IvLabs/HuroCup/Scrum/Cyberphysical Architecture2.jpg

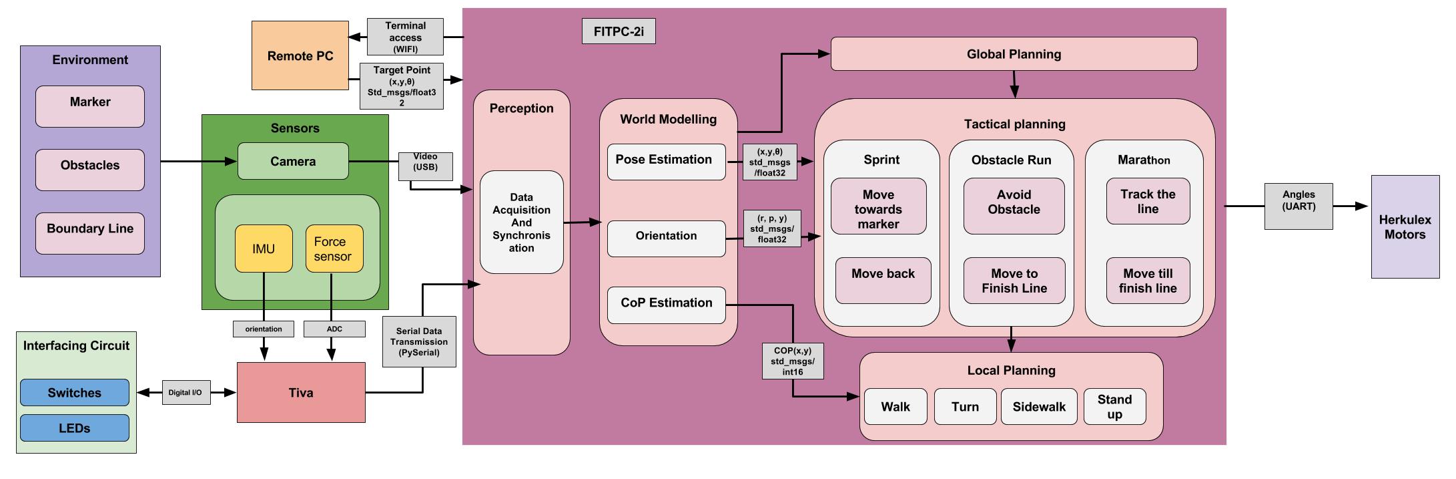
Scrum/Cyberphysical Architecture2.jpg
