IvLabs/HuroCup/Cad design/Simulated_Edit 2/tm4c.JPG

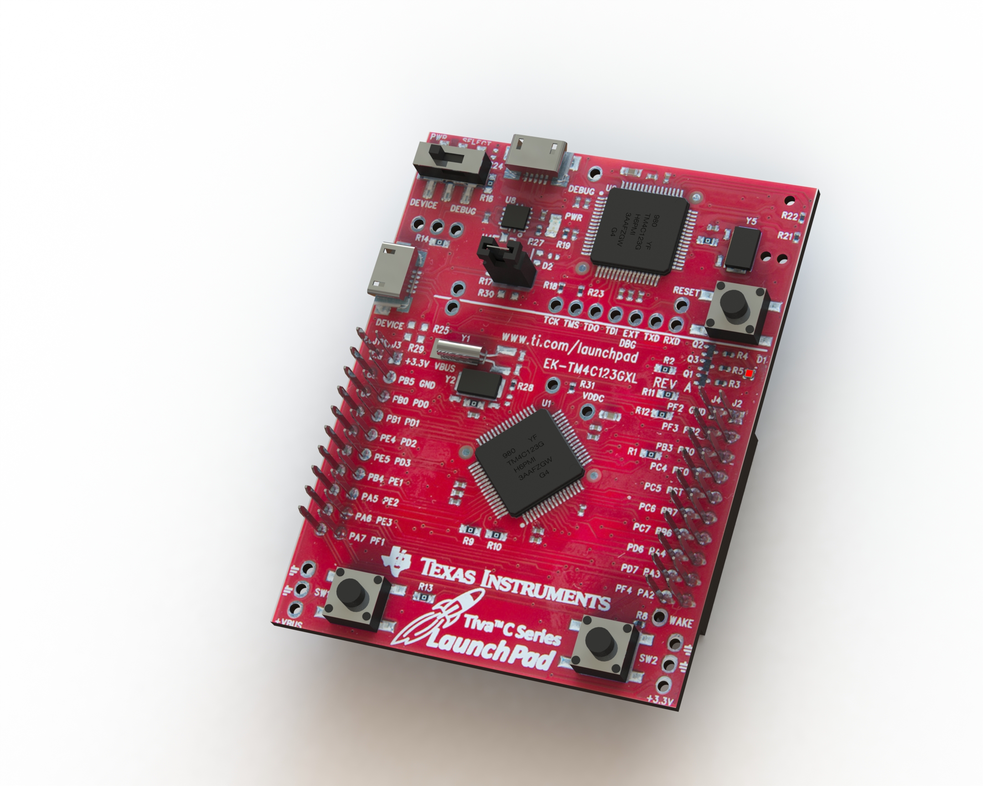
Cad design/Simulated_Edit 2/tm4c.JPG
