IvLabs/HuroCup/+Angles/swingfoot_traj.jpg

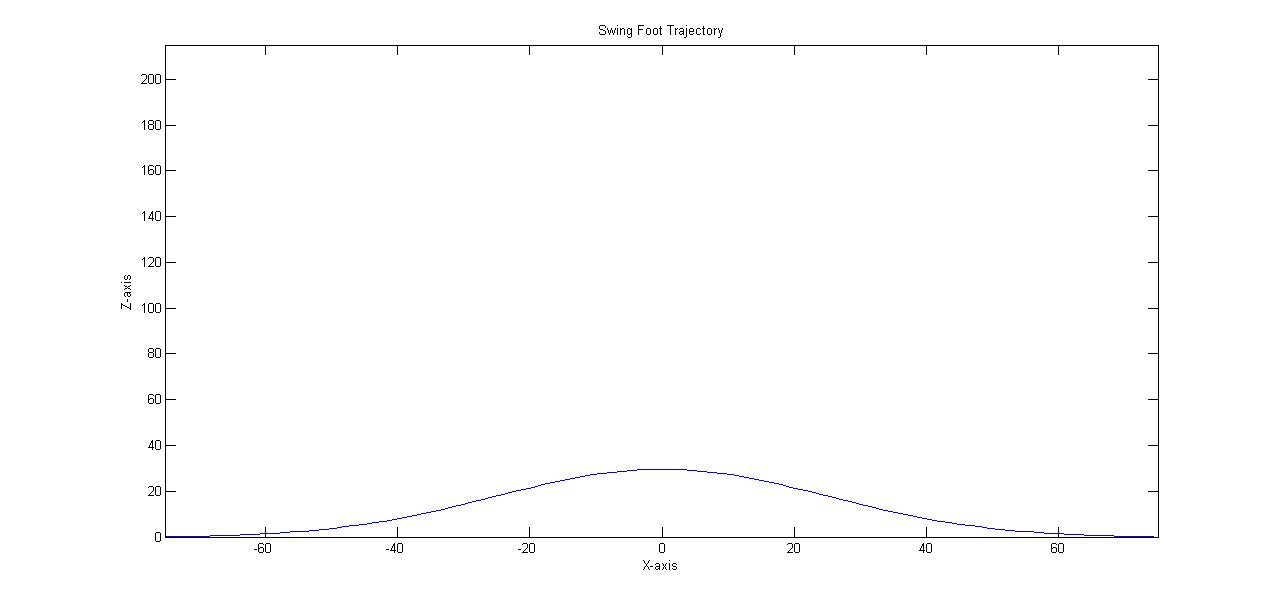
+Angles/swingfoot_traj.jpg
