IvLabs/HuroCup/+Angles/transformation_matrix.JPG

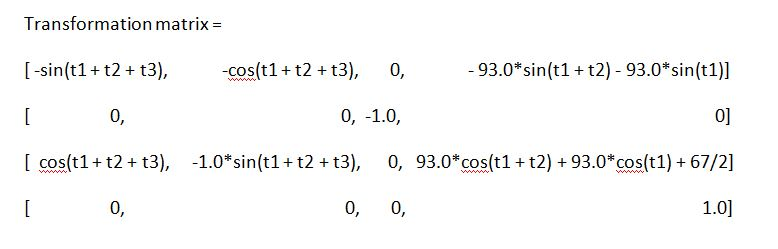
+Angles/transformation_matrix.JPG
