IvLabs/HuroCup/+Lipm/Getting ankle pitch using LIPM.jpg

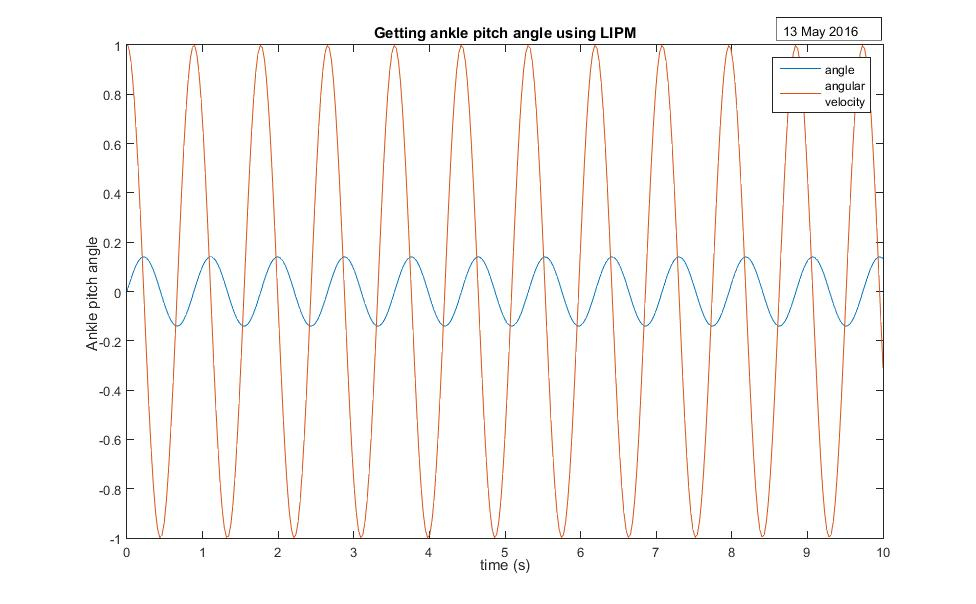
+Lipm/Getting ankle pitch using LIPM.jpg
