IvLabs/HuroCup/Circuit_Cad_Version-1.0/3.3Volts.JPG

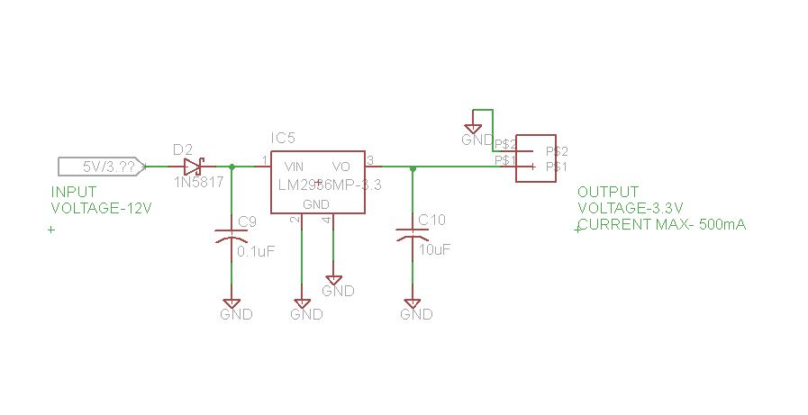
Circuit_Cad_Version-1.0/3.3Volts.JPG
