IvLabs/HuroCup/Circuit_Cad_Version-1.0/5Volts.JPG

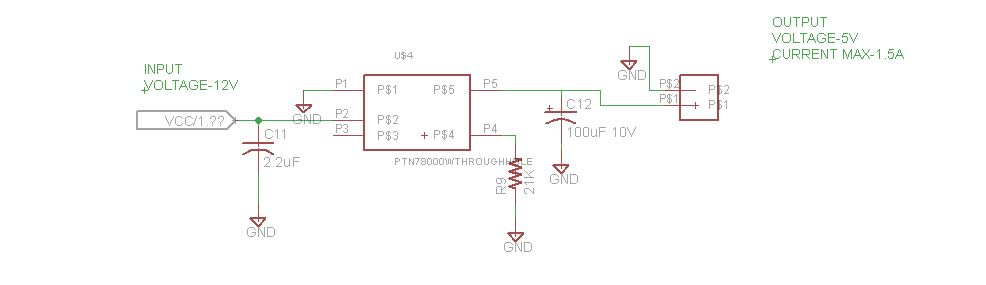
Circuit_Cad_Version-1.0/5Volts.JPG
