IvLabs/HuroCup/Circuit_Cad_Version-1.0/feedback_lipo.JPG

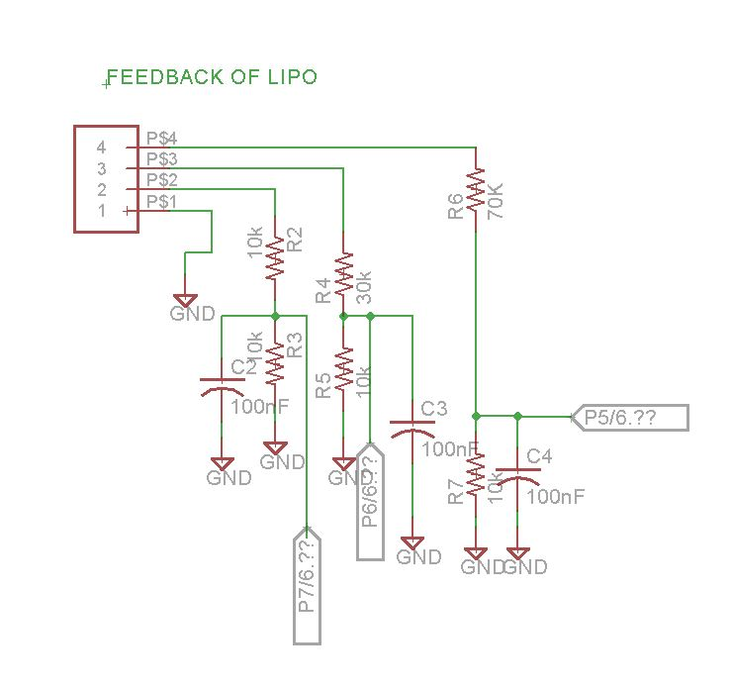
Circuit_Cad_Version-1.0/feedback_lipo.JPG
