IvLabs/HuroCup/Circuit_Cad_Version-1.0/Motors_Switching_Circuit.JPG

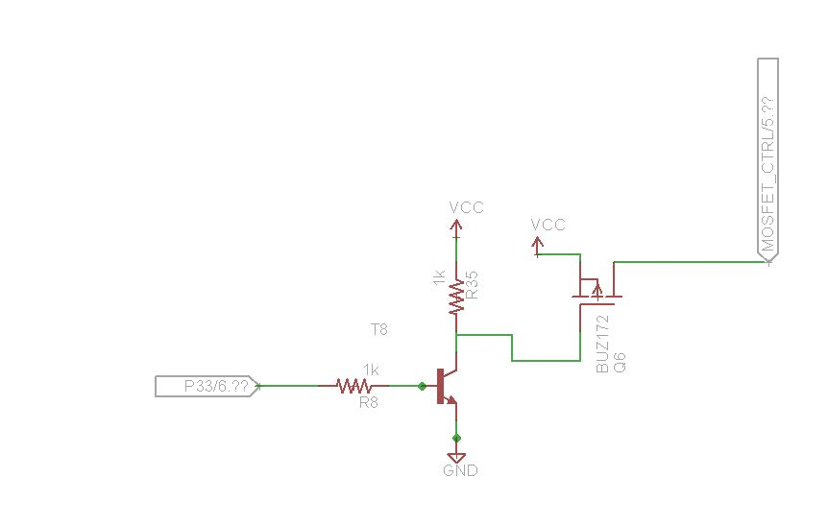
Circuit_Cad_Version-1.0/Motors_Switching_Circuit.JPG
