IvLabs/HuroCup/Circuit_Cad_Version-1.0/Pwr_INput.JPG

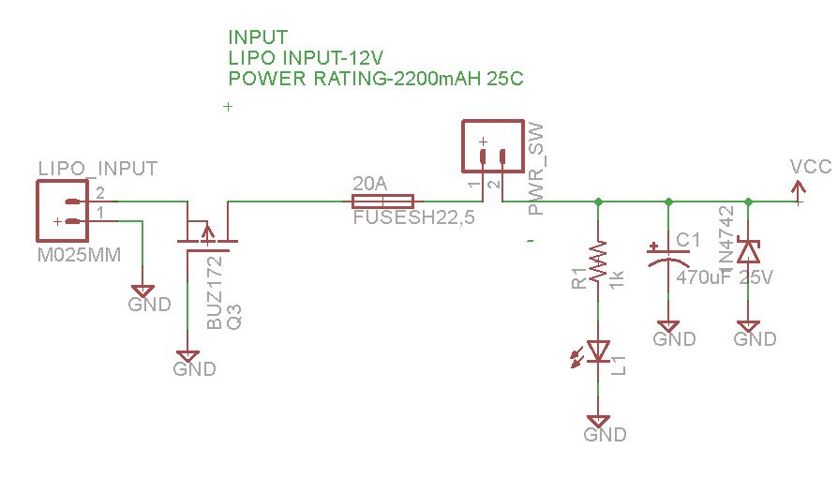
Circuit_Cad_Version-1.0/Pwr_INput.JPG
