IvLabs/HuroCup/Scrum/Functional Architecture2.jpg

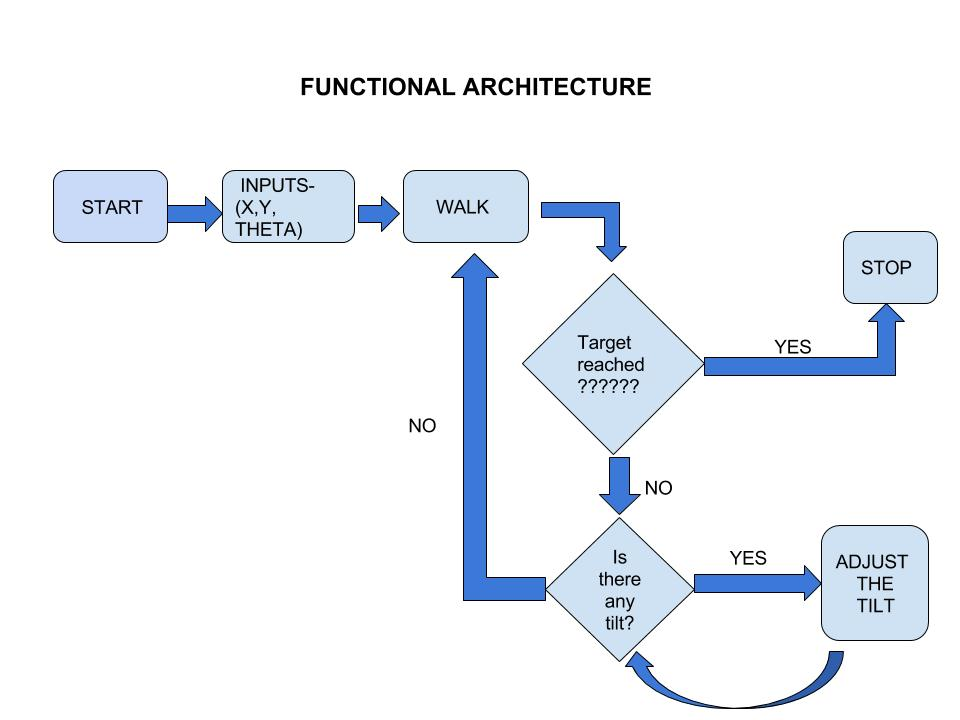
Scrum/Functional Architecture2.jpg
