IvLabs/HuroCup/Wiki/9110f1.gif

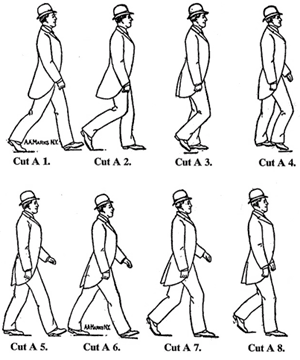
Wiki/9110f1.gif
