IvLabs/HuroCup/Wiki/9110f3.gif

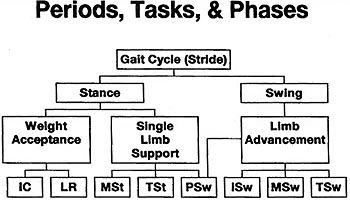
Wiki/9110f3.gif
