IvLabs/HuroCup/Wiki/9110f8.gif

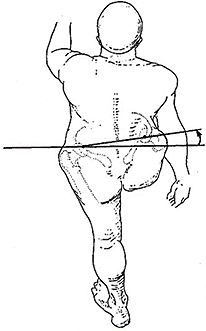
Wiki/9110f8.gif
