IvLabs/HuroCup/Wiki/9110f9.gif

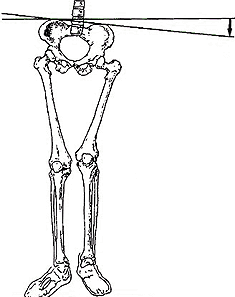
Wiki/9110f9.gif
