IvLabs/HuroCup/Wiki/9110f11.gif

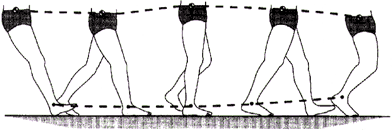
Wiki/9110f11.gif
