IvLabs/HuroCup/Wiki/Class Diagram.JPG

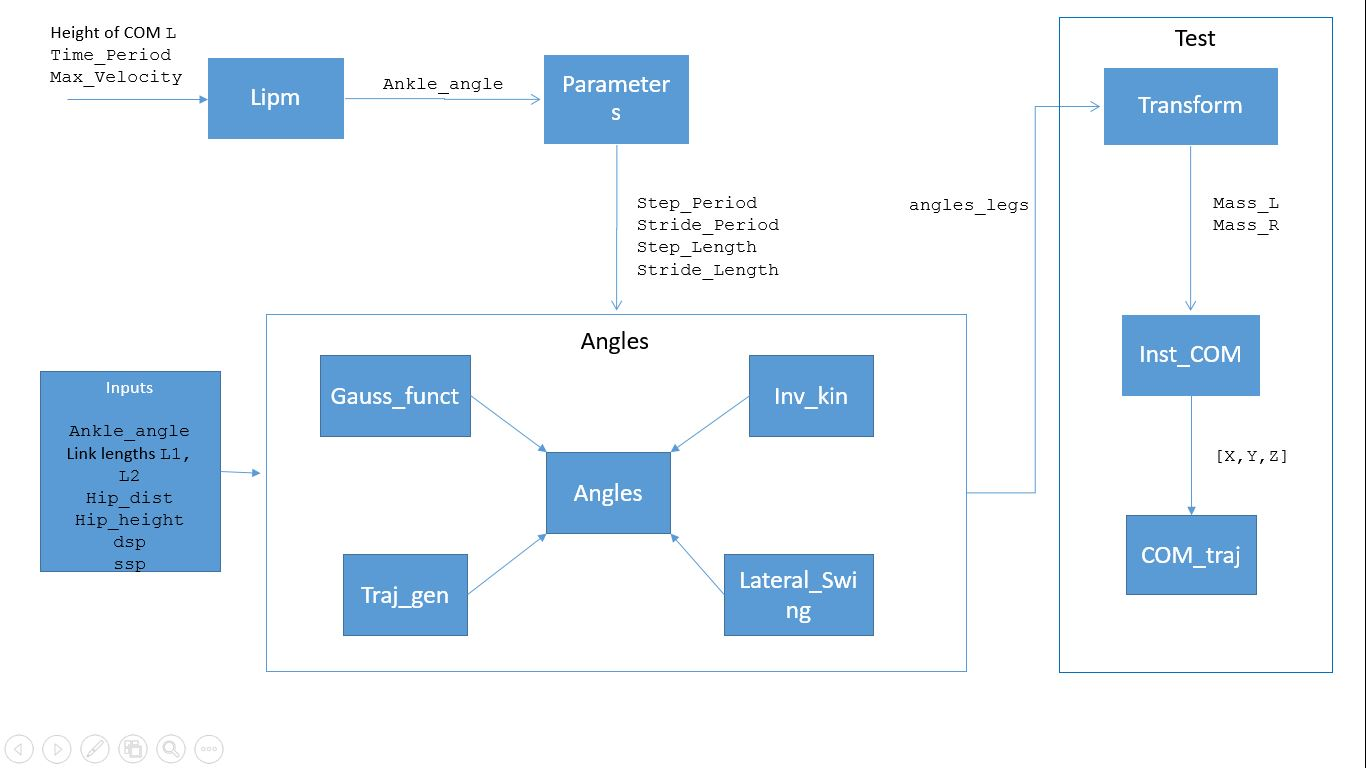
Wiki/Class Diagram.JPG
