IvLabs/HuroCup/Wiki/DH Parameters.JPG

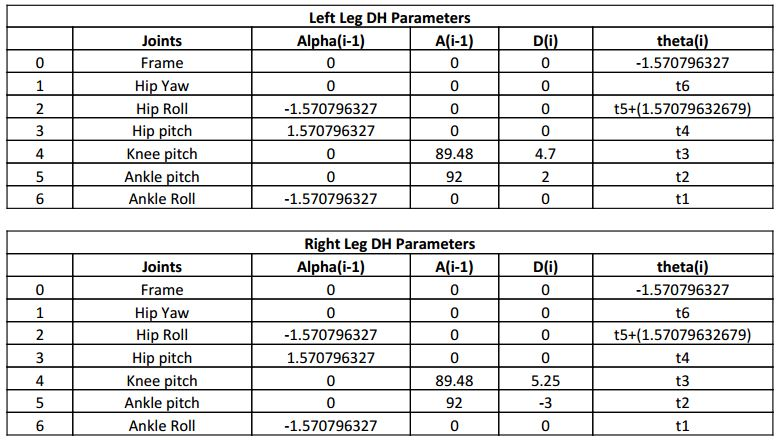
Wiki/DH Parameters.JPG
