IvLabs/HuroCup/Wiki/download.png

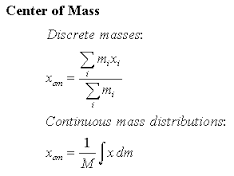
Wiki/download.png
