IvLabs/HuroCup/Wiki/Frames.png

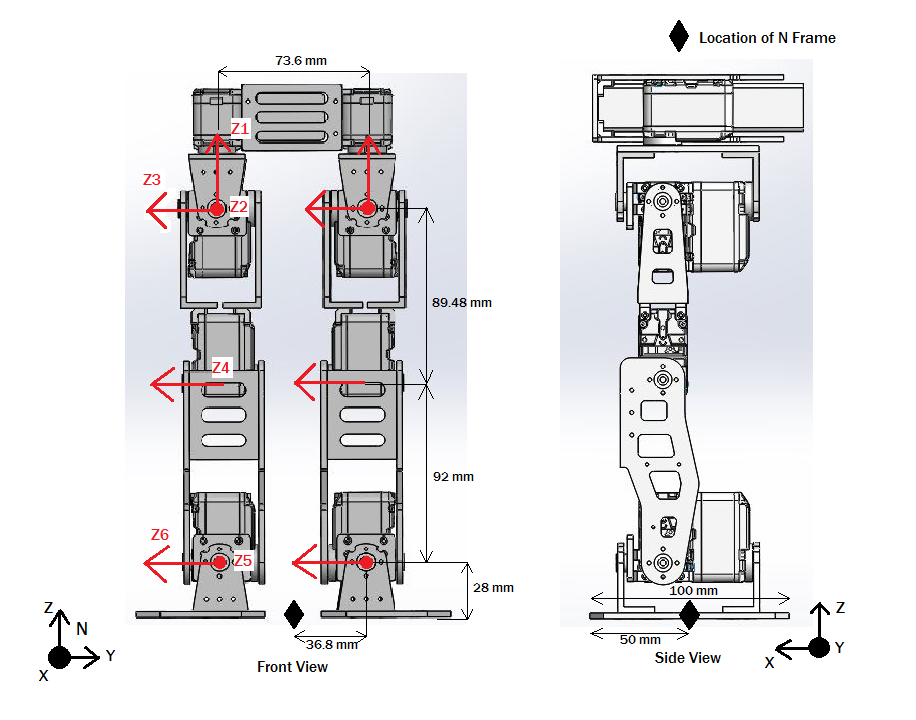
Wiki/Frames.png
