IvLabs/HuroCup/Wiki/Mass Matrix.JPG

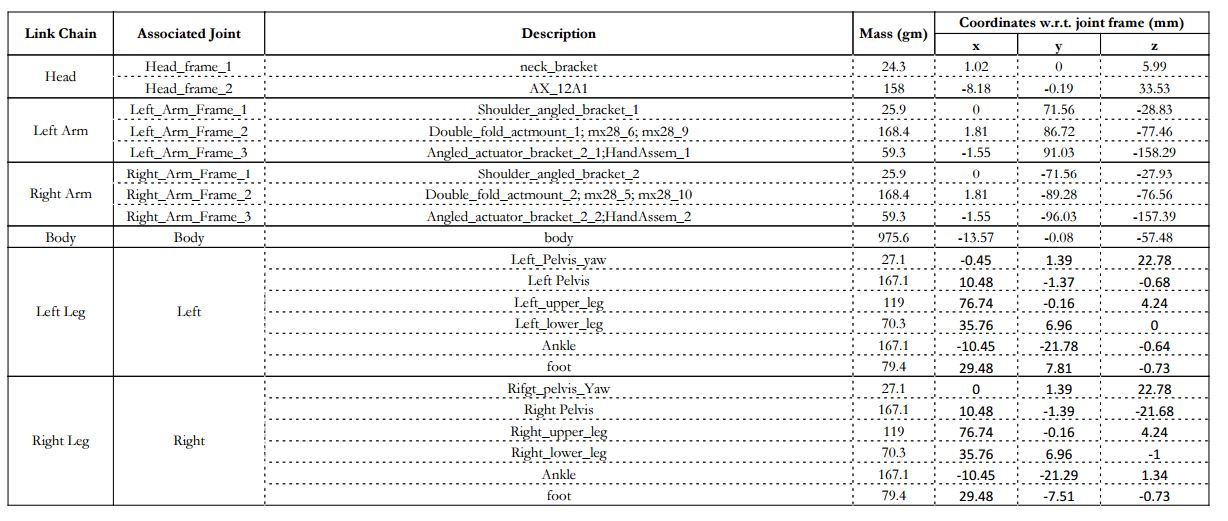
Wiki/Mass Matrix.JPG
