IvLabs/HuroCup/Wiki/Screenshot from 2016-06-23 09:11:17.png

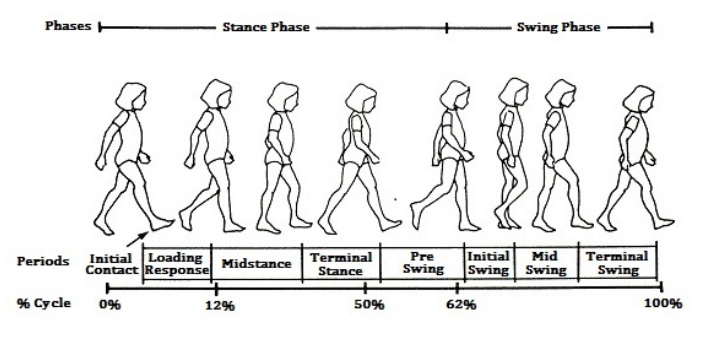
Wiki/Screenshot from 2016-06-23 09:11:17.png
