IvLabs/HuroCup/Wiki/transformation2.JPG

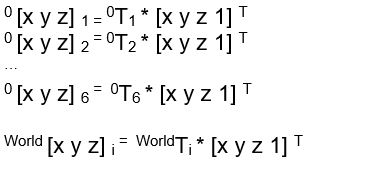
Wiki/transformation2.JPG
