IvLabs/HuroCup/Wiki/transformation.JPG

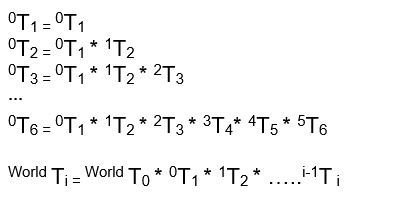
Wiki/transformation.JPG
