IvLabs/HuroCup/+Test/Mass_datasheet.xlsx

Link Chain | Associated Joint |  | Description | Mass (gm) | Coordinates w.r.t. joint frame (mm) |  |  | 72 | 60
 |  |  |  |  | x | y | z | 2.68 | 1.4
Head | Head_frame_1 | Head | neck_bracket | 24.3 | 1.02 | 0 | 5.99
 | Head_frame_2 |  | AX_12A1 | 158 | -8.18 | -0.19 | 33.53
Left Arm | Left_Arm_Frame_1 | Left | Shoulder_angled_bracket_1 | 25.9 | 0 | 71.56 | -28.83 | 1048.88 | Body
 | Left_Arm_Frame_2 |  | Double_fold_actmount_1; mx28_6; mx28_9 | 168.4 | 1.81 | 86.72 | -77.46 | 250 | Fitpc
 | Left_Arm_Frame_3 |  | Angled_actuator_bracket_2_1;HandAssem_1 | 59.3 | -1.55 | 91.03 | -158.29 | 150 | Battery
Right Arm | Right_Arm_Frame_1 | Right | Shoulder_angled_bracket_2 | 25.9 | 0 | -71.56 | -27.93
 | Right_Arm_Frame_2 |  | Double_fold_actmount_2; mx28_5; mx28_10 | 168.4 | 1.81 | -89.28 | -76.56
 | Right_Arm_Frame_3 |  | Angled_actuator_bracket_2_2;HandAssem_2 | 59.3 | -1.55 | -96.03 | -157.39
Body | Body | Body | body | 975.6 | -13.57 | -0.08 | -57.48
Left Leg | Left | Left | Left_Pelvis_yaw | 27.1 | -2.11 | 37 | -131.62 | 14.1567
 | Left |  | Left Pelvis | 167.1 | -25.18 | 35.63 | -164.88 | 132.014
Right Leg | Right |  | Left_upper_leg | 119 | -3.66 | 32.31 | -231.14 | 84.5522
 | Right |  | Left_lower_leg | 70.3 | 3.46 | 32.3 | -281.46 | 36.72
Left Leg | Left |  | Ankle | 167.1 | -25.28 | 30.94 | -328.25 | 132.014
 | Left |  | foot | 79.4 | -4.23 | 38.11 | -368.18 | 41.4776
 | Left | Right | Rifgt_pelvis_Yaw | 27.1 | -2.11 | -37 | -131.62
 | Left |  | Right Pelvis | 167.1 | -25.18 | -37.94 | -164.88
Right Leg | Right |  | Right_upper_leg | 119 | -3.66 | -40.79 | -231.14 | 1900 | Total
 | Right |  | Right_lower_leg | 70.3 | 3.46 | -40.8 | -281.46
 | Right |  | Ankle | 167.1 | -25.29 | -40.14 | -328.29
 | Right |  | foot | 79.4 | -4.23 | -46.31 | -368.18
