IvLabs/HuroCup/Cad design/Edition 0/Assem1.SLDASM

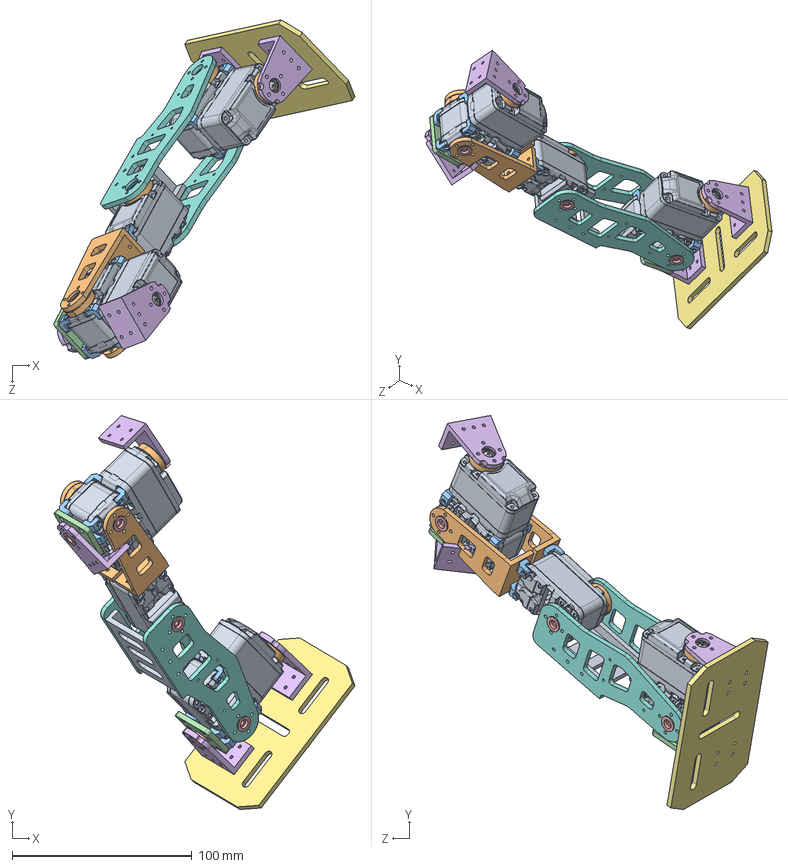
[picture p25: CAD file, 2016-07-12]
Cad design/Edition 0/Assem1.SLDASM
167.2 x 218.9 x 188.5 mm
Herkulex x 5
Herkulex horn x 5
L joint x 20
Bracket x 2
support x 5
3D ankle support flange x 4
foot
knee x 2
Knee bracket
upper leg x 2
