IvLabs/HuroCup/Cad design/Simulated_Edit 2/male headers/12x1_2,54mm_male_header/12x1_male_header_pin.SLDASM

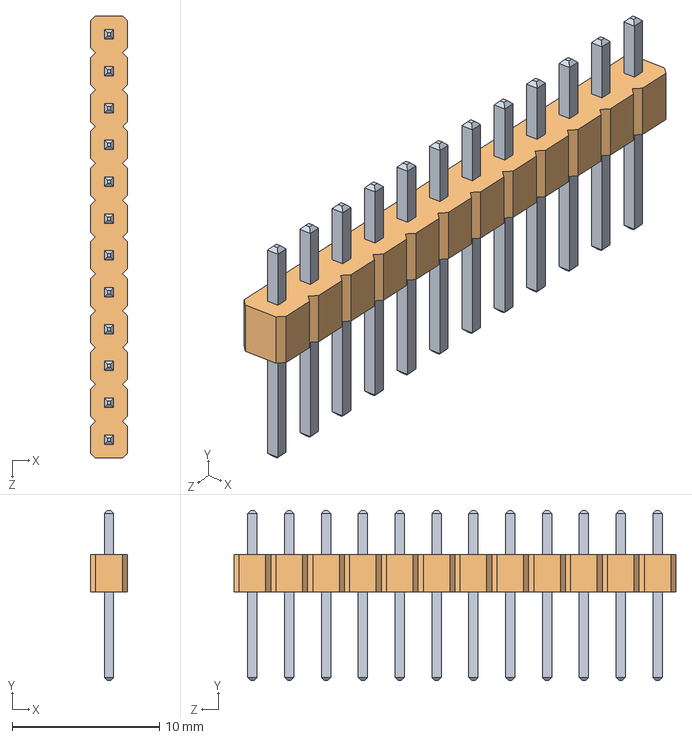
[picture p26: CAD file, 2016-07-12]
Cad design/Simulated_Edit 2/male headers/12x1_2,54mm_male_header/12x1_male_header_pin.SLDASM
2.54 x 11.5 x 30.0 mm
pin x 12
pin_body
