IvLabs/HuroCup/Cad design/Simulated_Edit 2/left foot.SLDASM

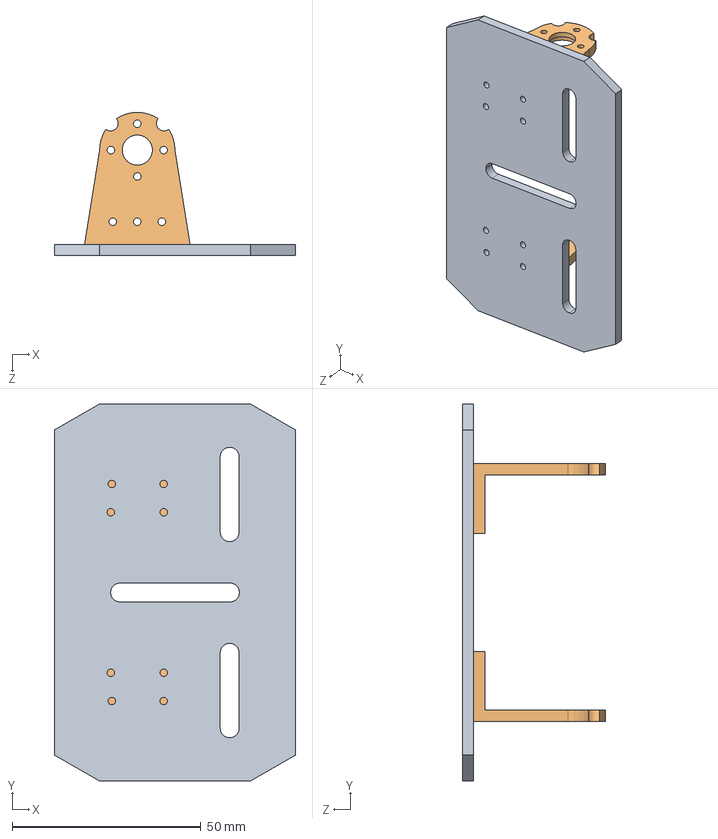
[picture p27: CAD file, 2016-07-30]
Cad design/Simulated_Edit 2/left foot.SLDASM
64.0 x 100.0 x 38.0 mm
foot
3D ankle support flange x 2
