IvLabs/HuroCup/Cad design/Simulated_Edition 3/gripper_assem.SLDASM

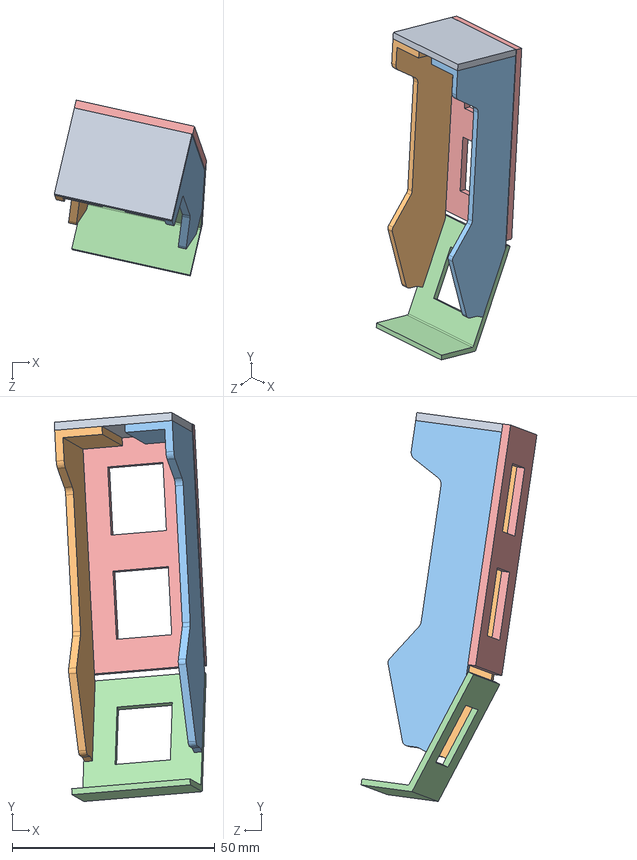
[picture p28: CAD file, 2016-07-30]
Cad design/Simulated_Edition 3/gripper_assem.SLDASM
37.6 x 95.9 x 43.4 mm
gripper base
gripper side
gripper side2
gripper_angled
gripper_mid
