IvLabs/HuroCup/Cad design/Simulated_Edit 2/motor1.SLDASM

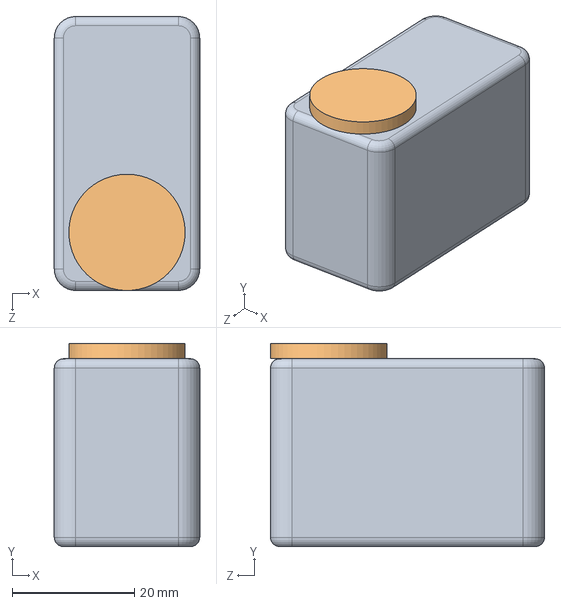
[picture p29: CAD file, 2016-07-30]
Cad design/Simulated_Edit 2/motor1.SLDASM
23.8 x 33.2 x 44.8 mm
horn1
