IvLabs/HuroCup/Cad design/Simulated_Edition 3/Herkulex Assem.SLDASM

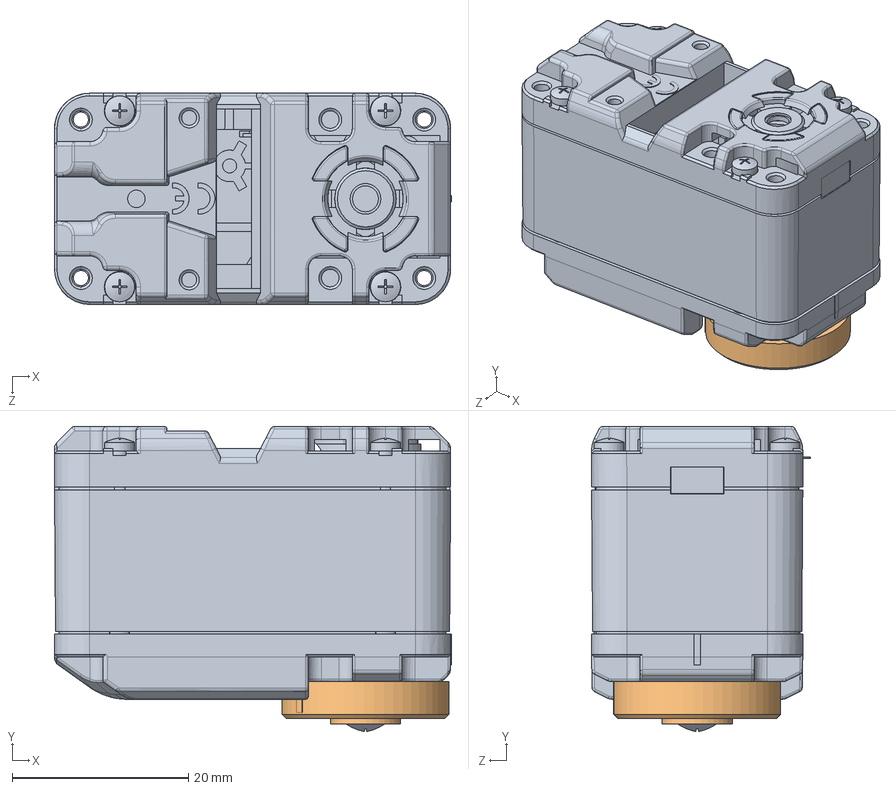
[picture p30: CAD file, 2016-07-14]
Cad design/Simulated_Edition 3/Herkulex Assem.SLDASM
45.1 x 34.7 x 24.9 mm
Herkulex
Herkulex horn
