IvLabs/HuroCup/Cad design/Simulated_Edit 2/gripper.SLDASM

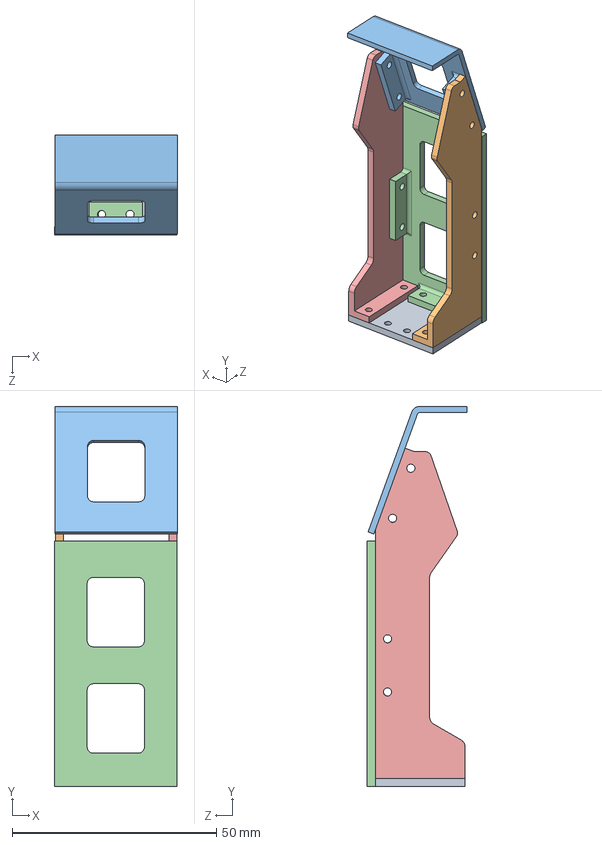
[picture p31: CAD file, 2016-07-18]
Cad design/Simulated_Edit 2/gripper.SLDASM
30.1 x 92.9 x 24.4 mm
gripper base
gripper side
gripper_angled
gripper_mid
gripper side2
