IvLabs/HuroCup/Cad design/Simulated_Edit 2/Left Leg.SLDASM

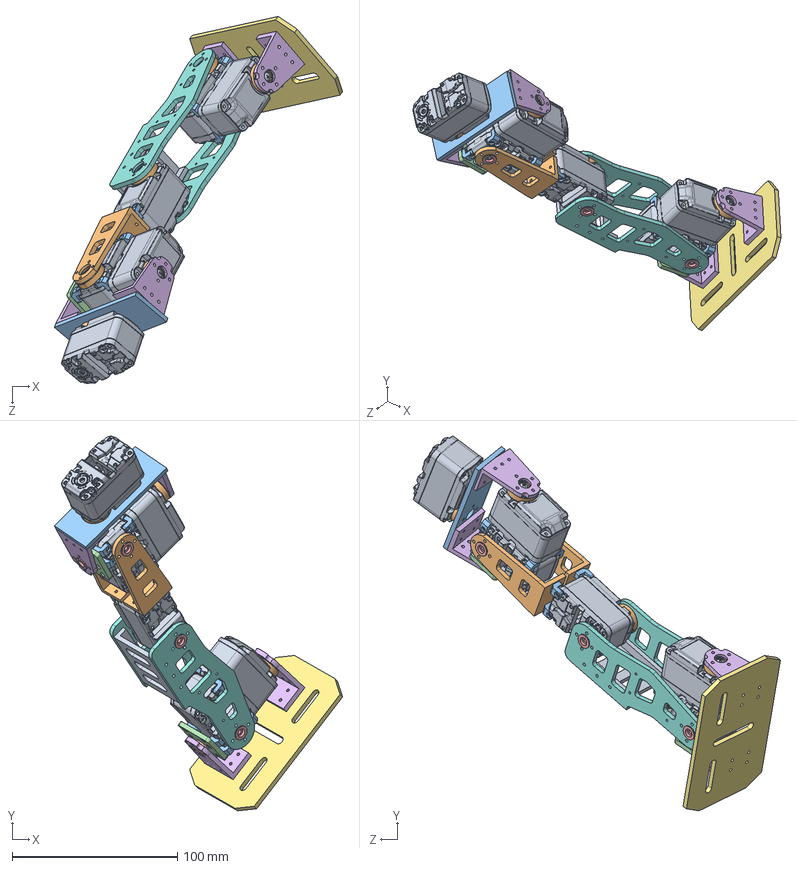
[picture p32: CAD file, 2016-07-03]
Cad design/Simulated_Edit 2/Left Leg.SLDASM
174.6 x 226.9 x 222.3 mm
Herkulex x 6
Herkulex horn x 6
L joint x 20
Bracket x 2
support x 5
3D ankle support flange x 4
foot
knee x 2
Knee bracket
upper leg x 2
hip plate
