IvLabs/HuroCup/Cad design/Simulated_Edit 2/male headers/12x1_2,54mm_male_header/pin_body.SLDPRT

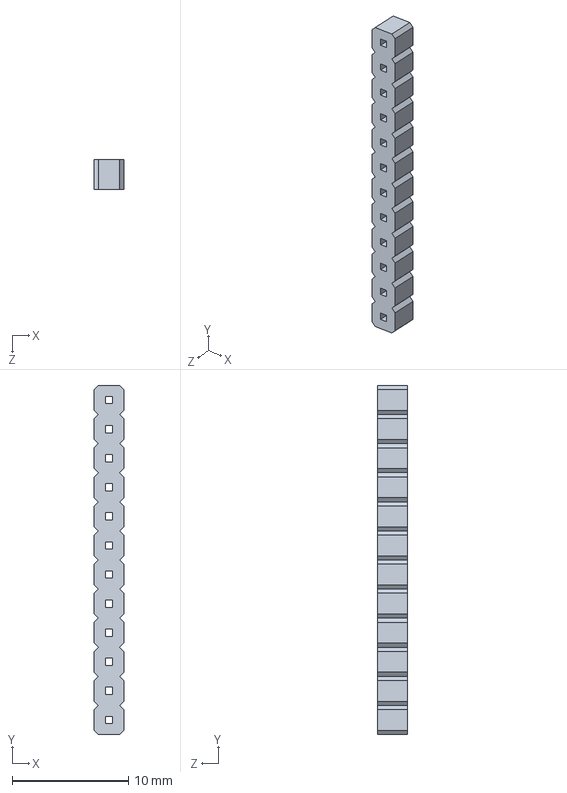
[picture p33: CAD file, 2016-07-12]
Cad design/Simulated_Edit 2/male headers/12x1_2,54mm_male_header/pin_body.SLDPRT
2.54 x 30.0 x 2.54 mm
