IvLabs/HuroCup/Cad design/Simulated_Edition 3/Fitpc.SLDPRT

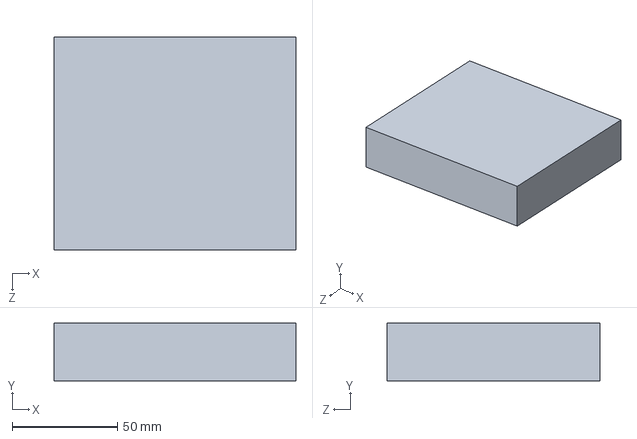
[picture p34: CAD file, 2016-07-30]
Cad design/Simulated_Edition 3/Fitpc.SLDPRT
115.0 x 27.5 x 101.0 mm
