IvLabs/HuroCup/Cad design/Simulated_Edition 3/foot.SLDPRT

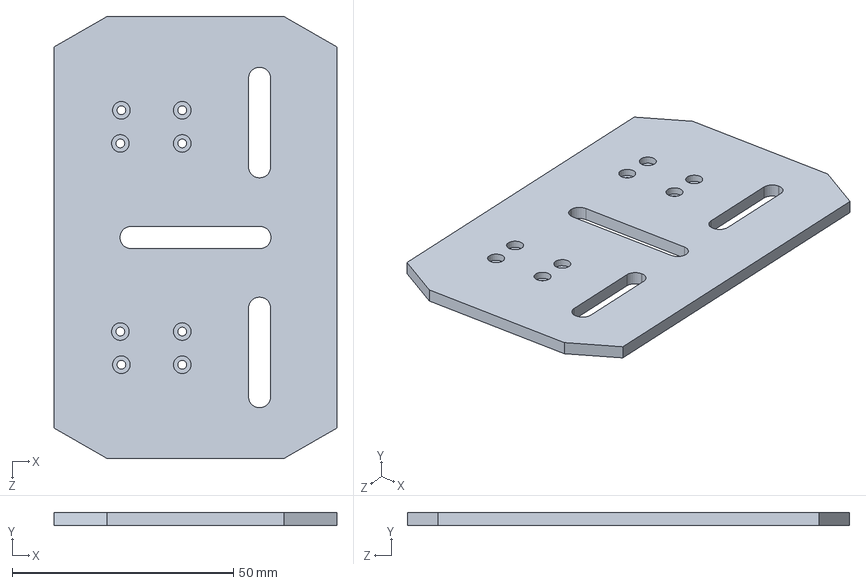
[picture p35: CAD file, 2016-07-30]
Cad design/Simulated_Edition 3/foot.SLDPRT
64.0 x 3.00 x 100.0 mm
