IvLabs/HuroCup/Cad design/Simulated_Edit 2/Knee bracket.SLDPRT

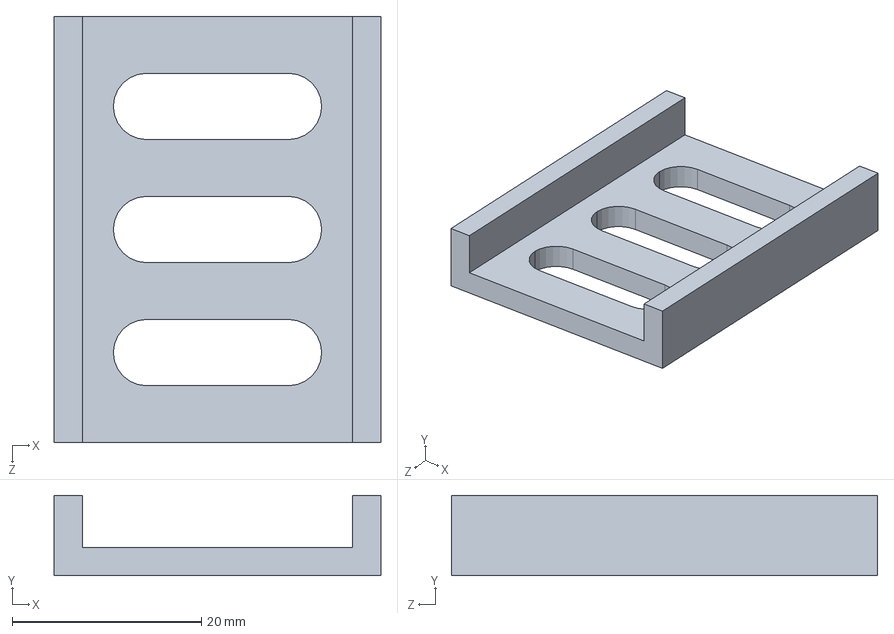
[picture p36: CAD file, 2016-07-30]
Cad design/Simulated_Edit 2/Knee bracket.SLDPRT
34.5 x 8.50 x 45.0 mm
