IvLabs/HuroCup/Cad design/Simulated_Edit 2/male headers/12x1_2,54mm_male_header/pin.SLDPRT

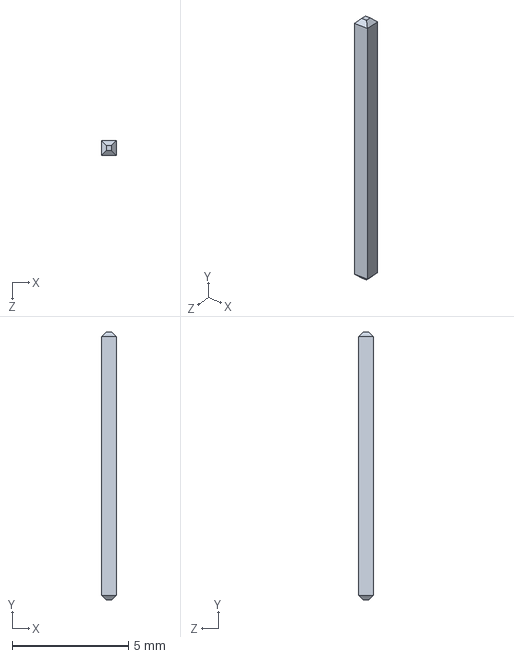
[picture p37: CAD file, 2016-07-12]
Cad design/Simulated_Edit 2/male headers/12x1_2,54mm_male_header/pin.SLDPRT
0.636 x 11.5 x 0.636 mm
