IvLabs/HuroCup/Cad design/Simulated_Edit 2/body1.SLDPRT

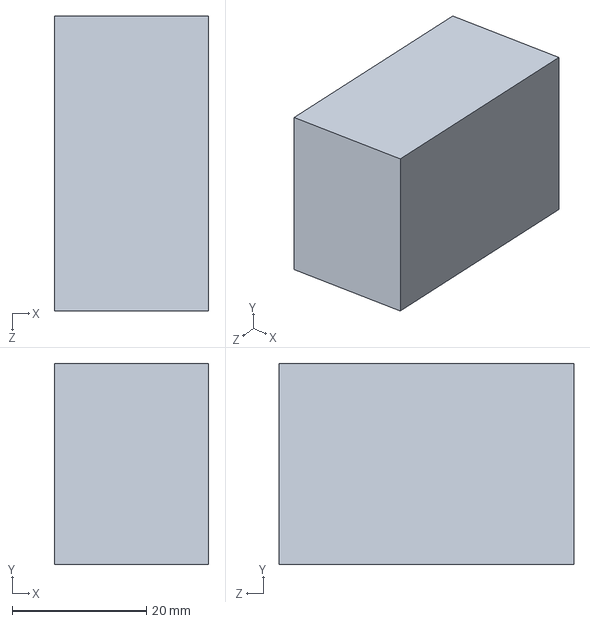
[picture p38: CAD file, 2016-07-30]
Cad design/Simulated_Edit 2/body1.SLDPRT
23.0 x 30.0 x 44.0 mm
