IvLabs/HuroCup/Cad design/Simulated_Edit 2/hip plate 2.SLDPRT

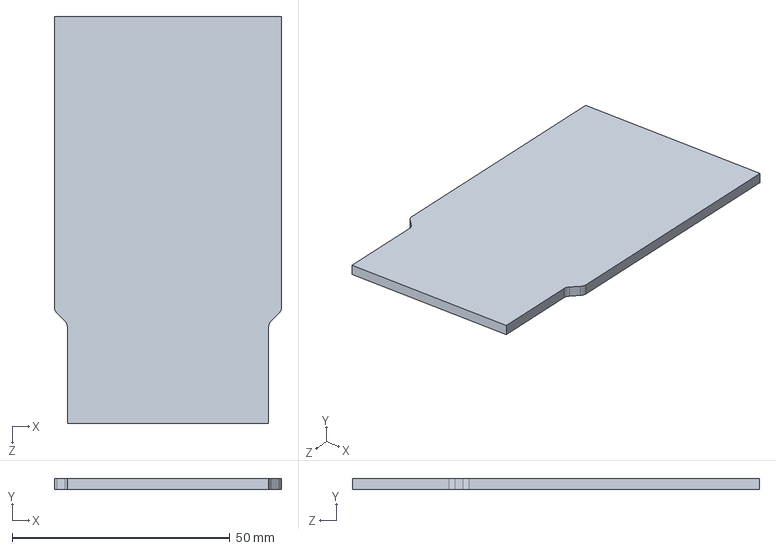
[picture p39: CAD file, 2016-07-30]
Cad design/Simulated_Edit 2/hip plate 2.SLDPRT
52.2 x 2.50 x 93.4 mm
