IvLabs/HuroCup/Cad design/Simulated_Edition 3/head side plate.SLDPRT

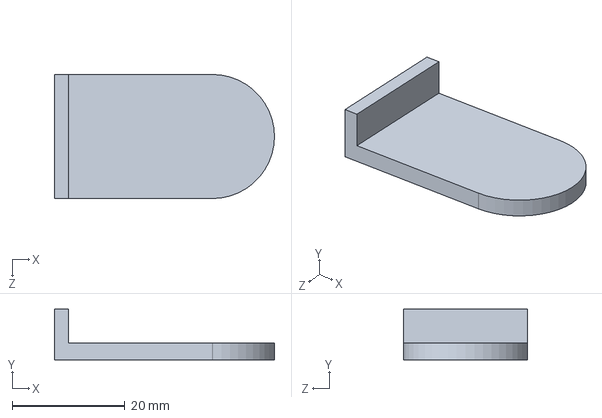
[picture p40: CAD file, 2016-07-30]
Cad design/Simulated_Edition 3/head side plate.SLDPRT
39.0 x 9.00 x 22.0 mm
