IvLabs/HuroCup/Cad design/Simulated_Edit 2/Fitpc front.SLDPRT

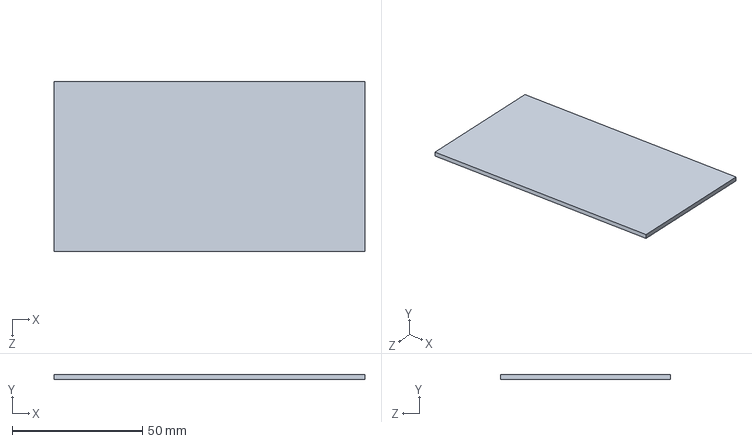
[picture p41: CAD file, 2016-07-30]
Cad design/Simulated_Edit 2/Fitpc front.SLDPRT
119.2 x 2.00 x 65.0 mm
