IvLabs/HuroCup/Cad design/Simulated_Edition 3/gripper_angled.SLDPRT

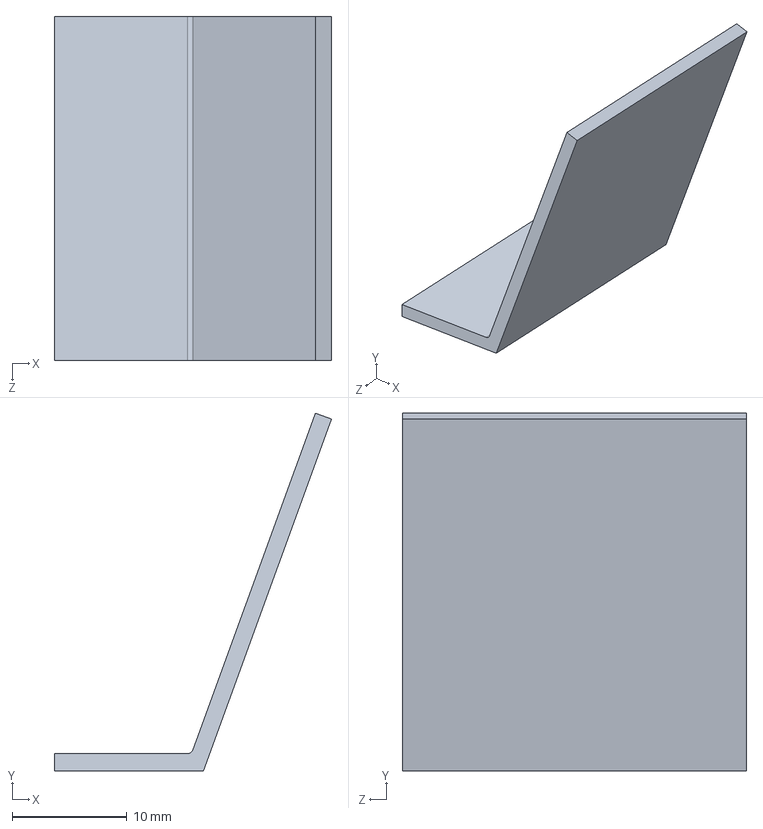
[picture p42: CAD file, 2016-07-30]
Cad design/Simulated_Edition 3/gripper_angled.SLDPRT
24.2 x 31.2 x 30.0 mm
