IvLabs/HuroCup/Cad design/Simulated_Edit 2/upper leg.SLDPRT

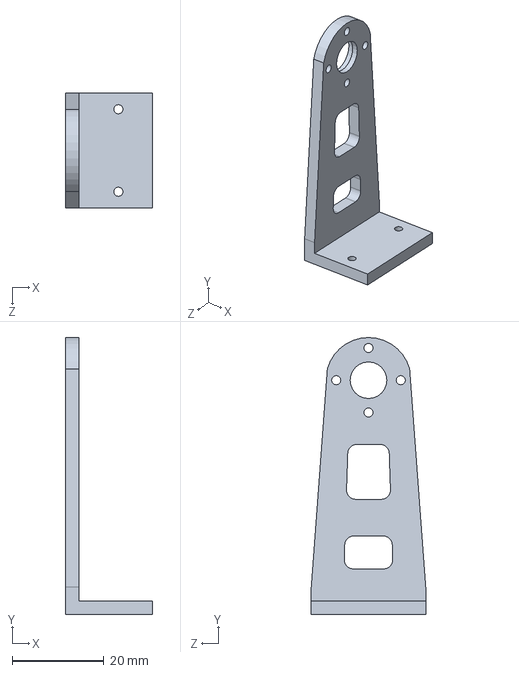
[picture p43: CAD file, 2016-07-30]
Cad design/Simulated_Edit 2/upper leg.SLDPRT
19.0 x 60.5 x 25.0 mm
