IvLabs/HuroCup/Cad design/Simulated_Edition 3/Fitpc front.sldprt

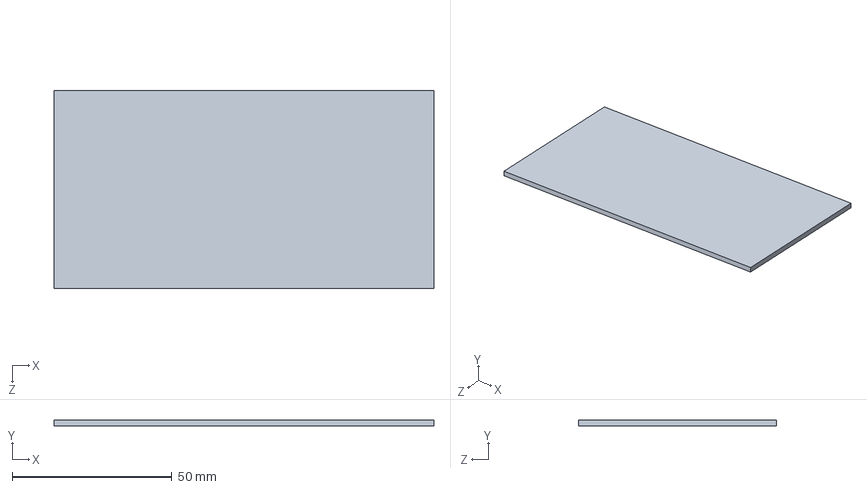
[picture p44: CAD file, 2016-07-30]
Cad design/Simulated_Edition 3/Fitpc front.sldprt
119.0 x 2.00 x 62.0 mm
