IvLabs/HuroCup/Cad design/Simulated_Edit 2/horn1.SLDPRT

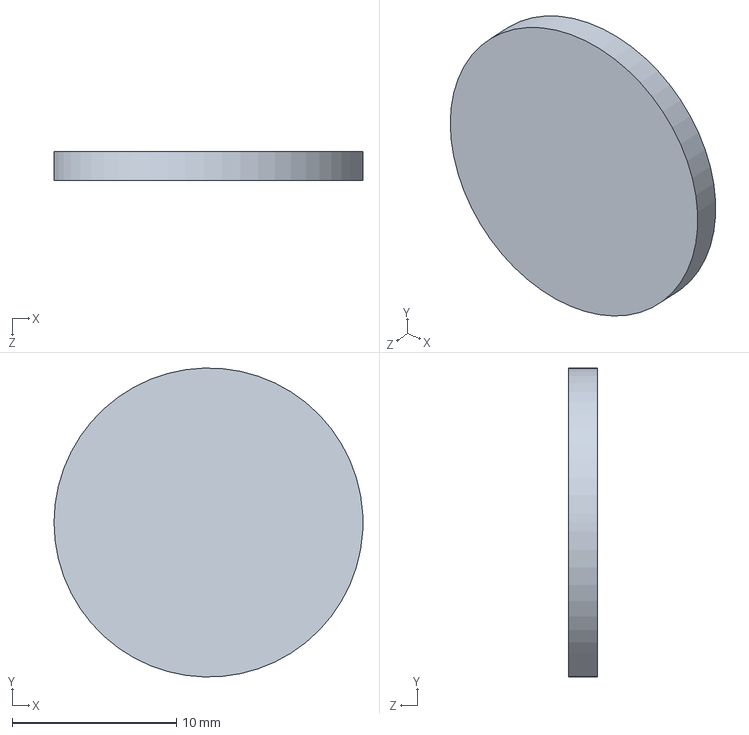
[picture p45: CAD file, 2016-07-30]
Cad design/Simulated_Edit 2/horn1.SLDPRT
18.8 x 18.8 x 1.75 mm
