IvLabs/HuroCup/Cad design/Simulated_Edit 2/3D ankle support flange.SLDPRT

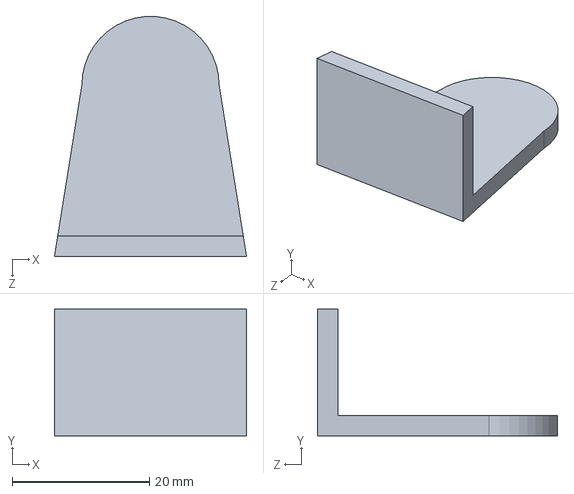
[picture p46: CAD file, 2016-07-30]
Cad design/Simulated_Edit 2/3D ankle support flange.SLDPRT
28.0 x 18.5 x 35.0 mm
