IvLabs/HuroCup/Cad design/Simulated_Edition 3/arm plate.sldprt

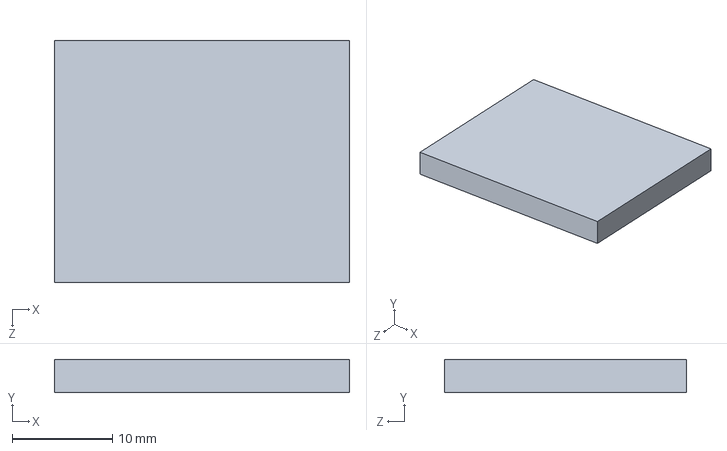
[picture p47: CAD file, 2016-07-30]
Cad design/Simulated_Edition 3/arm plate.sldprt
29.4 x 3.30 x 24.1 mm
