IvLabs/HuroCup/Cad design/Simulated_Edit 2/knee.SLDPRT

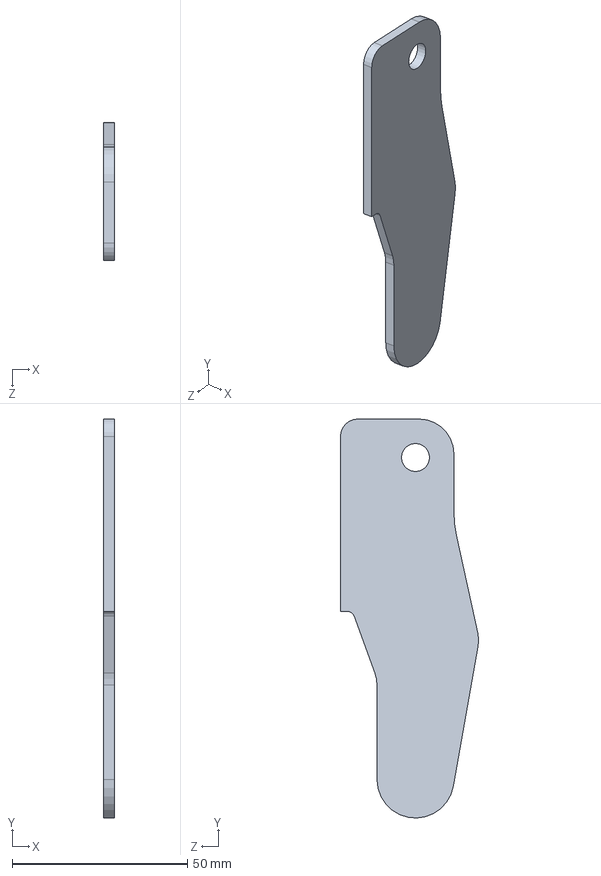
[picture p48: CAD file, 2016-07-30]
Cad design/Simulated_Edit 2/knee.SLDPRT
3.00 x 114.0 x 39.5 mm
