IvLabs/HuroCup/Cad design/Simulated_Edition 3/gripper base.SLDPRT

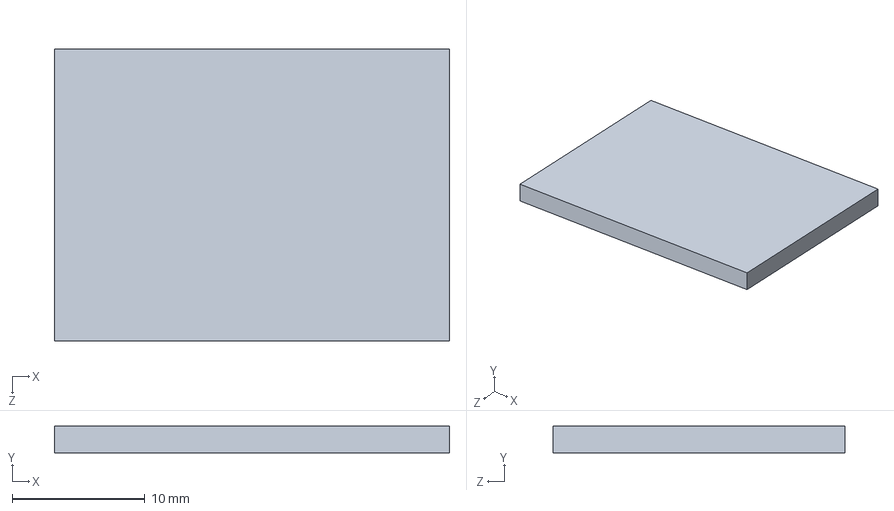
[picture p49: CAD file, 2016-07-30]
Cad design/Simulated_Edition 3/gripper base.SLDPRT
29.8 x 2.00 x 22.0 mm
