IvLabs/HuroCup/Cad design/Simulated_Edit 2/Fitpc base.SLDPRT

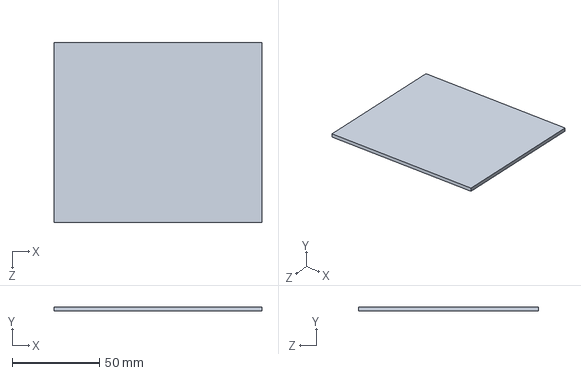
[picture p50: CAD file, 2016-07-30]
Cad design/Simulated_Edit 2/Fitpc base.SLDPRT
119.0 x 2.50 x 103.0 mm
