IvLabs/HuroCup/Cad design/Simulated_Edition 3/Fitpc side plate.sldprt

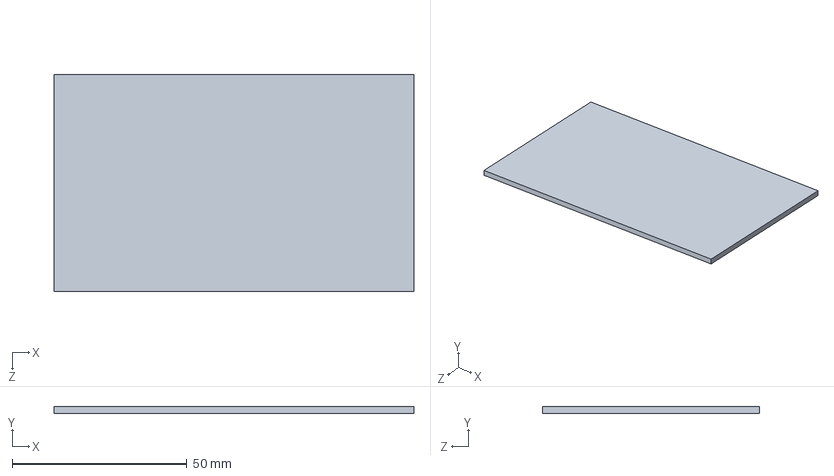
[picture p51: CAD file, 2016-07-30]
Cad design/Simulated_Edition 3/Fitpc side plate.sldprt
103.0 x 2.00 x 62.0 mm
