IvLabs/HuroCup/Cad design/Simulated_Edition 3/Bracket.SLDPRT

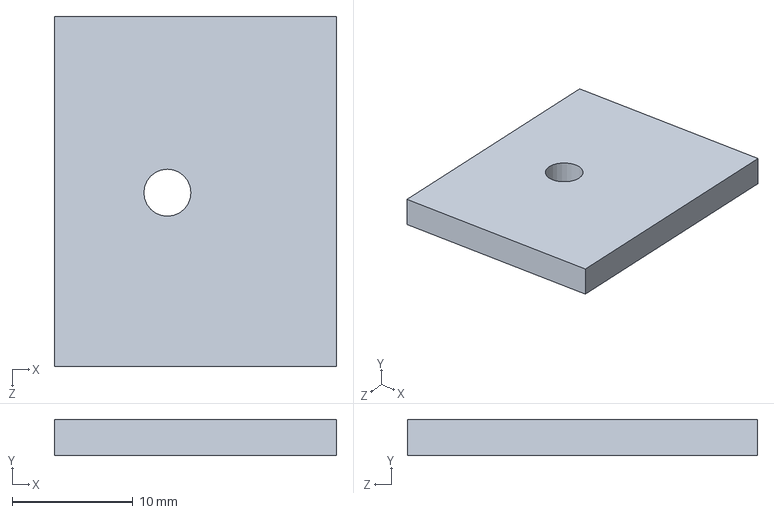
[picture p52: CAD file, 2016-07-30]
Cad design/Simulated_Edition 3/Bracket.SLDPRT
23.4 x 3.00 x 29.0 mm
