IvLabs/HuroCup/Cad design/Simulated_Edit 2/lipo.SLDPRT

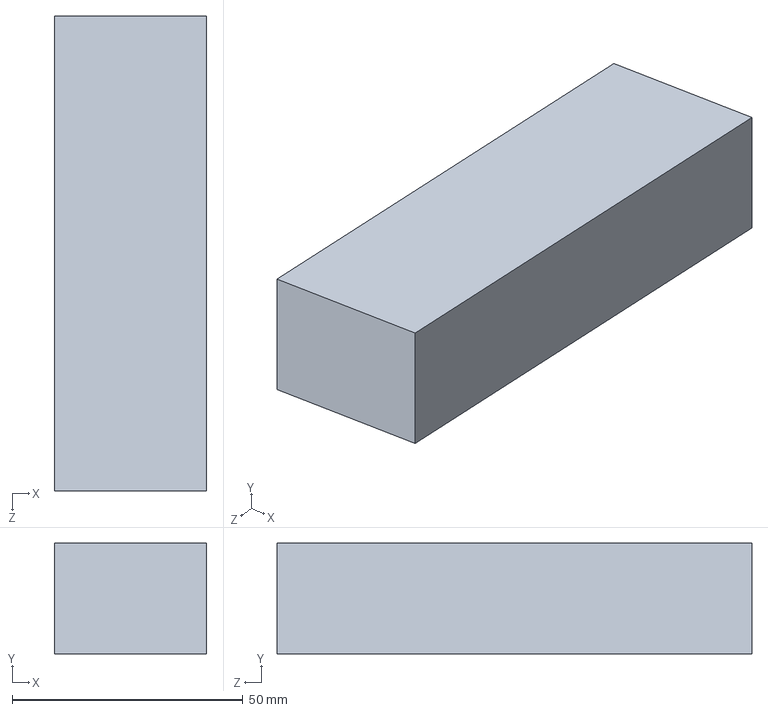
[picture p53: CAD file, 2016-07-30]
Cad design/Simulated_Edit 2/lipo.SLDPRT
33.0 x 24.0 x 103.0 mm
