IvLabs/HuroCup/Cad design/Simulated_Edit 2/hip plate.SLDPRT

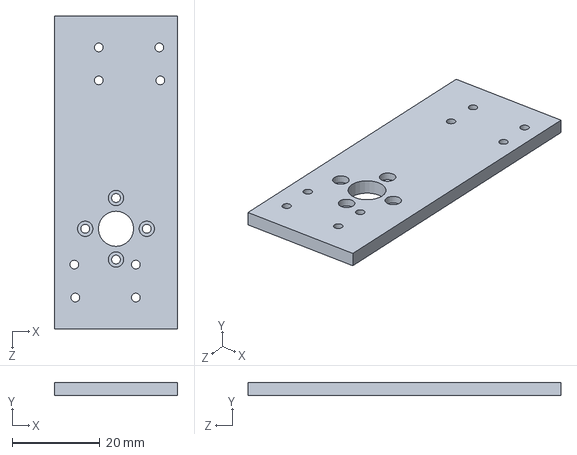
[picture p54: CAD file, 2016-07-30]
Cad design/Simulated_Edit 2/hip plate.SLDPRT
28.0 x 3.00 x 71.2 mm
