IvLabs/HuroCup/Cad design/Simulated_Edition 3/Fitpc base.SLDPRT

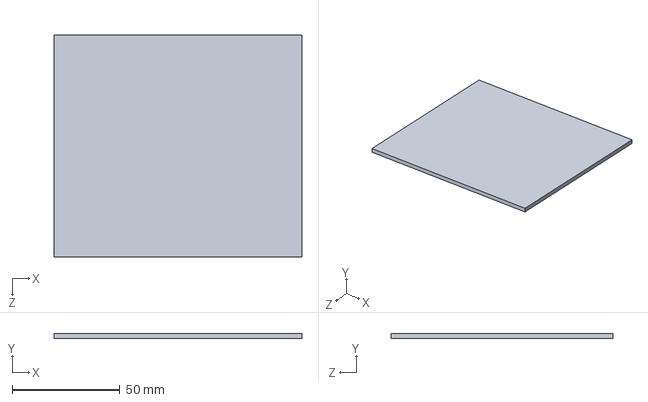
[picture p55: CAD file, 2016-07-30]
Cad design/Simulated_Edition 3/Fitpc base.SLDPRT
115.0 x 2.50 x 103.0 mm
