IvLabs/HuroCup/Cad design/Simulated_Edit 2/battery support.SLDPRT

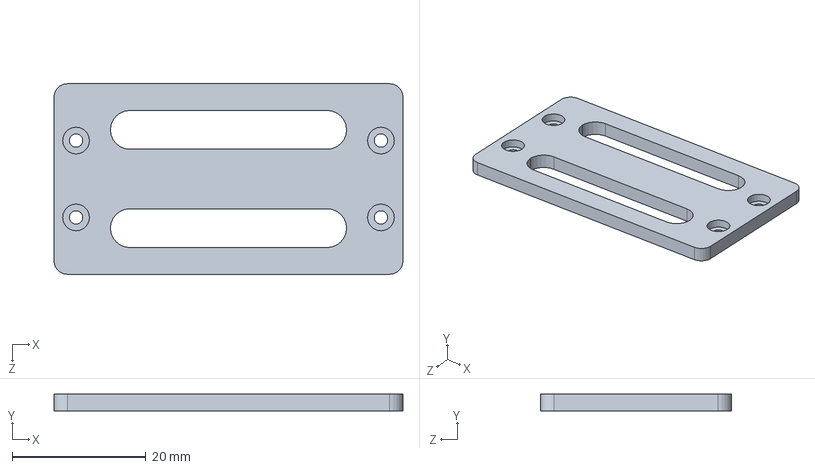
[picture p56: CAD file, 2016-07-30]
Cad design/Simulated_Edit 2/battery support.SLDPRT
52.2 x 2.50 x 28.5 mm
