IvLabs/HuroCup/Cad design/Simulated_Edit 2/Custom PCB.SLDPRT

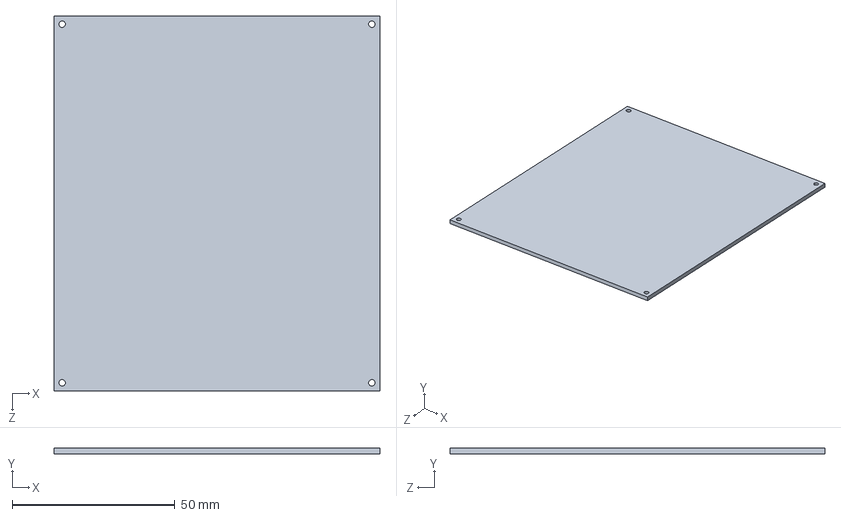
[picture p57: CAD file, 2016-07-18]
Cad design/Simulated_Edit 2/Custom PCB.SLDPRT
100.0 x 1.70 x 115.0 mm
