IvLabs/HuroCup/Cad design/Simulated_Edit 2/head side plate.SLDPRT

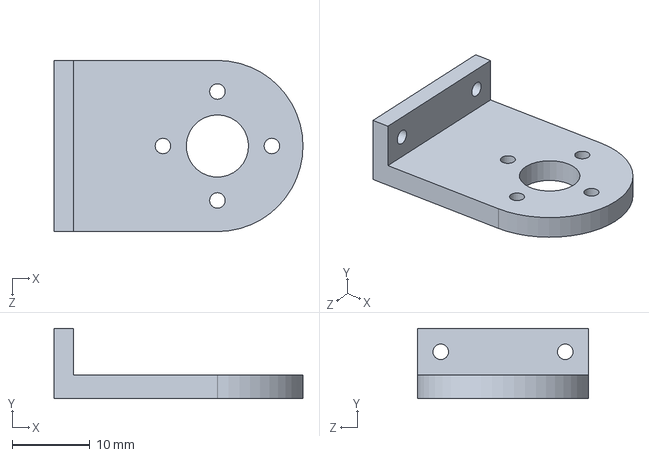
[picture p58: CAD file, 2016-07-18]
Cad design/Simulated_Edit 2/head side plate.SLDPRT
32.0 x 9.00 x 22.0 mm
