IvLabs/HuroCup/Cad design/Simulated_Edition 3/gripper side2.SLDPRT

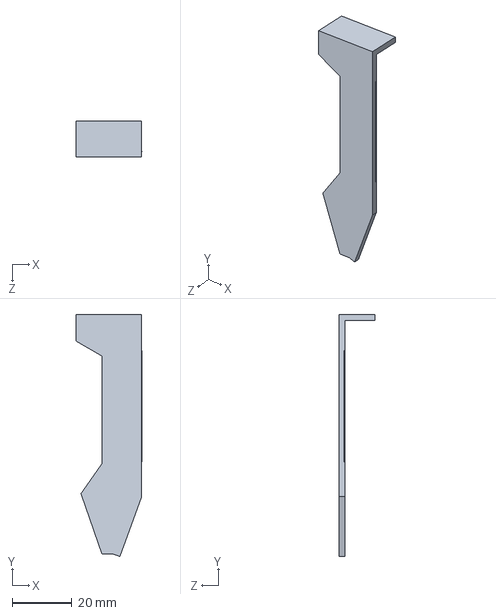
[picture p59: CAD file, 2016-07-30]
Cad design/Simulated_Edition 3/gripper side2.SLDPRT
22.1 x 80.8 x 12.0 mm
