IvLabs/HuroCup/Cad design/Simulated_Edit 2/shoulder2.SLDPRT

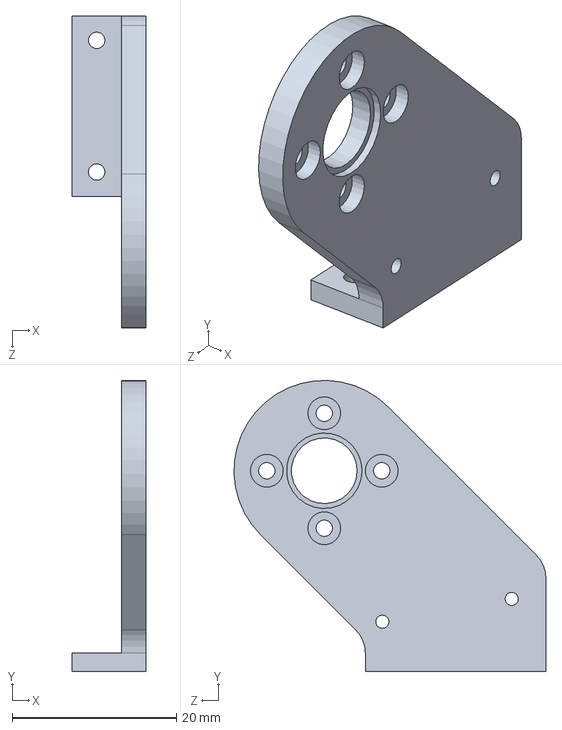
[picture p60: CAD file, 2016-07-18]
Cad design/Simulated_Edit 2/shoulder2.SLDPRT
9.00 x 35.4 x 38.0 mm
