IvLabs/HuroCup/Cad design/Simulated_Edition 3/gripper_mid.SLDPRT

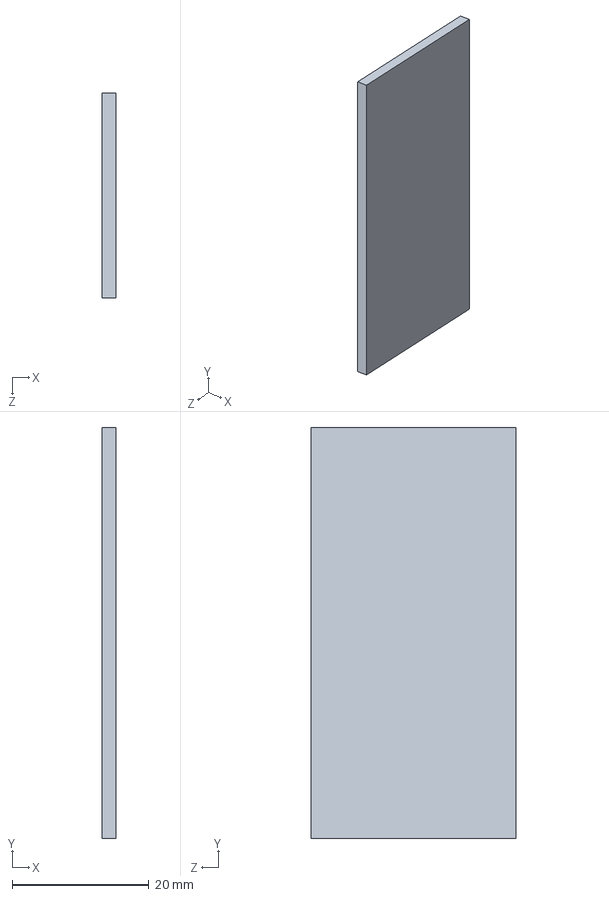
[picture p61: CAD file, 2016-07-30]
Cad design/Simulated_Edition 3/gripper_mid.SLDPRT
2.00 x 60.1 x 30.0 mm
