IvLabs/HuroCup/Cad design/Simulated_Edit 2/Fitpc back.SLDPRT

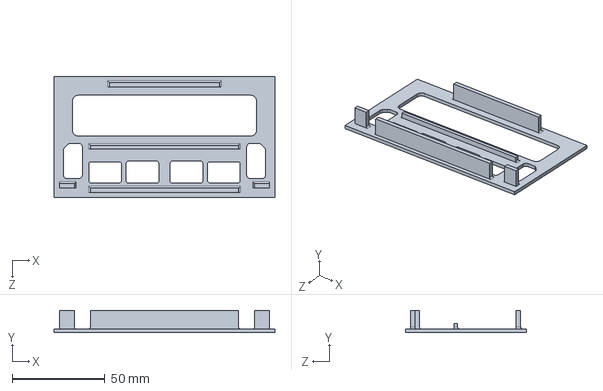
[picture p62: CAD file, 2016-07-18]
Cad design/Simulated_Edit 2/Fitpc back.SLDPRT
119.2 x 12.0 x 65.0 mm
