IvLabs/HuroCup/Cad design/Simulated_Edit 2/gripper_angled.SLDPRT

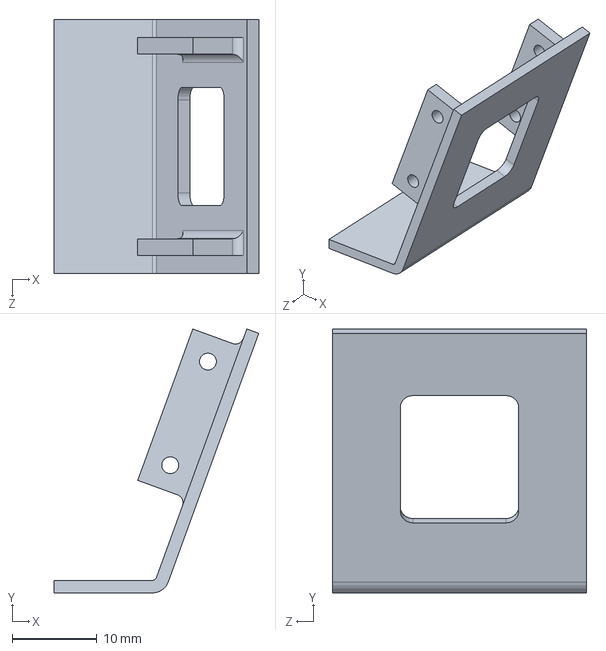
[picture p63: CAD file, 2016-07-18]
Cad design/Simulated_Edit 2/gripper_angled.SLDPRT
24.2 x 31.2 x 30.0 mm
