IvLabs/HuroCup/Cad design/Simulated_Edit 2/Fitpc Top.SLDPRT

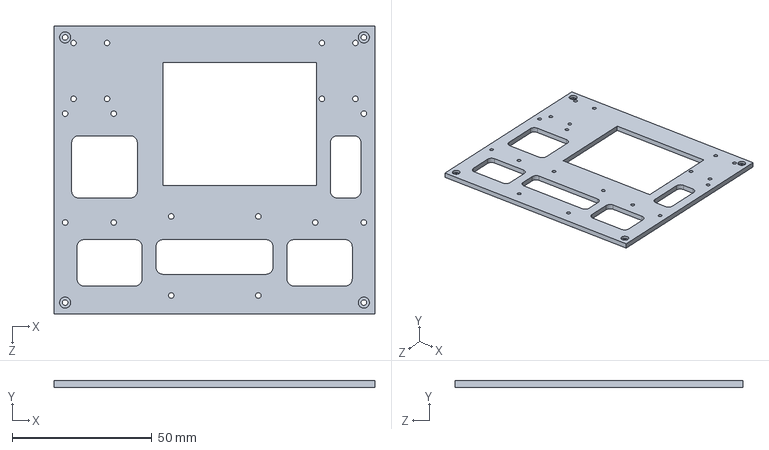
[picture p64: CAD file, 2016-07-18]
Cad design/Simulated_Edit 2/Fitpc Top.SLDPRT
115.0 x 2.50 x 103.0 mm
