IvLabs/HuroCup/Cad design/Simulated_Edit 2/gripper base.SLDPRT

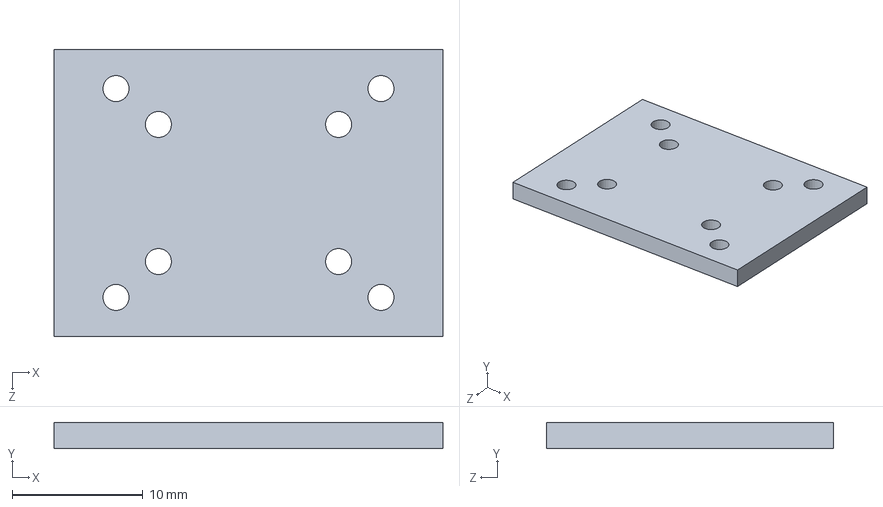
[picture p65: CAD file, 2016-07-18]
Cad design/Simulated_Edit 2/gripper base.SLDPRT
29.8 x 2.00 x 22.0 mm
