IvLabs/HuroCup/Cad design/Simulated_Edition 3/ankle support flange.SLDPRT

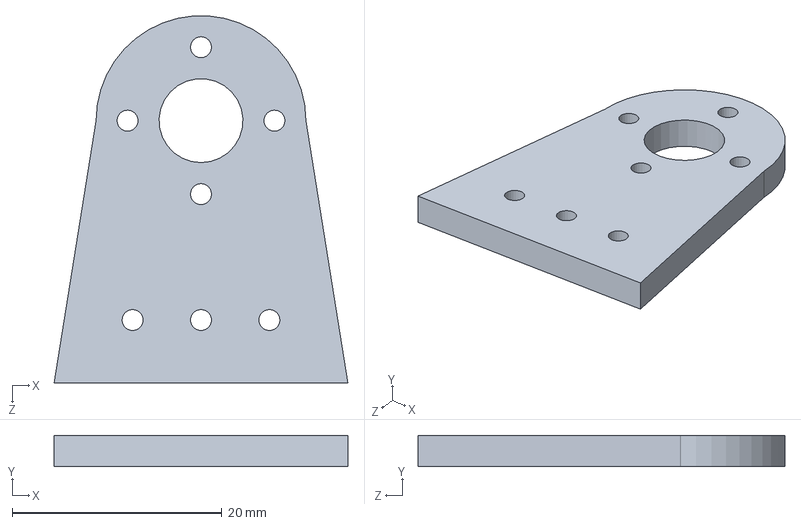
[picture p66: CAD file, 2016-07-03]
Cad design/Simulated_Edition 3/ankle support flange.SLDPRT
28.0 x 3.00 x 35.0 mm
