IvLabs/HuroCup/Cad design/Simulated_Edition 3/battery_holder.SLDPRT

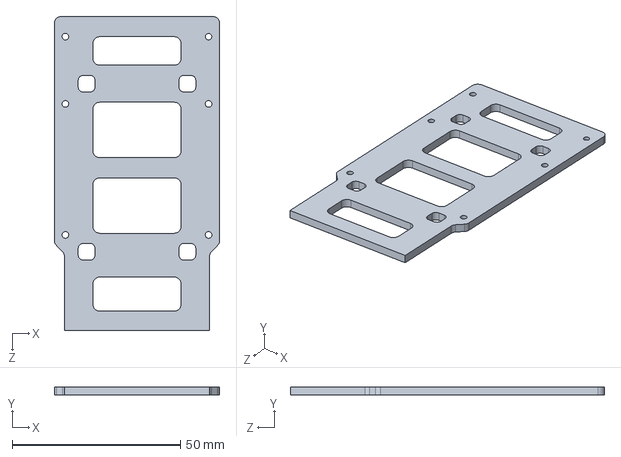
[picture p67: CAD file, 2016-07-03]
Cad design/Simulated_Edition 3/battery_holder.SLDPRT
49.2 x 2.50 x 93.4 mm
