IvLabs/HuroCup/Cad design/Simulated_Edit 2/shoulder plaate.SLDPRT

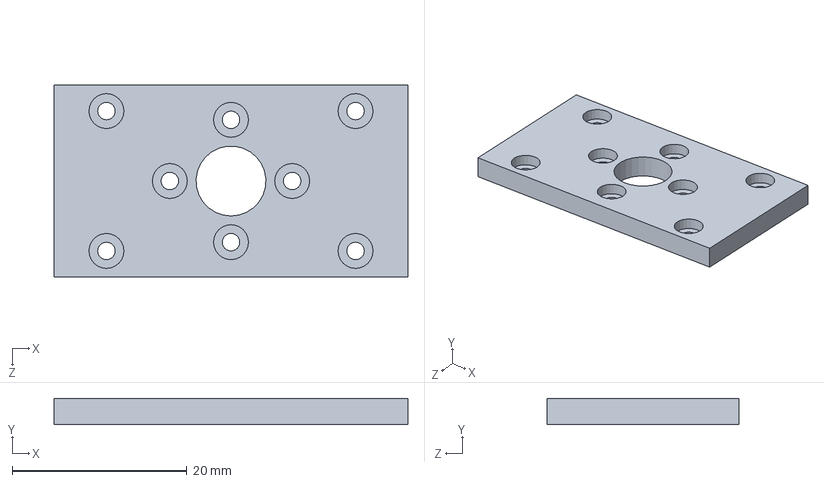
[picture p68: CAD file, 2016-07-18]
Cad design/Simulated_Edit 2/shoulder plaate.SLDPRT
40.5 x 3.00 x 22.0 mm
