IvLabs/HuroCup/Cad design/Simulated_Edition 3/16_FR07_H132.SLDPRT

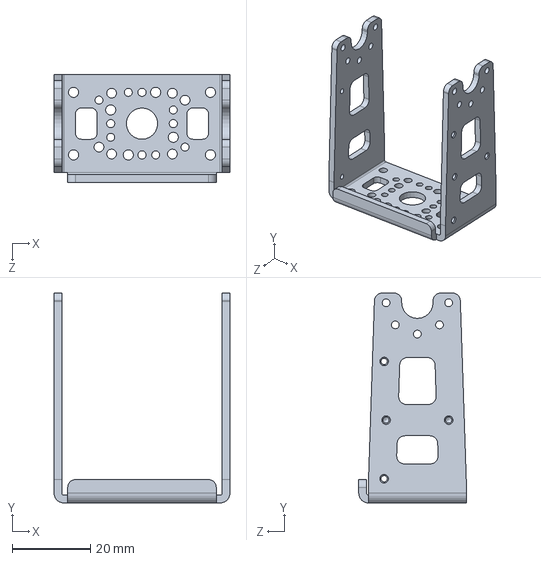
[picture p69: CAD file, 2016-07-03]
Cad design/Simulated_Edition 3/16_FR07_H132.SLDPRT
45.0 x 53.7 x 27.5 mm
