IvLabs/HuroCup/Cad design/Simulated_Edit 2/gripper_mid.SLDPRT

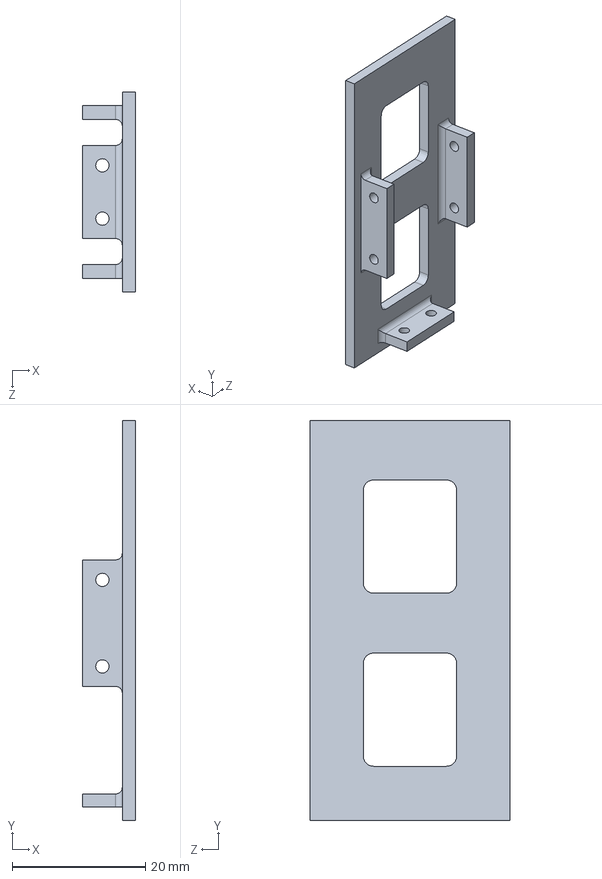
[picture p70: CAD file, 2016-07-18]
Cad design/Simulated_Edit 2/gripper_mid.SLDPRT
8.00 x 60.1 x 30.0 mm
