IvLabs/HuroCup/Cad design/Simulated_Edition 3/17_FR07_H133.SLDPRT

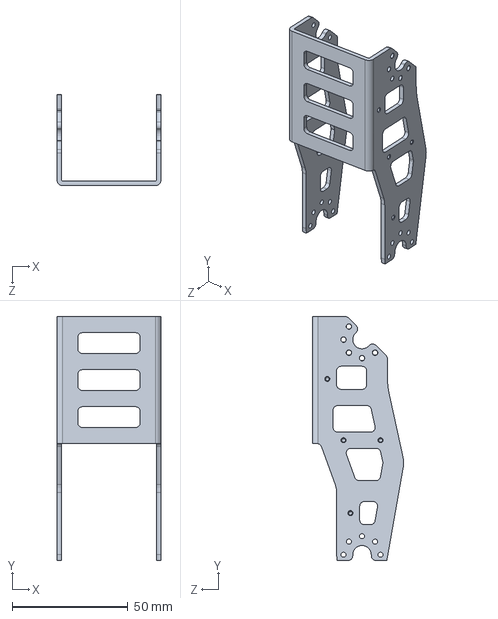
[picture p71: CAD file, 2016-07-03]
Cad design/Simulated_Edition 3/17_FR07_H133.SLDPRT
45.0 x 105.5 x 39.5 mm
