IvLabs/HuroCup/Cad design/Simulated_Edit 2/Fitpc side plate.SLDPRT

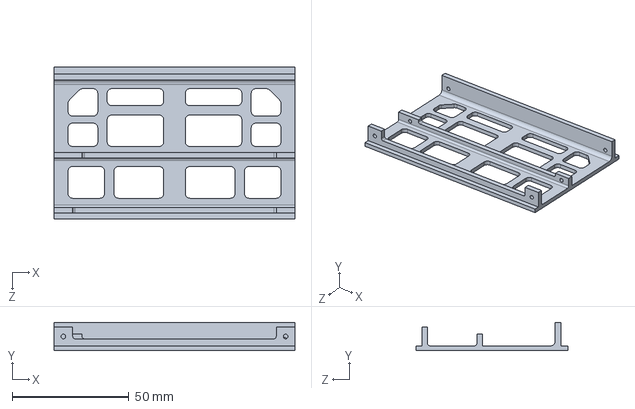
[picture p72: CAD file, 2016-07-18]
Cad design/Simulated_Edit 2/Fitpc side plate.SLDPRT
103.0 x 12.0 x 65.0 mm
