IvLabs/HuroCup/Cad design/Simulated_Edition 3/foot palm.SLDPRT

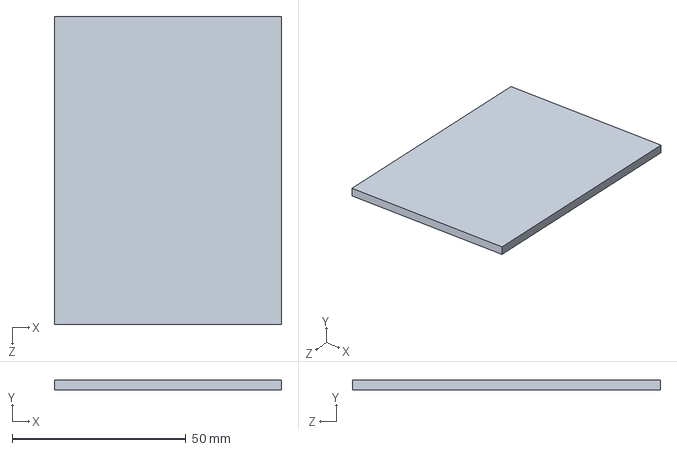
[picture p73: CAD file, 2016-07-03]
Cad design/Simulated_Edition 3/foot palm.SLDPRT
65.3 x 3.00 x 88.5 mm
