IvLabs/HuroCup/Cad design/Simulated_Edit 2/Sensorhub.SLDPRT

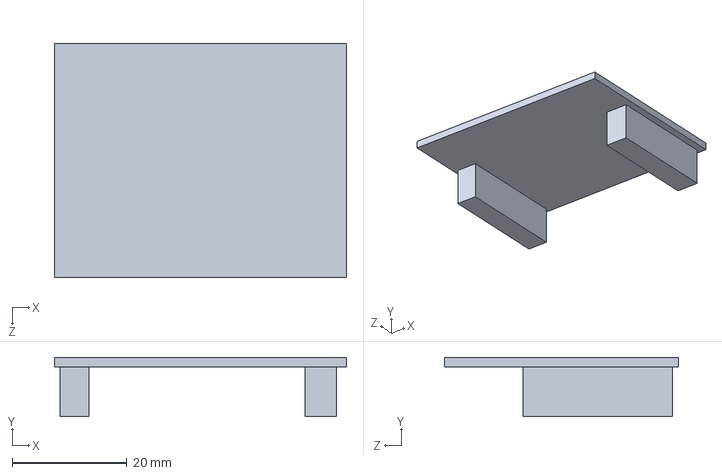
[picture p74: CAD file, 2016-07-18]
Cad design/Simulated_Edit 2/Sensorhub.SLDPRT
50.8 x 10.3 x 40.6 mm
