IvLabs/HuroCup/Cad design/Simulated_Edit 2/wrist side plate2.SLDPRT

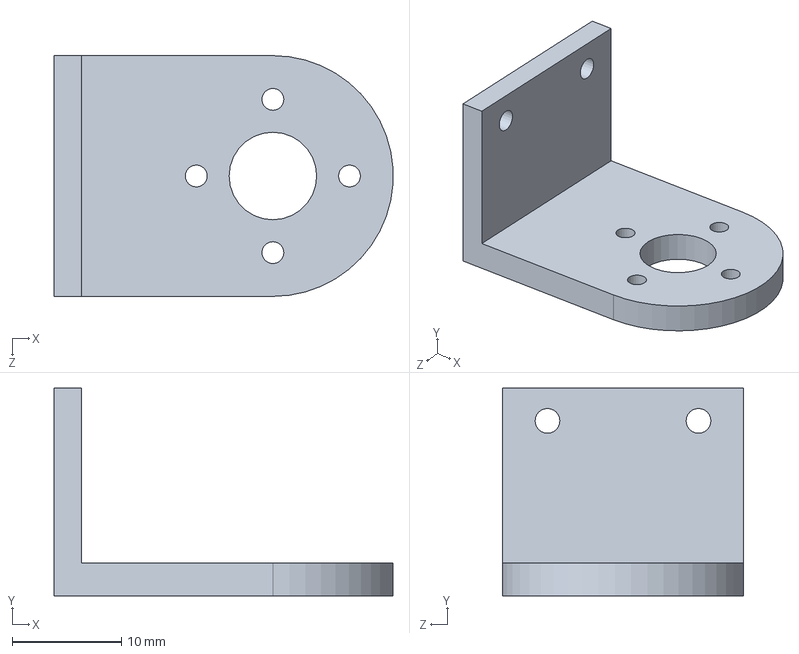
[picture p75: CAD file, 2016-07-18]
Cad design/Simulated_Edit 2/wrist side plate2.SLDPRT
31.0 x 19.0 x 22.0 mm
