IvLabs/HuroCup/Cad design/Simulated_Edit 2/wrist side plate.SLDPRT

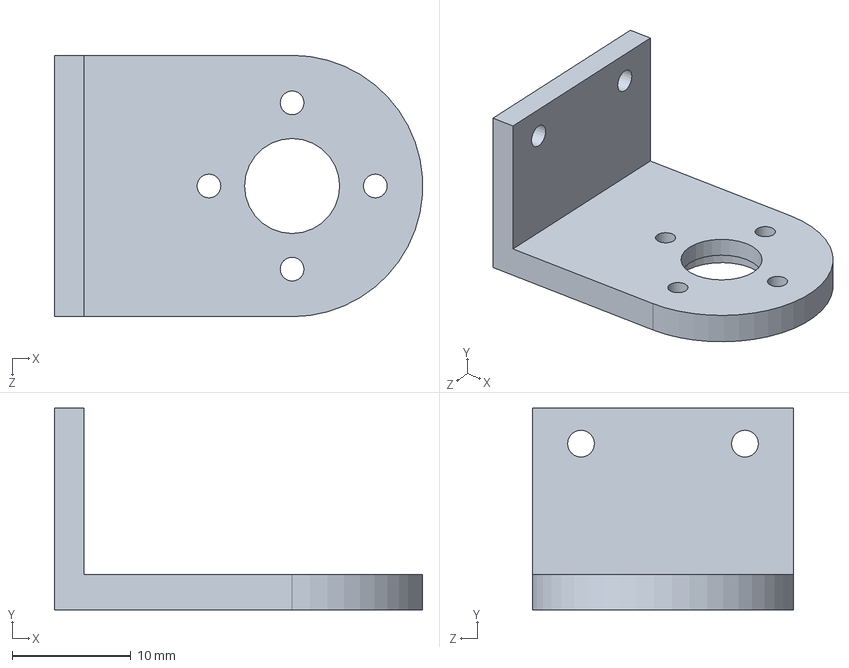
[picture p76: CAD file, 2016-07-18]
Cad design/Simulated_Edit 2/wrist side plate.SLDPRT
31.0 x 17.0 x 22.0 mm
