IvLabs/HuroCup/Cad design/Simulated_Edit 2/arm plate.SLDPRT

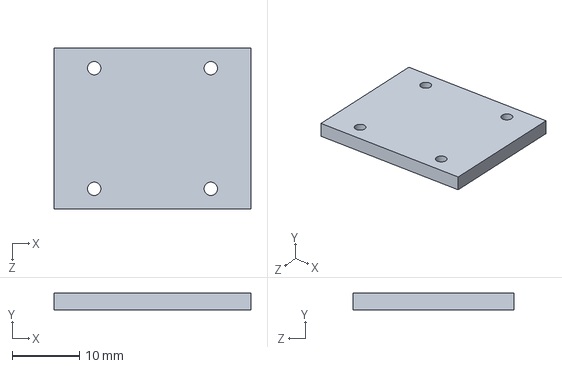
[picture p77: CAD file, 2016-07-18]
Cad design/Simulated_Edit 2/arm plate.SLDPRT
29.4 x 2.50 x 24.1 mm
