IvLabs/HuroCup/Cad design/Simulated_Edit 2/Part1.SLDPRT

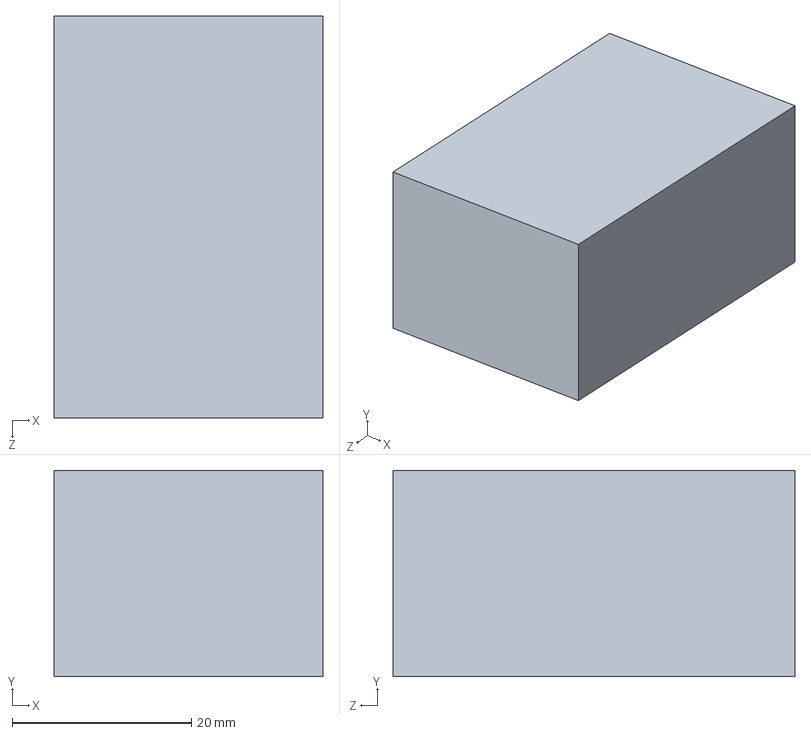
[picture p78: CAD file, 2016-07-14]
Cad design/Simulated_Edit 2/Part1.SLDPRT
30.0 x 23.0 x 44.9 mm
