IvLabs/HuroCup/Cad design/Simulated_Edit 2/line loint.SLDPRT

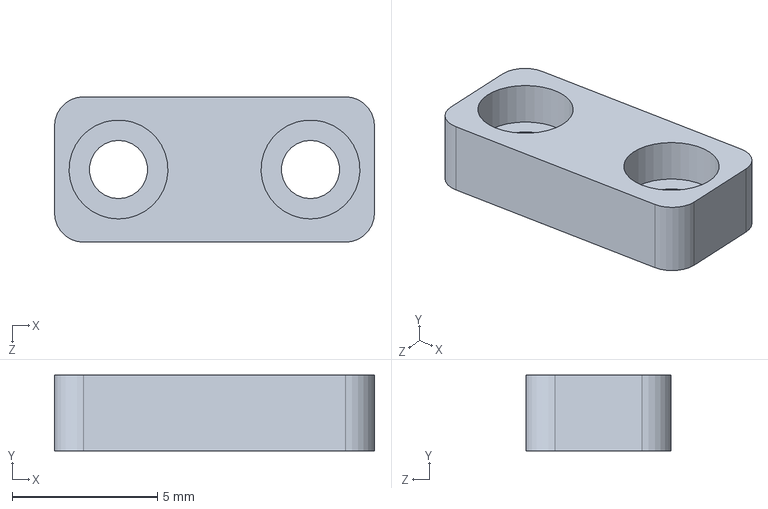
[picture p79: CAD file, 2016-07-14]
Cad design/Simulated_Edit 2/line loint.SLDPRT
11.0 x 2.60 x 5.00 mm
