IvLabs/HuroCup/Cad design/Simulated_Edit 2/TM4c.STL

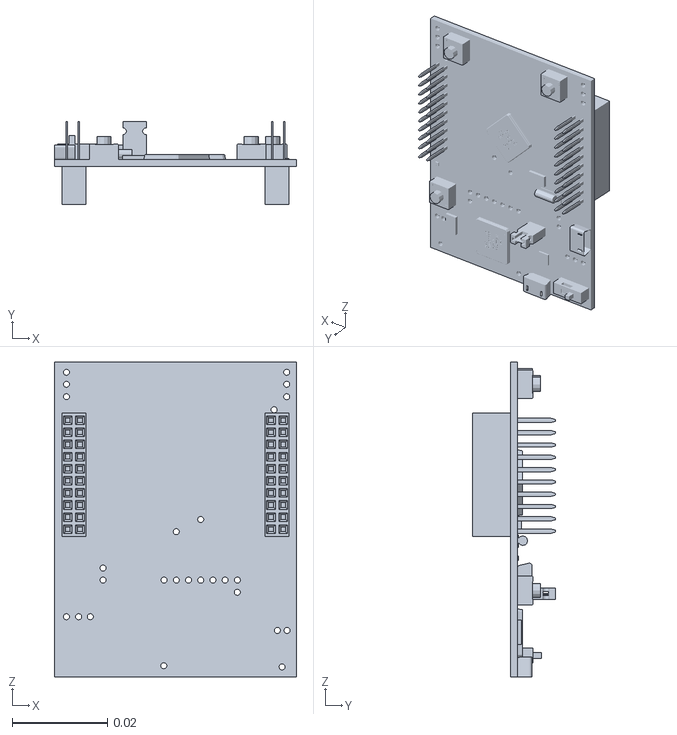
[picture p80: CAD file, 2016-07-12]
Cad design/Simulated_Edit 2/TM4c.STL
0.0508 x 0.0175 x 0.066
