IvLabs/HuroCup/Cad design/Simulated_Edit 2/Herkulex.SLDPRT

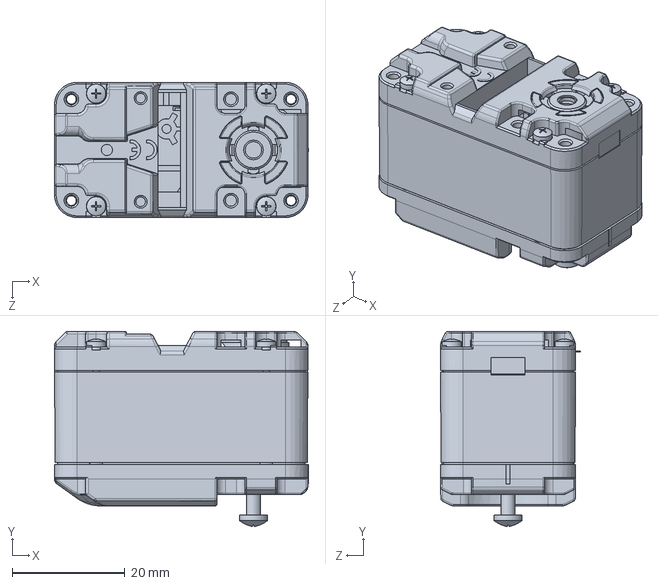
[picture p81: CAD file, 2016-07-03]
Cad design/Simulated_Edit 2/Herkulex.SLDPRT
45.1 x 34.7 x 24.9 mm
