IvLabs/HuroCup/Cad design/Simulated_Edit 2/L joint.SLDPRT

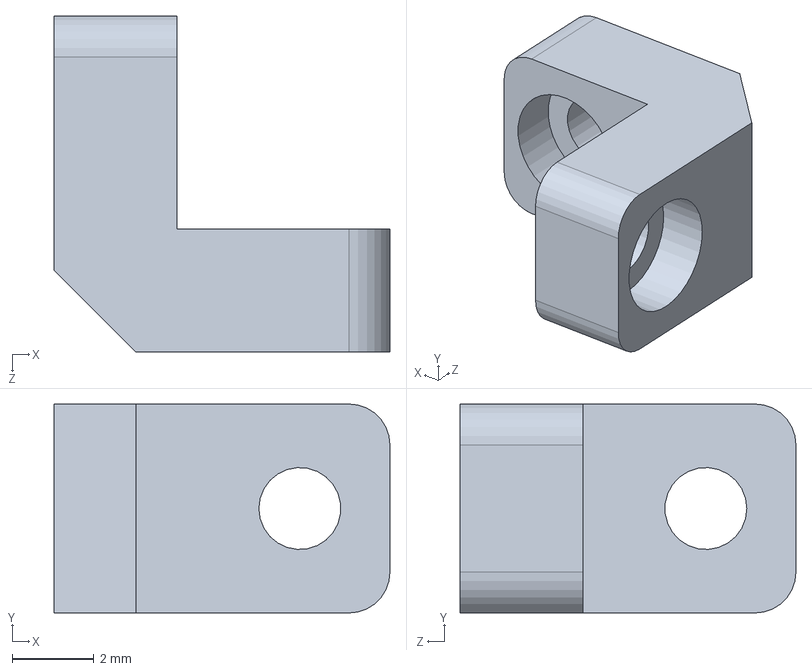
[picture p82: CAD file, 2016-07-03]
Cad design/Simulated_Edit 2/L joint.SLDPRT
8.20 x 5.10 x 8.20 mm
