IvLabs/HuroCup/Cad design/Simulated_Edit 2/L joint ankle.SLDPRT

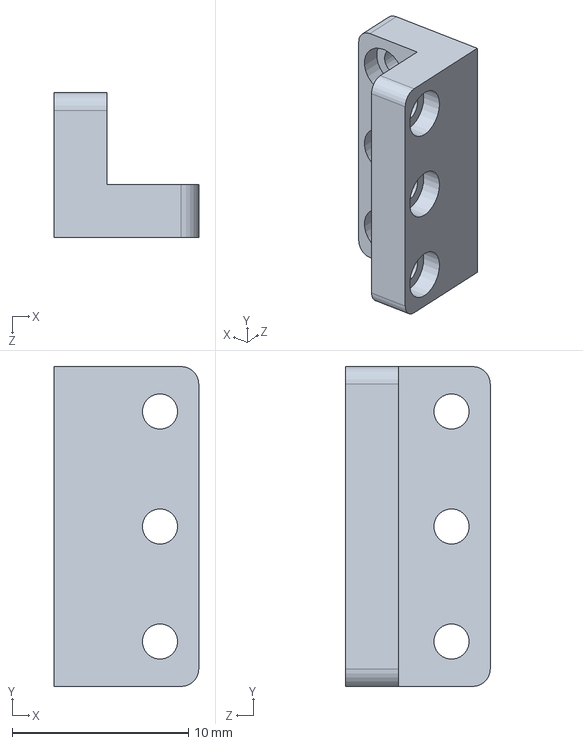
[picture p83: CAD file, 2016-07-03]
Cad design/Simulated_Edit 2/L joint ankle.SLDPRT
8.20 x 18.1 x 8.20 mm
