IvLabs/HuroCup/Cad design/Simulated_Edit 2/Herkulex horn.SLDPRT

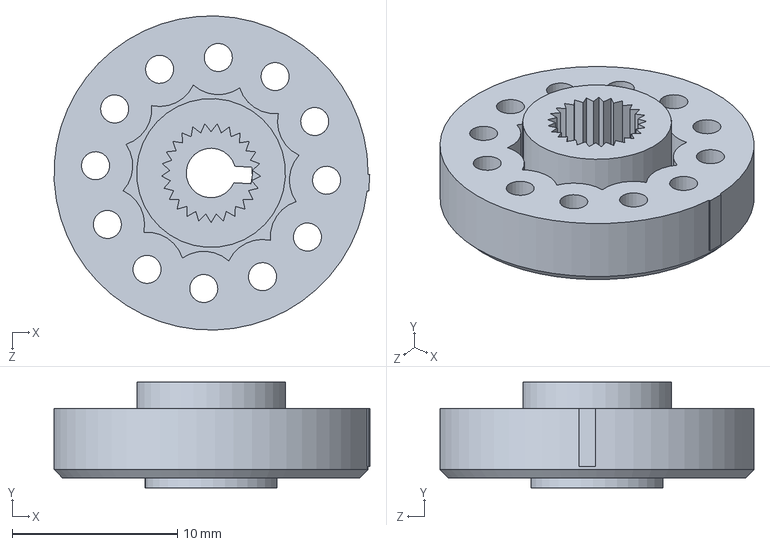
[picture p84: CAD file, 2016-07-03]
Cad design/Simulated_Edit 2/Herkulex horn.SLDPRT
19.1 x 6.40 x 19.0 mm
