IvLabs/HuroCup/Cad design/Simulated_Edit 2/support.SLDPRT

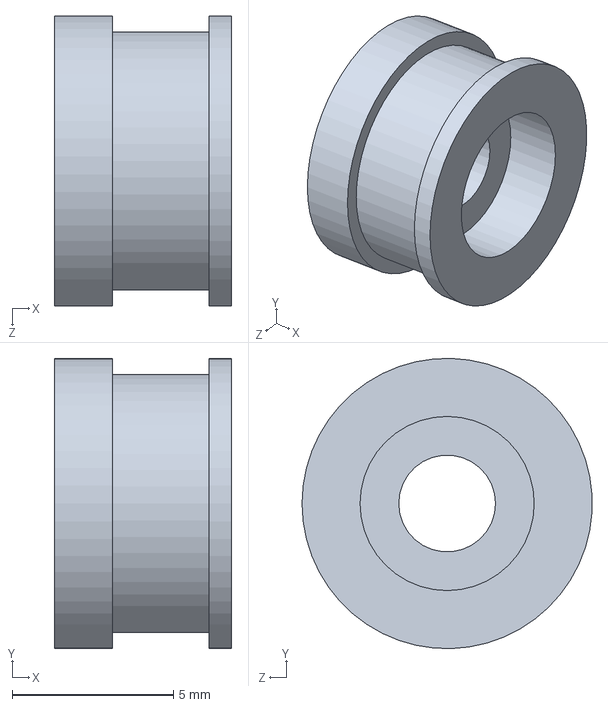
[picture p85: CAD file, 2016-07-03]
Cad design/Simulated_Edit 2/support.SLDPRT
5.50 x 9.00 x 8.99 mm
