IvLabs/HuroCup/(list of files, cad)

Other CAD files:
Cad design/Simulated_Edit 2/right foot.SLDASM
Cad design/Simulated_Edition 3/Assem1.SLDASM
Cad design/Simulated_Edit 2/Assem1.SLDASM
Cad design/Simulated_Edit 2/male headers/12x1_male_header_pin.STEP
Cad design/Simulated_Edition 3/foot_1.sldprt
Cad design/Simulated_Edition 3/Bracket_1.sldprt
Cad design/Simulated_Edit 2/foot.SLDPRT
Cad design/Simulated_Edition 3/body1.SLDPRT
Cad design/Simulated_Edit 2/Fitpc.SLDPRT
Cad design/Simulated_Edition 3/Fitpc base_1.sldprt
Cad design/Simulated_Edition 3/Fitpc_1.sldprt
Cad design/Simulated_Edition 3/Fitpc Top.SLDPRT
Cad design/Simulated_Edit 2/Bracket.SLDPRT
Cad design/Simulated_Edition 3/Custom PCB.sldprt
Cad design/Simulated_Edition 3/Herkulex.SLDPRT
Cad design/Simulated_Edition 3/3D ankle support flange_1.sldprt
Cad design/Simulated_Edition 3/gripper side.SLDPRT
Cad design/Simulated_Edit 2/gripper side.SLDPRT
Cad design/Simulated_Edition 3/3D ankle support flange.SLDPRT
Cad design/Simulated_Edition 3/battery support.SLDPRT
Cad design/Simulated_Edition 3/battery support_1.sldprt
Cad design/Simulated_Edit 2/shoulder.SLDPRT
Cad design/Simulated_Edit 2/gripper side2.SLDPRT
Cad design/Simulated_Edit 2/male_header_pin.SLDPRT
Cad design/Simulated_Edit 2/Part2.SLDPRT
Cad design/Edition 0/3D ankle support flange.SLDPRT
Cad design/Edition 0/Bracket.SLDPRT
Cad design/Edition 0/Fitpc base.SLDPRT
Cad design/Edition 0/Fitpc.SLDPRT
Cad design/Edition 0/Herkulex Assem.SLDASM
Cad design/Edition 0/Knee bracket.SLDPRT
Cad design/Edition 0/battery support.SLDPRT
Cad design/Edition 0/foot.SLDPRT
Cad design/Edition 0/hip plate 2.SLDPRT
Cad design/Edition 0/hip plate.SLDPRT
Cad design/Edition 0/knee.SLDPRT
Cad design/Edition 0/line loint.SLDPRT
Cad design/Edition 0/lipo.SLDPRT
Cad design/Edition 0/upper leg.SLDPRT
Cad design/Edition 1/Herkulex Assem.SLDASM
Cad design/Edition 1/Humanas.SLDASM
Cad design/Edition 1/hip plate.SLDPRT
Cad design/Edition 1/knee.SLDPRT
Cad design/Edition 1/upper leg.SLDPRT
Cad design/Edition 2/3D ankle support flange.SLDPRT
Cad design/Edition 2/Bracket.SLDPRT
Cad design/Edition 2/Custom PCB.SLDPRT
Cad design/Edition 2/Fitpc Top.SLDPRT
Cad design/Edition 2/Fitpc base.SLDPRT
Cad design/Edition 2/Fitpc front.SLDPRT
Cad design/Edition 2/Fitpc side plate.SLDPRT
Cad design/Edition 2/Fitpc.SLDPRT
Cad design/Edition 2/Herkulex Assem.SLDASM
Cad design/Edition 2/Herkulex horn.SLDPRT
Cad design/Edition 2/Herkulex.SLDPRT
Cad design/Edition 2/Humanas.SLDASM
Cad design/Edition 2/Knee bracket.SLDPRT
Cad design/Edition 2/L joint.SLDPRT
Cad design/Edition 2/Sensorhub.SLDPRT
Cad design/Edition 2/battery support.SLDPRT
Cad design/Edition 2/foot.SLDPRT
Cad design/Edition 2/hip plate 2.SLDPRT
Cad design/Edition 2/hip plate.SLDPRT
Cad design/Edition 2/knee.SLDPRT
Cad design/Edition 2/line loint.SLDPRT
Cad design/Edition 2/lipo.SLDPRT
Cad design/Edition 2/male_header_pin.SLDPRT
Cad design/Edition 2/shoulder plaate.SLDPRT
Cad design/Edition 2/shoulder.SLDPRT
Cad design/Edition 2/support.SLDPRT
Cad design/Edition 2/upper leg.SLDPRT
Cad design/Simulated_Edit 0/3D ankle support flange.SLDPRT
Cad design/Simulated_Edit 0/Bracket.SLDPRT
Cad design/Simulated_Edit 0/Fitpc base.SLDPRT
Cad design/Simulated_Edit 0/Fitpc.SLDPRT
Cad design/Simulated_Edit 0/Humanas.SLDASM
Cad design/Simulated_Edit 0/Knee bracket.SLDPRT
Cad design/Simulated_Edit 0/battery support.SLDPRT
Cad design/Simulated_Edit 0/body1.SLDPRT
Cad design/Simulated_Edit 0/foot.SLDPRT
Cad design/Simulated_Edit 0/hip plate 2.SLDPRT
Cad design/Simulated_Edit 0/hip plate.SLDPRT
Cad design/Simulated_Edit 0/horn1.SLDPRT
Cad design/Simulated_Edit 0/knee.SLDPRT
Cad design/Simulated_Edit 0/left foot.SLDASM
Cad design/Simulated_Edit 0/lipo.SLDPRT
Cad design/Simulated_Edit 0/motor1.SLDASM
Cad design/Simulated_Edit 0/right foot.SLDASM
Cad design/Simulated_Edit 0/upper leg.SLDPRT
Cad design/Simulated_Edit 1/3D ankle support flange.SLDPRT
Cad design/Simulated_Edit 1/Bracket.SLDPRT
Cad design/Simulated_Edit 1/Fitpc base.SLDPRT
Cad design/Simulated_Edit 1/Fitpc.SLDPRT
Cad design/Simulated_Edit 1/Humanas.SLDASM
Cad design/Simulated_Edit 1/Knee bracket.SLDPRT
Cad design/Simulated_Edit 1/battery support.SLDPRT
Cad design/Simulated_Edit 1/body1.SLDPRT
Cad design/Simulated_Edit 1/foot.SLDPRT
Cad design/Simulated_Edit 1/hip plate 2.SLDPRT
Cad design/Simulated_Edit 1/hip plate.SLDPRT
Cad design/Simulated_Edit 1/horn1.SLDPRT
Cad design/Simulated_Edit 1/knee.SLDPRT
Cad design/Simulated_Edit 1/left foot.SLDASM
Cad design/Simulated_Edit 1/lipo.SLDPRT
Cad design/Simulated_Edit 1/motor1.SLDASM
Cad design/Simulated_Edit 1/right foot.SLDASM
Cad design/Simulated_Edit 1/upper leg.SLDPRT
Cad design/Simulated_Edit 2/Humanas.STL
