IvLabs/HuroCup/+Test/DH_parameters_COM.xlsx

Left Leg DH Parameters
 | Joints | Alpha(i-1) | A(i-1) | D(i) | theta(i)
0 | Frame | 0 | 0 | 0 | -1.570796327
1 | Hip Yaw | 0 | 0 | 0 | t6
2 | Hip Roll | -1.570796327 | 0 | 0 | t5+(1.57079632679)
3 | Hip pitch | 1.570796327 | 0 | 0 | t4
4 | Knee pitch | 0 | 93 | 4.7 | t3
5 | Ankle pitch | 0 | 93 | 2 | t2
6 | Ankle Roll | -1.570796327 | 0 | 0 | t1
Right Leg DH Parameters
 | Joints | Alpha(i-1) | A(i-1) | D(i) | theta(i)
0 | Frame | 0 | 0 | 0 | -1.570796327
1 | Hip Yaw | 0 | 0 | 0 | t6
2 | Hip Roll | -1.570796327 | 0 | 0 | t5+(1.57079632679)
3 | Hip pitch | 1.570796327 | 0 | 0 | t4
4 | Knee pitch | 0 | 93 | 5.25 | t3
5 | Ankle pitch | 0 | 93 | -3 | t2
6 | Ankle Roll | -1.570796327 | 0 | 0 | t1
Left Leg DH Parameters
 | Joints | X | Y | Z
1 | Left_Pelvis_yaw | -0.45 | 1.39 | 22.78 | 1
2 | Pelvis | 10.48 | -1.37 | -0.68 | 1
3 | Left_upper_leg | 76.74 | -0.16 | 4.24 | 1
4 | Left_lower_leg | 35.76 | 6.96 | 0 | 1
5 | Ankle | -10.45 | -21.78 | -0.64 | 1
6 | foot | 29.48 | 7.81 | -0.73 | 1
Right Leg DH Parameters
 | Joints | X | Y | Z
1 | Rifgt_pelvis_Yaw | 0 | 1.39 | 22.78 | 1
2 | Pelvis | 10.48 | -1.39 | -21.68 | 1
3 | Right_upper_leg | 76.74 | -0.16 | 4.24 | 1
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
