IvLabs/HuroCup/+Test/X vs Y.jpg

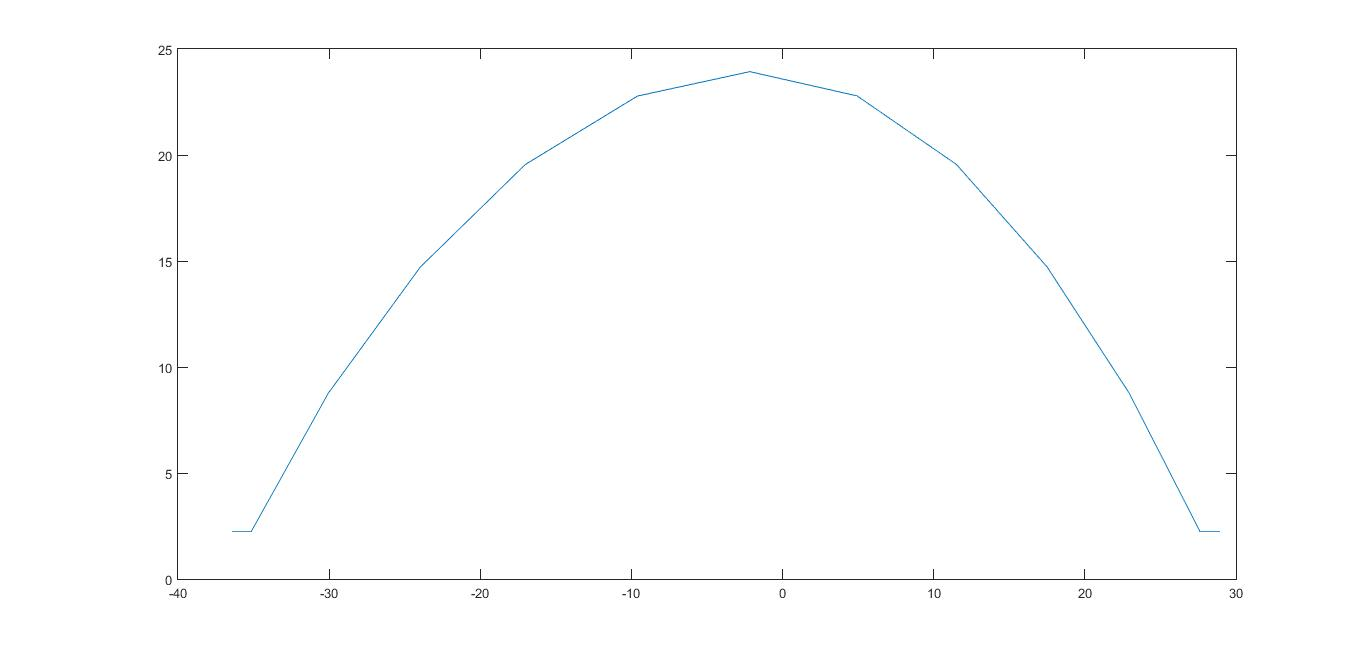
+Test/X vs Y.jpg
