IvLabs/HuroCup/+Test/Z vs X.jpg

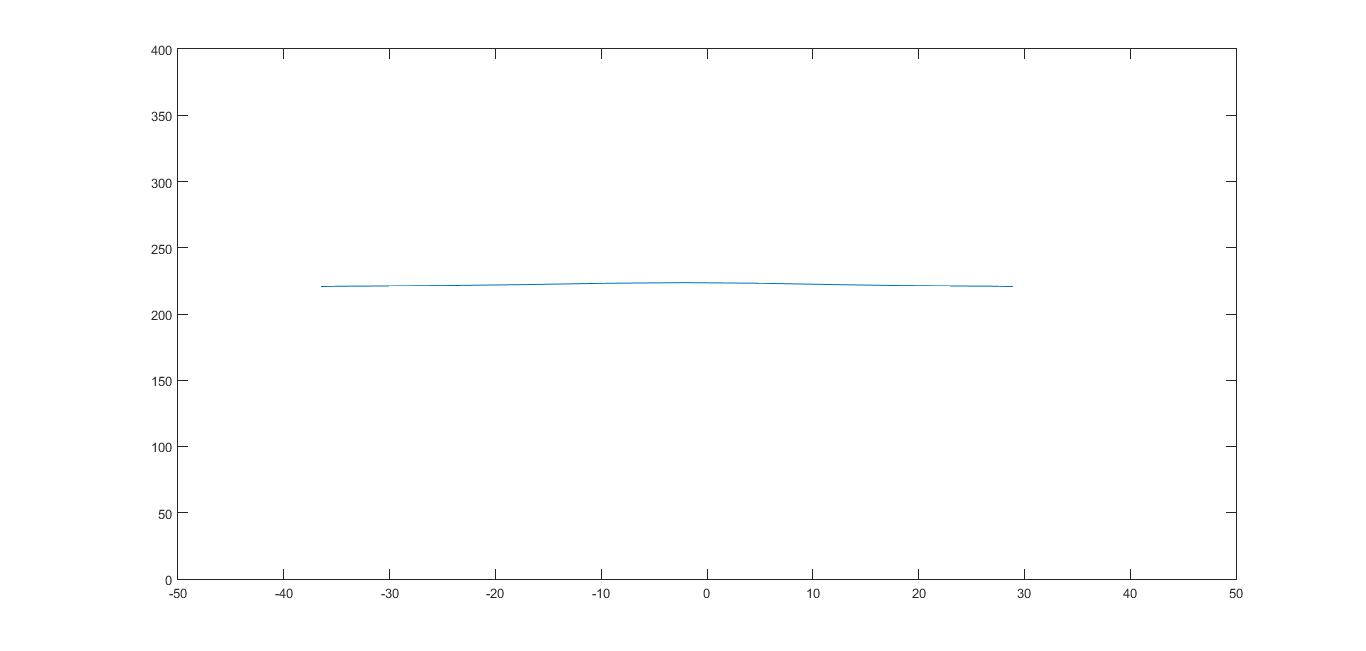
+Test/Z vs X.jpg
