IvLabs/HuroCup/Circuit_Cad_Version-1.0/humanoid-2.1/humanoid-9.brd

## EAGLE design Circuit_Cad_Version-1.0/humanoid-2.1/humanoid-9.brd (2016-07-13)

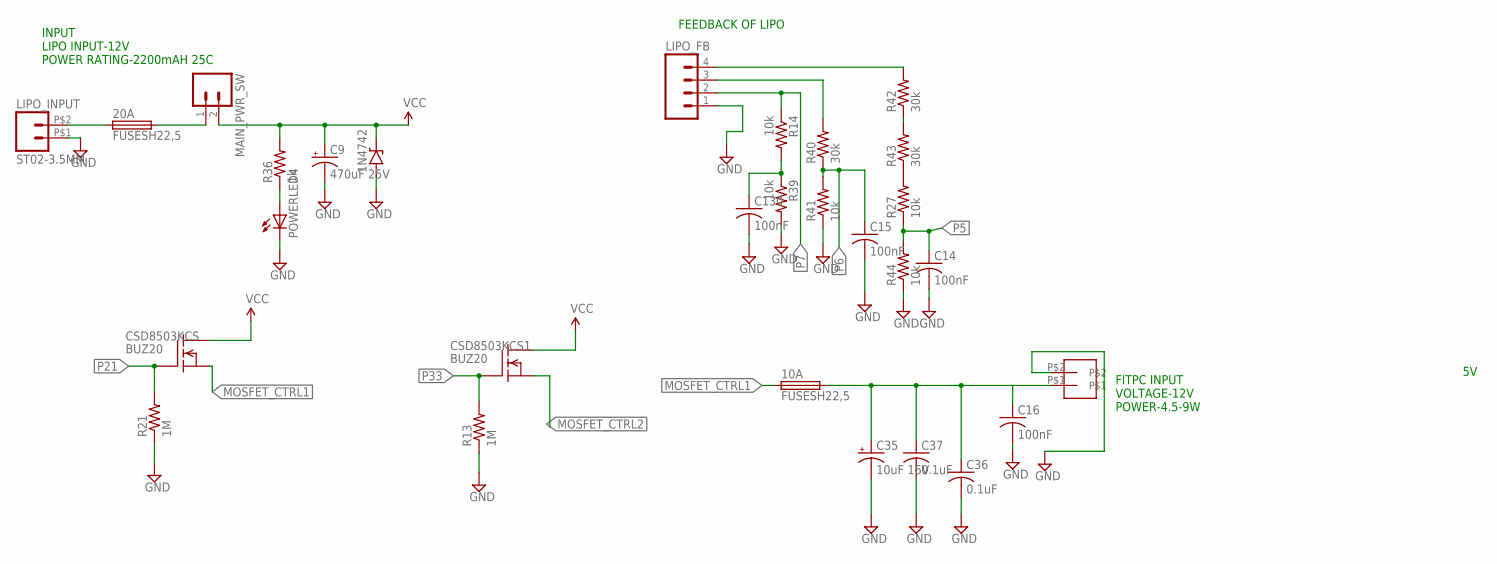
[picture p88: schematic humanoid-9.sch, sheet 1]

Parts:
1N4742: 1N47XX3; DO41-3
10A, 20A: FUSESH22,5; SH22,5
C9: 470uF 25V; PANASONIC_G; PARTNO EEEFK1E471AP
C14, C15, C16, C130: 100nF; C1206; PARTNO C1206C104K5RACTU
C35: 10uF 16V; PANASONIC_B
C36, C37: 0.1uF; C0805
CSD8503KCS, CSD8503KCS1: BUZ20; TO220
FITPC: 2PINRIGHT
LIPO_FB: M04PTH; 1X04
LIPO_INPUT: ST02-3.5MM; ED350V-02P
MAIN_PWR_SW: M02PTH; 1X02
POWERLED4: LEDCHIPLED_1206; CHIPLED_1206
R13, R21: 1M; R0805
R14, R27, R39, R41, R44: 10k; R0805
R36: 1k; R0805
R40, R42, R43: 30k; R0805

Connections:
GND: 1N4742.A, C9.-, C14.2, C15.2, C16.2, C35.-, C36.2, C37.2, C130.2, FITPC.P$2, LIPO_FB.1, LIPO_INPUT.P$1 (1), POWERLED4.C, R13.1, R21.1, R39.2, R41.1, R44.1; also elsewhere on the board
LIPO_FB4: LIPO_FB.4, R42.2
MOSFET_CTRL1: 10A.1, CSD8503KCS.3 (S)
MOSFET_CTRL2: CSD8503KCS1.3 (S); also elsewhere on the board
unnamed: C130.1, R14.2, R39.1
unnamed: 20A.2, MAIN_PWR_SW.1
unnamed: 20A.1, LIPO_INPUT.P$2 (2)
unnamed: R27.2, R43.1
unnamed: R42.1, R43.2
unnamed: LIPO_FB.3, R40.2
unnamed: 10A.2, C16.1, C35.+, C36.1, C37.1, FITPC.P$1
unnamed: POWERLED4.A, R36.1
P5: C14.1, R27.1, R44.2; also elsewhere on the board
P6: C15.1, R40.1, R41.2; also elsewhere on the board
P7: LIPO_FB.2, R14.1; also elsewhere on the board
P21: CSD8503KCS.1 (G), R21.2; also elsewhere on the board
P33: CSD8503KCS1.1 (G), R13.2; also elsewhere on the board
VCC: 1N4742.C, C9.+, CSD8503KCS.2 (D), CSD8503KCS1.2 (D), MAIN_PWR_SW.2, R36.2; also elsewhere on the board

Notes on the sheet:
INPUT LIPO INPUT-12V POWER RATING-2200mAH 25C
FITPC INPUT VOLTAGE-12V POWER-4.5-9W
FEEDBACK OF LIPO

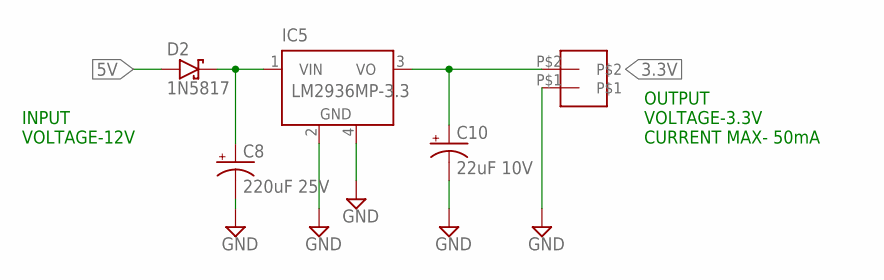
[picture p89: schematic humanoid-9.sch, sheet 2]

Parts:
3.3V1: 2PINRIGHT
C8: 220uF 25V; PANASONIC_G; MOUSER_PARTNO 667-EEE-1EA221P
C10: 22uF 10V; PANASONIC_B; PARTNO EEEFK1A220AR
D2: 1N5817; DO41-3
IC5: LM2936MP-3.3; SOT223

Connections:
3.3V: 3.3V1.P$2, C10.+, IC5.3 (VO); also elsewhere on the board
5V: D2.A; also elsewhere on the board
GND: 3.3V1.P$1, C8.-, C10.-, IC5.2 (GND), IC5.4 (GND); also elsewhere on the board
unnamed: C8.+, D2.C, IC5.1 (VIN)

Notes on the sheet:
INPUT VOLTAGE-12V
OUTPUT VOLTAGE-3.3V CURRENT MAX- 50mA

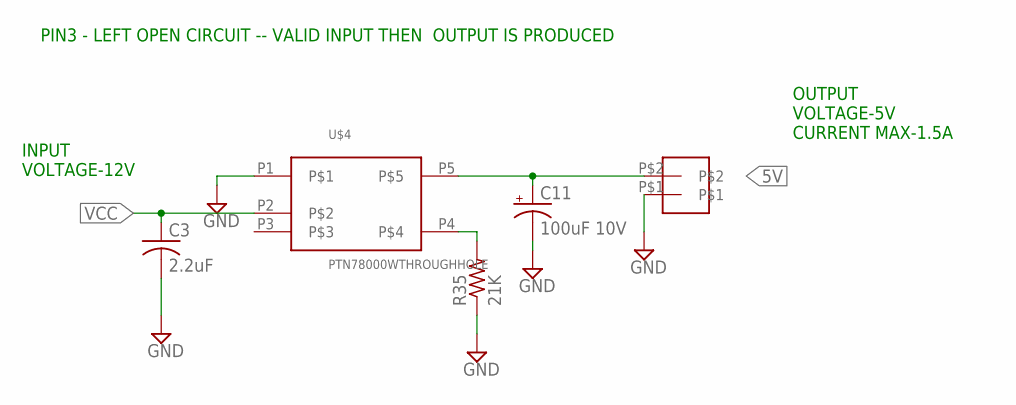
[picture p90: schematic humanoid-9.sch, sheet 3]

Parts:
5V1: 2PINRIGHT
C3: 2.2uF; C1608; MOUSER_PARTNO 810-C1608X7R1A225K
C11: 100uF 10V; PANASONIC_E; MOUSER_PARTNO 667-EEE-HA1A101P
R35: 21K; R0805
U$4: PTN78000WTHROUGHHOLE; PTN78000W

Connections:
5V: 5V1.P$2, C11.+, U$4.P5; also elsewhere on the board
GND: 5V1.P$1, C3.2, C11.-, R35.1, U$4.P1; also elsewhere on the board
unnamed: R35.2, U$4.P4
VCC: C3.1, U$4.P2; also elsewhere on the board

Notes on the sheet:
INPUT VOLTAGE-12V
OUTPUT VOLTAGE-5V CURRENT MAX-1.5A
PIN3 - LEFT OPEN CIRCUIT -- VALID INPUT THEN OUTPUT IS PRODUCED

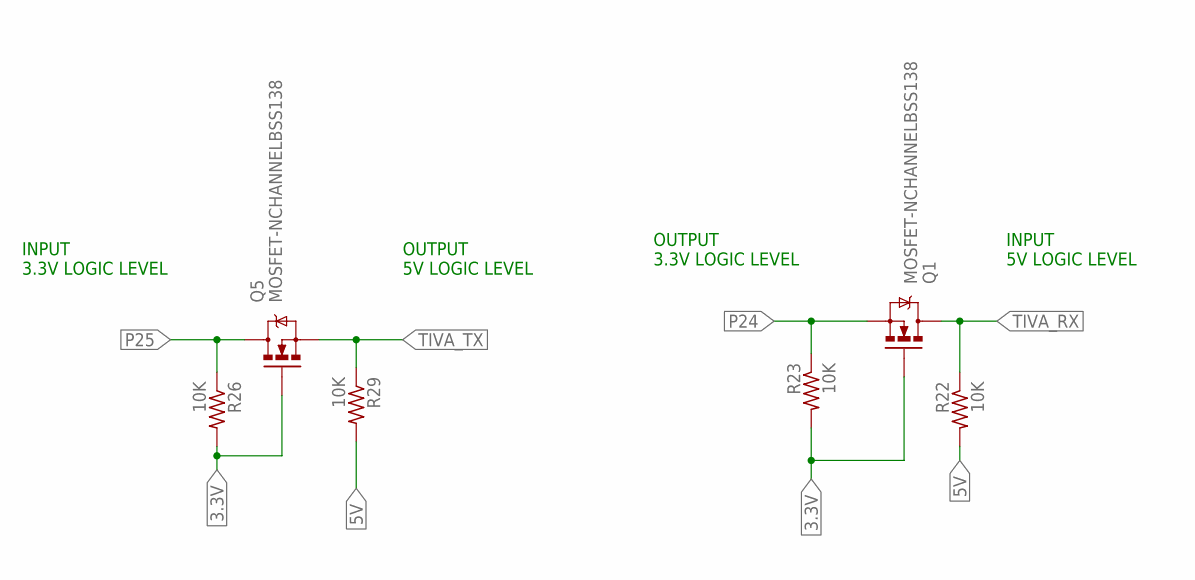
[picture p91: schematic humanoid-9.sch, sheet 4]

Parts:
Q1, Q5: MOSFET-NCHANNELBSS138; SOT23
R22, R23, R26, R29: 10K; R0805

Connections:
3.3V: Q1.1 (G), Q5.1 (G), R23.2, R26.2; also elsewhere on the board
5V: R22.2, R29.2; also elsewhere on the board
P24: Q1.2 (S), R23.1; also elsewhere on the board
P25: Q5.3 (D), R26.1; also elsewhere on the board
TIVA_RX: Q1.3 (D), R22.1; also elsewhere on the board
TIVA_TX: Q5.2 (S), R29.1; also elsewhere on the board

Notes on the sheet:
INPUT 3.3V LOGIC LEVEL
OUTPUT 5V LOGIC LEVEL
OUTPUT 3.3V LOGIC LEVEL
INPUT 5V LOGIC LEVEL

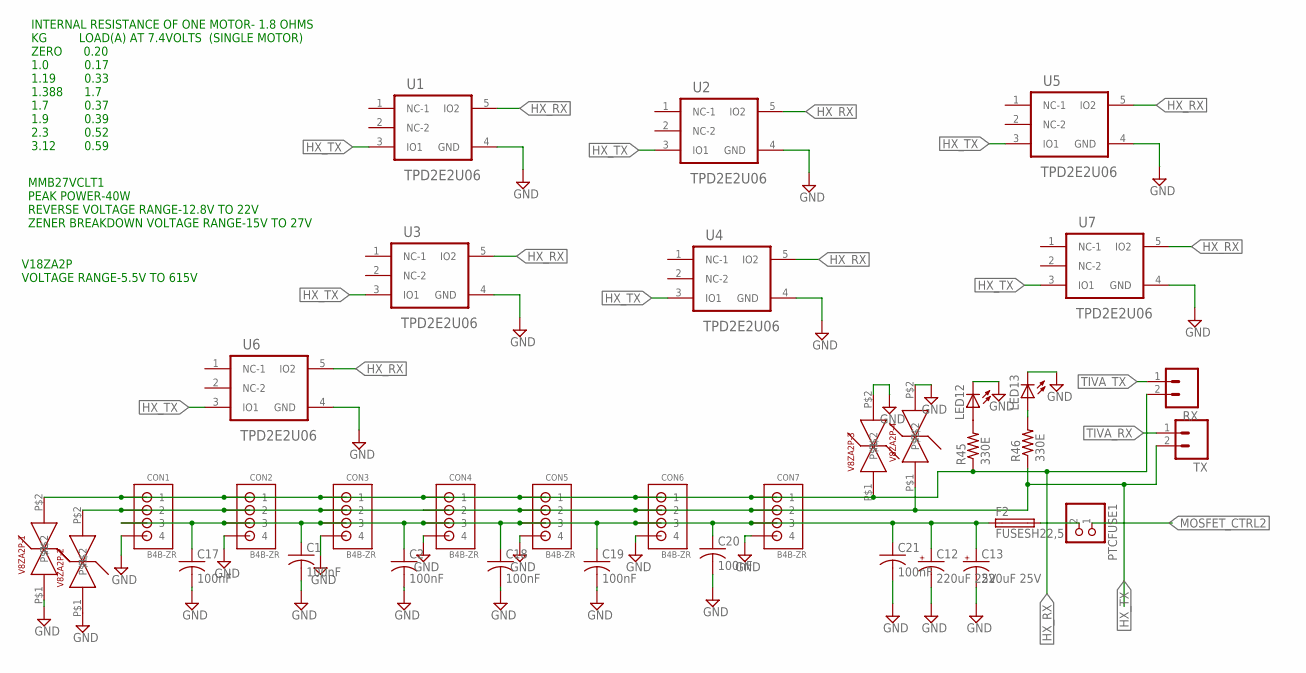
[picture p92: schematic humanoid-9.sch, sheet 5]

Parts:
C1, C2, C17, C18, C19, C20, C21: 100nF; C1206; PARTNO C1206C104K5RACTU
C12, C13: 220uF 25V; PANASONIC_G; MOUSER_PARTNO 667-EEE-1EA221P
CON1, CON2, CON3, CON4, CON5, CON6, CON7: B4B-ZR; MPN B4B-ZR(LF)(SN)
F2: FUSESH22,5; SH22,5
LED12, LED13: LEDCHIPLED_1206; CHIPLED_1206
PTCFUSE1: PINHD-1X2; 1X02
R45, R46: 330E; R0805
RX: M02PTH; 1X02
TX: M02PTH; 1X02
U1, U2, U3, U4, U5, U6, U7: TPD2E2U06; SOT50P160X60-5N
V8ZA2P-1, V8ZA2P-2, V8ZA2P-3, V8ZA2P-4: V18ZA2P

Connections:
GND: C1.2, C2.2, C12.-, C13.-, C17.2, C18.2, C19.2, C20.2, C21.2, CON1.4, CON2.4, CON3.4, CON4.4, CON5.4, CON6.4, CON7.4, LED12.C, LED13.C, U1.4 (GND), U2.4 (GND), U3.4 (GND), U4.4 (GND), U5.4 (GND), U6.4 (GND), U7.4 (GND), V8ZA2P-1.P$1, V8ZA2P-2.P$1, V8ZA2P-3.P$2, V8ZA2P-4.P$2; also elsewhere on the board
HX_RX: CON1.1, CON2.1, CON3.1, CON4.1, CON5.1, CON6.1, CON7.1, R45.1, RX.2, U1.5 (IO2), U2.5 (IO2), U3.5 (IO2), U4.5 (IO2), U5.5 (IO2), U6.5 (IO2), U7.5 (IO2), V8ZA2P-1.P$2, V8ZA2P-3.P$1; also elsewhere on the board
HX_TX: CON1.2, CON2.2, CON3.2, CON4.2, CON5.2, CON6.2, CON7.2, R46.1, TX.2, U1.3 (IO1), U2.3 (IO1), U3.3 (IO1), U4.3 (IO1), U5.3 (IO1), U6.3 (IO1), U7.3 (IO1), V8ZA2P-2.P$2, V8ZA2P-4.P$1; also elsewhere on the board
MOSFET_CTRL2: PTCFUSE1.1; also elsewhere on the board
unnamed: C1.1, C2.1, C12.+, C13.+, C17.1, C18.1, C19.1, C20.1, C21.1, CON1.3, CON2.3, CON3.3, CON4.3, CON5.3, CON6.3, CON7.3, F2.1
unnamed: F2.2, PTCFUSE1.2
unnamed: LED12.A, R45.2
unnamed: LED13.A, R46.2
TIVA_RX: TX.1; also elsewhere on the board
TIVA_TX: RX.1; also elsewhere on the board

Notes on the sheet:
MMB27VCLT1 PEAK POWER-40W REVERSE VOLTAGE RANGE-12.8V TO 22V ZENER BREAKDOWN VOLTAGE RANGE-15V TO 27V
V18ZA2P VOLTAGE RANGE-5.5V TO 615V
INTERNAL RESISTANCE OF ONE MOTOR- 1.8 OHMS KG LOAD(A) AT 7.4VOLTS (SINGLE MOTOR) ZERO 0.20 1.0 0.17 1.19 0.33 1.388 1.7 1.7 0.37 1.9 0.39 2.3 0.52 3.12 0.59

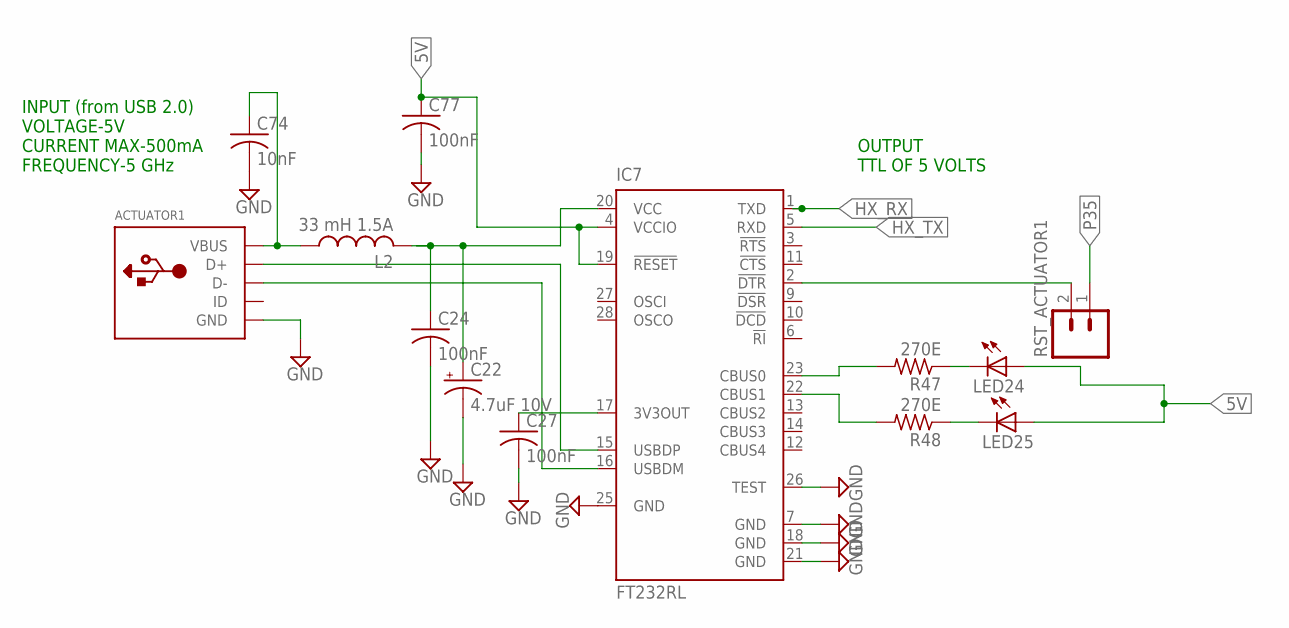
[picture p93: schematic humanoid-9.sch, sheet 6]

Parts:
ACTUATOR1: USBMINIB; USB-MINIB
C22: 4.7uF 10V; PANASONIC_B; MOUSER_PARTNO 667-10SVP4R7M
C24, C27: 100nF; C1206; PARTNO C1206C104K5RACTU
C74: 10nF; C1206
C77: 100nF; C1206
IC7: FT232RL; SSOP28
L2: 33 mH 1.5A; L0805; MOUSER_PARTNO 875-MI0805K400R-10
LED24, LED25: LEDCHIPLED_1206; CHIPLED_1206
R47, R48: 270E; R0805
RST_ACTUATOR1: M02PTH; 1X02

Connections:
5V: C77.1, IC7.4 (VCCIO), IC7.19 (!RESET), LED24.A, LED25.A; also elsewhere on the board
GND: ACTUATOR1.GND, C22.-, C24.2, C27.2, C74.2, C77.2, IC7.7 (GND), IC7.18 (GND), IC7.21 (GND), IC7.25 (GND), IC7.26 (TEST); also elsewhere on the board
HX_RX: IC7.1 (TXD); also elsewhere on the board
HX_TX: IC7.5 (RXD); also elsewhere on the board
unnamed: IC7.22 (CBUS1), R48.2
unnamed: IC7.23 (CBUS0), R47.2
unnamed: LED24.C, R47.1
unnamed: LED25.C, R48.1
unnamed: ACTUATOR1.VBUS, C74.1, L2.1
unnamed: C22.+, C24.1, IC7.20 (VCC), L2.2
unnamed: ACTUATOR1.D+, IC7.15 (USBDP)
unnamed: ACTUATOR1.D-, IC7.16 (USBDM)
unnamed: C27.1, IC7.17 (3V3OUT)
unnamed: IC7.2 (!DTR), RST_ACTUATOR1.2
P35: RST_ACTUATOR1.1; also elsewhere on the board

Notes on the sheet:
INPUT (from USB 2.0) VOLTAGE-5V CURRENT MAX-500mA FREQUENCY-5 GHz
OUTPUT TTL OF 5 VOLTS

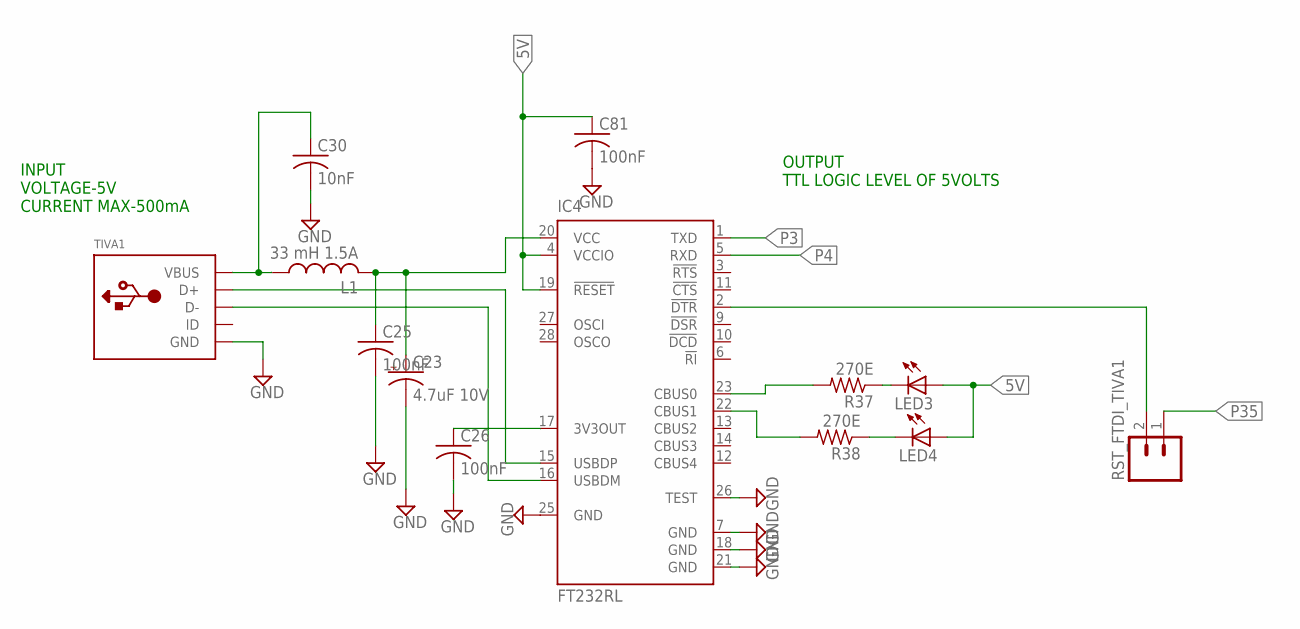
[picture p94: schematic humanoid-9.sch, sheet 7]

Parts:
C23: 4.7uF 10V; PANASONIC_B; MOUSER_PARTNO 667-10SVP4R7M
C25, C26: 100nF; C1206; PARTNO C1206C104K5RACTU
C30: 10nF; C1206
C81: 100nF; C1206
IC4: FT232RL; SSOP28
L1: 33 mH 1.5A; L0805; MOUSER_PARTNO 875-MI0805K400R-10
LED3, LED4: LEDCHIPLED_1206; CHIPLED_1206
R37, R38: 270E; R0805
RST_FTDI_TIVA1: M02PTH; 1X02
TIVA1: USBMINIB; USB-MINIB

Connections:
5V: C81.1, IC4.4 (VCCIO), IC4.19 (!RESET), LED3.A, LED4.A; also elsewhere on the board
GND: C23.-, C25.2, C26.2, C30.2, C81.2, IC4.7 (GND), IC4.18 (GND), IC4.21 (GND), IC4.25 (GND), IC4.26 (TEST), TIVA1.GND; also elsewhere on the board
unnamed: C30.1, L1.1, TIVA1.VBUS
unnamed: C23.+, C25.1, IC4.20 (VCC), L1.2
unnamed: IC4.15 (USBDP), TIVA1.D+
unnamed: IC4.16 (USBDM), TIVA1.D-
unnamed: LED3.C, R37.1
unnamed: LED4.C, R38.1
unnamed: IC4.23 (CBUS0), R37.2
unnamed: IC4.22 (CBUS1), R38.2
unnamed: C26.1, IC4.17 (3V3OUT)
unnamed: IC4.2 (!DTR), RST_FTDI_TIVA1.2
P3: IC4.1 (TXD); also elsewhere on the board
P4: IC4.5 (RXD); also elsewhere on the board
P35: RST_FTDI_TIVA1.1; also elsewhere on the board

Notes on the sheet:
INPUT VOLTAGE-5V CURRENT MAX-500mA
OUTPUT TTL LOGIC LEVEL OF 5VOLTS

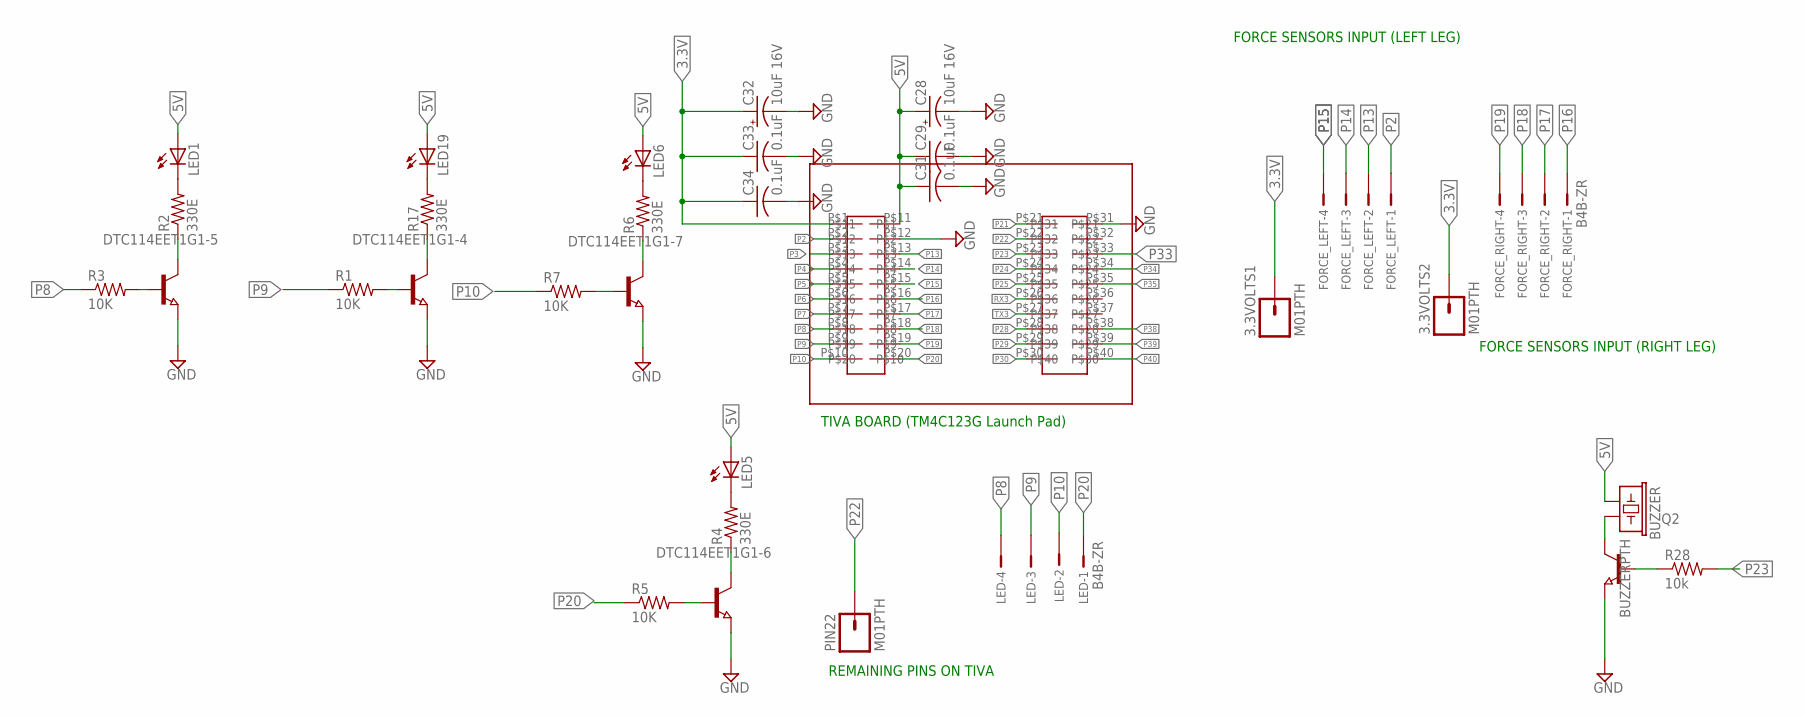
[picture p95: schematic humanoid-9.sch, sheet 8]

Parts:
3.3VOLTS1, 3.3VOLTS2: M01PTH; 1X01
BUZZER: BUZZERPTH; BUZZER-12MM
C28, C32: 10uF 16V; PANASONIC_B
C29, C31, C33, C34: 0.1uF; C0805
DTC114EET1G1-4, DTC114EET1G1-5, DTC114EET1G1-6, DTC114EET1G1-7: NPN-TRANSISTOR_SOT23; SOT23
FORCE_LEFT: B4B-ZR
FORCE_RIGHT: B4B-ZR
LED: B4B-ZR
LED1, LED5, LED6, LED19: LEDCHIPLED_1206; CHIPLED_1206
PIN22: M01PTH; 1X01
Q2: NPN-TRANSISTOR_SOT23; SOT23
R1, R3, R5, R7: 10K; R0805
R2, R4, R6, R17: 330E; R0805
R28: 10k; R0805
U$1: TIVA

Connections:
3.3V: 3.3VOLTS1.1, 3.3VOLTS2.1, C32.+, C33.1, C34.1, U$1.P$1; also elsewhere on the board
5V: BUZZER.+ (1), C28.+, C29.1, C31.1, LED1.A, LED5.A, LED6.A, LED19.A, U$1.P$11; also elsewhere on the board
GND: C28.-, C29.2, C31.2, C32.-, C33.2, C34.2, DTC114EET1G1-4.2 (E), DTC114EET1G1-5.2 (E), DTC114EET1G1-6.2 (E), DTC114EET1G1-7.2 (E), Q2.2 (E), U$1.P$12, U$1.P$31; also elsewhere on the board
unnamed: BUZZER.- (2), Q2.3 (C)
unnamed: Q2.1 (B), R28.1
unnamed: DTC114EET1G1-4.1 (B), R1.2
unnamed: LED19.C, R17.2
unnamed: DTC114EET1G1-4.3 (C), R17.1
unnamed: DTC114EET1G1-5.1 (B), R3.2
unnamed: LED1.C, R2.2
unnamed: DTC114EET1G1-5.3 (C), R2.1
unnamed: DTC114EET1G1-6.1 (B), R5.2
unnamed: LED5.C, R4.2
unnamed: DTC114EET1G1-6.3 (C), R4.1
unnamed: DTC114EET1G1-7.1 (B), R7.2
unnamed: LED6.C, R6.2
unnamed: DTC114EET1G1-7.3 (C), R6.1
P2: FORCE_LEFT.1, U$1.P$2
P3: U$1.P$3; also elsewhere on the board
P4: U$1.P$4; also elsewhere on the board
P5: U$1.P$5; also elsewhere on the board
P6: U$1.P$6; also elsewhere on the board
P7: U$1.P$7; also elsewhere on the board
P8: LED.4, R3.1, U$1.P$8
P9: LED.3, R1.1, U$1.P$9
P10: LED.2, R7.1, U$1.P$10
P13: FORCE_LEFT.2, U$1.P$13
P14: FORCE_LEFT.3, U$1.P$14
P15: FORCE_LEFT.4, U$1.P$15
P16: FORCE_RIGHT.1, U$1.P$16
P17: FORCE_RIGHT.2, U$1.P$17
P18: FORCE_RIGHT.3, U$1.P$18
P19: FORCE_RIGHT.4, U$1.P$19
P20: LED.1, R5.1, U$1.P$20
P21: U$1.P$21; also elsewhere on the board
P22: PIN22.1, U$1.P$22
P23: R28.2, U$1.P$23
P24: U$1.P$24; also elsewhere on the board
P25: U$1.P$25; also elsewhere on the board
P28: U$1.P$28; also elsewhere on the board
P29: U$1.P$29; also elsewhere on the board
P30: U$1.P$30; also elsewhere on the board
P33: U$1.P$33; also elsewhere on the board
P34: U$1.P$34; also elsewhere on the board
P35: U$1.P$35; also elsewhere on the board
P38: U$1.P$38; also elsewhere on the board
P39: U$1.P$39; also elsewhere on the board
P40: U$1.P$40; also elsewhere on the board
RX3: U$1.P$26; also elsewhere on the board
TX3: U$1.P$27; also elsewhere on the board

Notes on the sheet:
TIVA BOARD (TM4C123G Launch Pad)
FORCE SENSORS INPUT (LEFT LEG)
FORCE SENSORS INPUT (RIGHT LEG)
REMAINING PINS ON TIVA

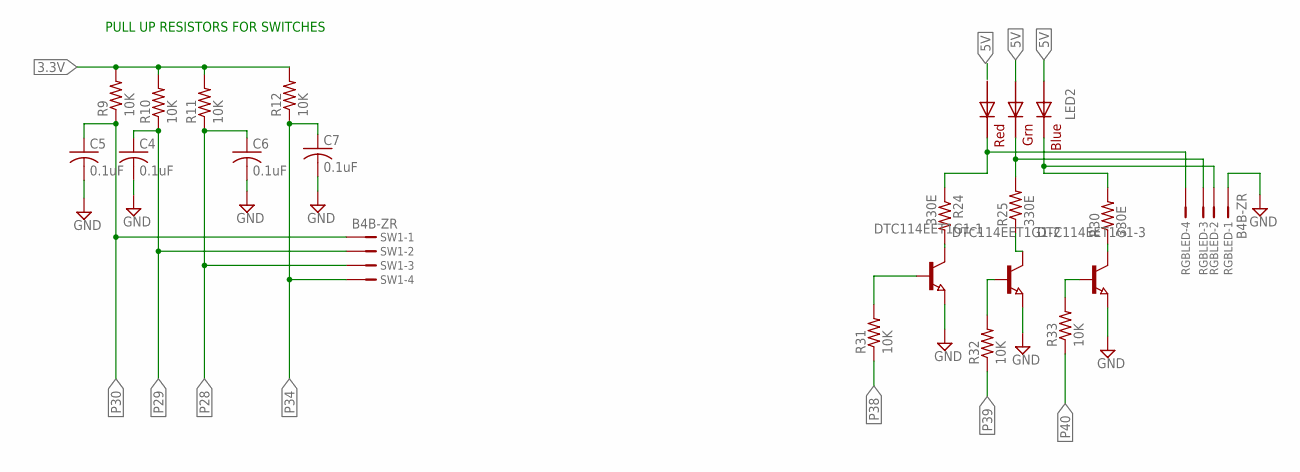
[picture p96: schematic humanoid-9.sch, sheet 9]

Parts:
C4, C5, C6, C7: 0.1uF; C1206; MOUSER_PARTNO 80-C0805C104M5R
DTC114EET1G1-1, DTC114EET1G1-2, DTC114EET1G1-3: NPN-TRANSISTOR_SOT23; SOT23
LED2: RGBLED5050
R9, R10, R11, R12, R31, R32, R33: 10K; R0805
R24, R25, R30: 330E; R0805
RGBLED: B4B-ZR
SW1: B4B-ZR

Connections:
3.3V: R9.2, R10.2, R11.2, R12.2; also elsewhere on the board
5V: LED2.1 (GREEN_A), LED2.3 (BLUE_A); also elsewhere on the board
GND: C4.2, C5.2, C6.2, C7.2, DTC114EET1G1-1.2 (E), DTC114EET1G1-2.2 (E), DTC114EET1G1-3.2 (E), RGBLED.1; also elsewhere on the board
unnamed: LED2.5 (RED_C), R24.1, RGBLED.4
unnamed: LED2.6 (GREEN_C), R25.2, RGBLED.3
unnamed: LED2.4 (BLUE_C), R30.2, RGBLED.2
unnamed: DTC114EET1G1-1.3 (C), R24.2
unnamed: DTC114EET1G1-2.3 (C), R25.1
unnamed: DTC114EET1G1-3.3 (C), R30.1
unnamed: DTC114EET1G1-1.1 (B), R31.2
unnamed: DTC114EET1G1-2.1 (B), R32.2
unnamed: DTC114EET1G1-3.1 (B), R33.2
P28: C6.1, R11.1, SW1.3; also elsewhere on the board
P29: C4.1, R10.1, SW1.2; also elsewhere on the board
P30: C5.1, R9.1, SW1.1; also elsewhere on the board
P34: C7.1, R12.1, SW1.4; also elsewhere on the board
P38: R31.1; also elsewhere on the board
P39: R32.1; also elsewhere on the board
P40: R33.1; also elsewhere on the board

Notes on the sheet:
PULL UP RESISTORS FOR SWITCHES

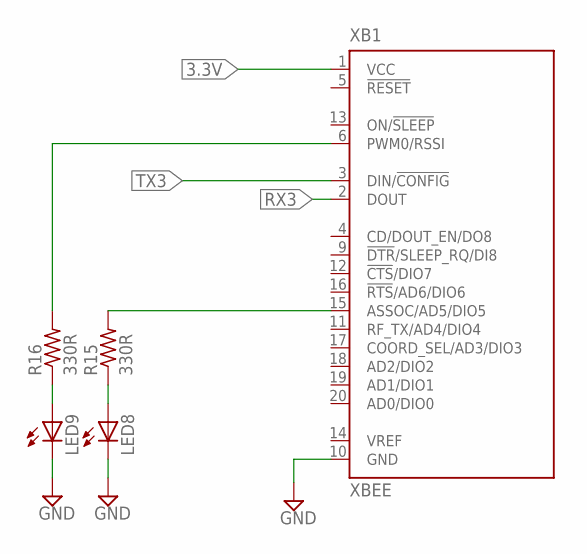
[picture p97: schematic humanoid-9.sch, sheet 10]

Parts:
LED8, LED9: LEDCHIPLED_1206; CHIPLED_1206
R15, R16: 330R; R0805
XB1: XBEE

Connections:
3.3V: XB1.1 (VCC); also elsewhere on the board
GND: LED8.C, LED9.C, XB1.10 (GND); also elsewhere on the board
unnamed: LED8.A, R15.1
unnamed: LED9.A, R16.1
unnamed: R15.2, XB1.15 (ASSOC/AD5/DIO5)
unnamed: R16.2, XB1.6 (PWM0/RSSI)
RX3: XB1.2 (DOUT); also elsewhere on the board
TX3: XB1.3 (DIN/!CONFIG); also elsewhere on the board

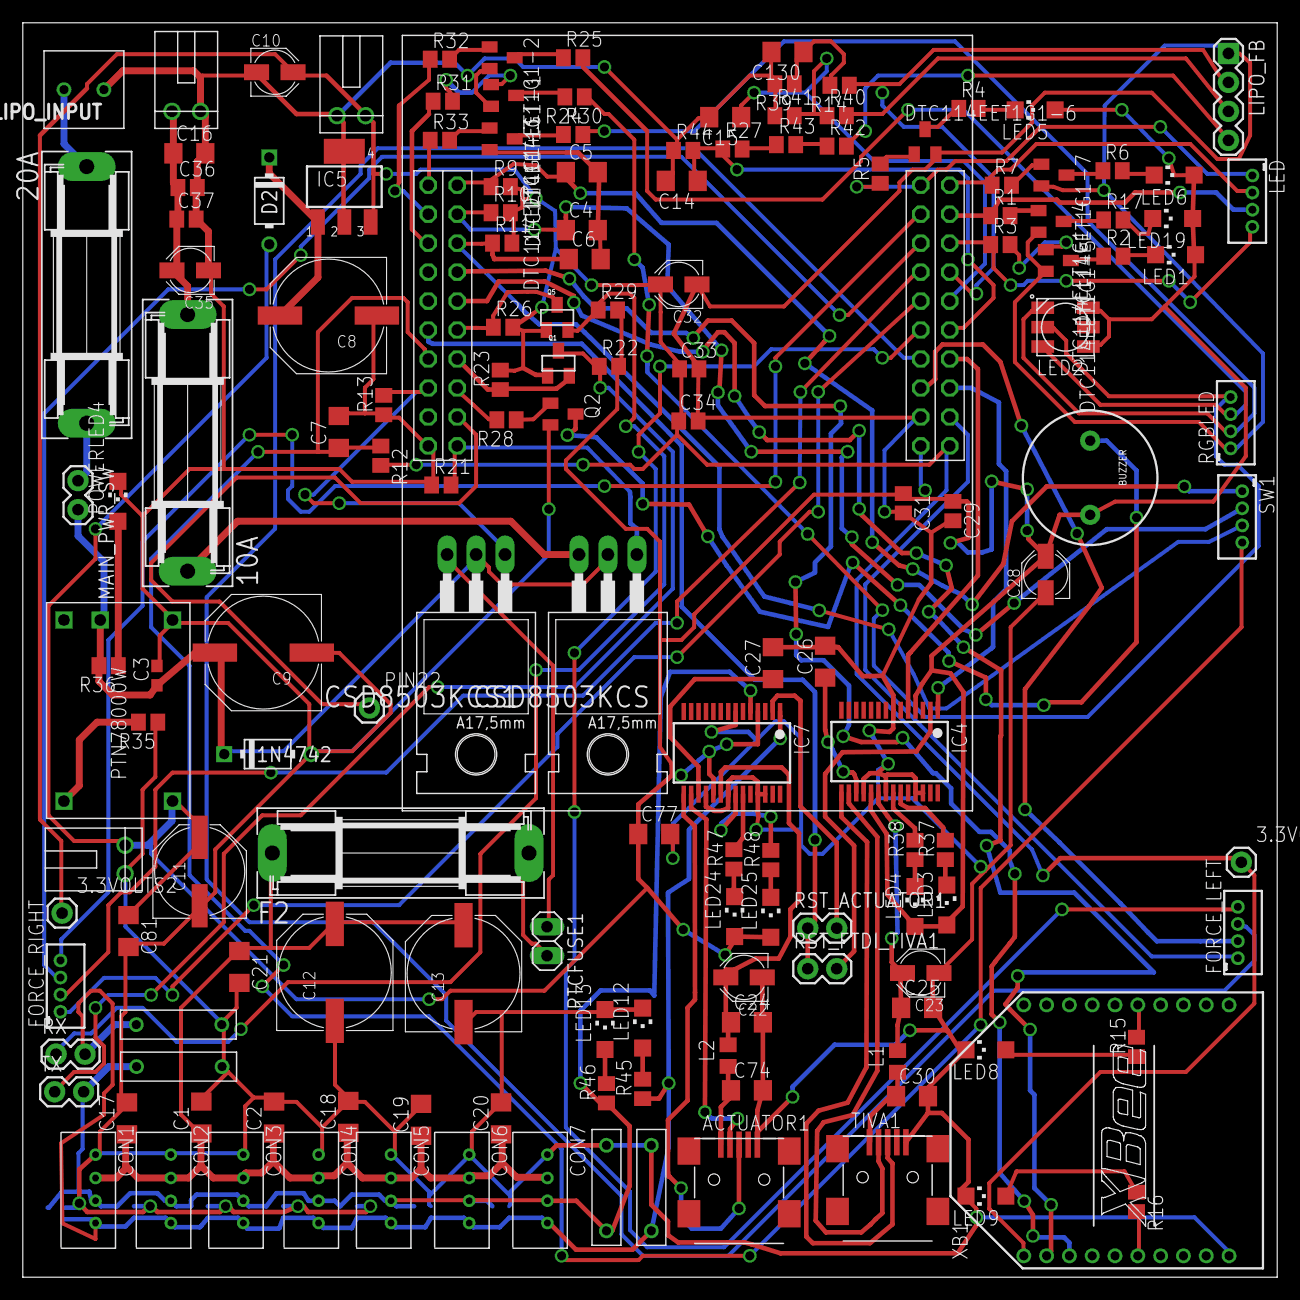
[picture p98: board humanoid-9.brd from above]

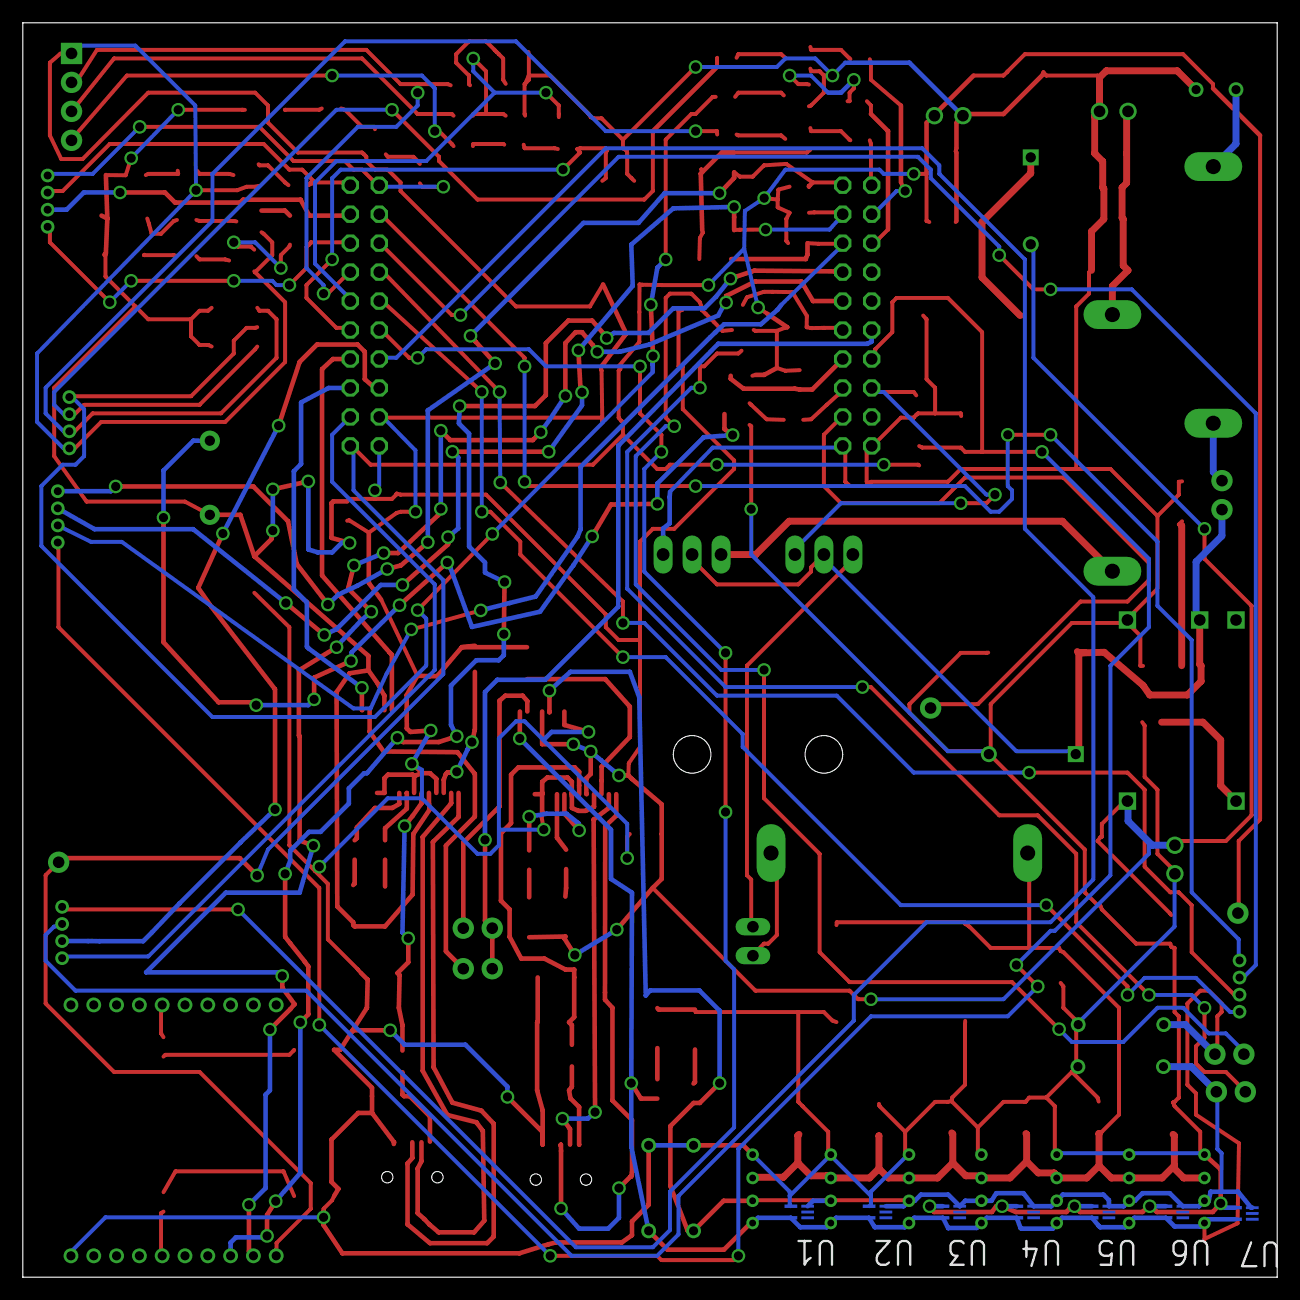
[picture p99: board humanoid-9.brd from below]

Board: 2 copper layers, 110.0 x 110.0 mm, 163 parts (7 on the bottom side), 105 nets.
