IvLabs/HuroCup/Circuit_Cad_Version-1.0/humanoid-3.2/humanoid-17.brd

## EAGLE design Circuit_Cad_Version-1.0/humanoid-3.2/humanoid-17.brd (2016-07-13)

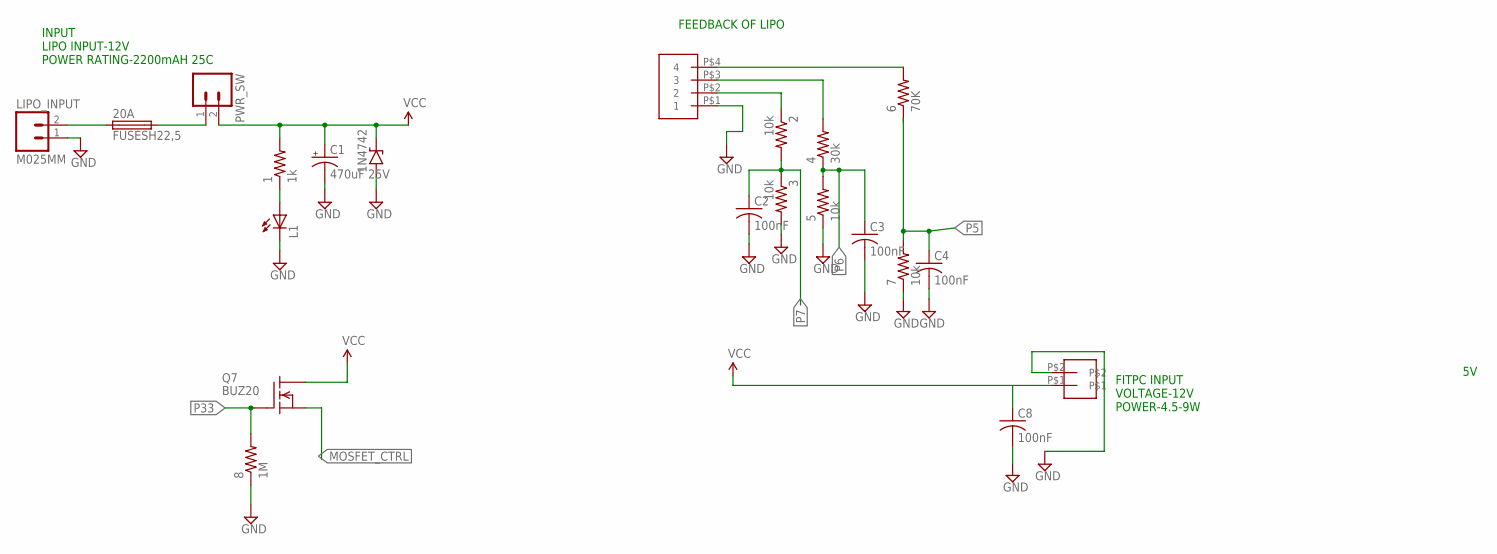
[picture p100: schematic humanoid-17.sch, sheet 1]

Parts:
1: 1k; R0805
1N4742: 1N47XX3; DO41-3
2, 3, 5, 7: 10k; R0805
4: 30k; R0805
6: 70K; R0805
8: 1M; R0805
20A: FUSESH22,5; SH22,5
C1: 470uF 25V; PANASONIC_G; PARTNO EEEFK1E471AP
C2, C3, C4, C8: 100nF; C1206; PARTNO C1206C104K5RACTU
FITPC: 2PINRIGHT
L1: LEDCHIPLED_1206; CHIPLED_1206
LIPO_INPUT: M025MM; SCREWTERMINAL-5MM-2
PWR_SW: M02PTH; 1X02
Q7: BUZ20; TO220
U$2: 4PINRIGHT

Connections:
GND: 1N4742.A, 3.2, 5.1, 7.1, 8.1, C1.-, C2.2, C3.2, C4.2, C8.2, FITPC.P$2, L1.C, LIPO_INPUT.1, U$2.P$1 (1); also elsewhere on the board
LIPO_FB4: 6.2, U$2.P$4 (4)
MOSFET_CTRL: Q7.3 (S); also elsewhere on the board
unnamed: 2.1, U$2.P$2 (2)
unnamed: 20A.2, PWR_SW.1
unnamed: 20A.1, LIPO_INPUT.2
unnamed: 4.2, U$2.P$3 (3)
unnamed: 1.1, L1.A
P5: 6.1, 7.2, C4.1; also elsewhere on the board
P6: 4.1, 5.2, C3.1; also elsewhere on the board
P7: 2.2, 3.1, C2.1; also elsewhere on the board
P33: 8.2, Q7.1 (G); also elsewhere on the board
VCC: 1.2, 1N4742.C, C1.+, C8.1, FITPC.P$1, PWR_SW.2, Q7.2 (D); also elsewhere on the board

Notes on the sheet:
INPUT LIPO INPUT-12V POWER RATING-2200mAH 25C
FITPC INPUT VOLTAGE-12V POWER-4.5-9W
FEEDBACK OF LIPO

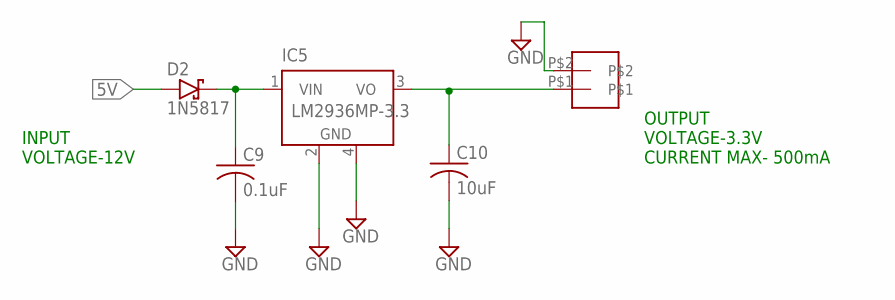
[picture p101: schematic humanoid-17.sch, sheet 2]

Parts:
3.3V1: 2PINRIGHT
C9: 0.1uF; C1206; PARTNO C1206C104K5RACTU
C10: 10uF; C1206; PARTNO C1206C104K5RACTU
D2: 1N5817; DO41-3
IC5: LM2936MP-3.3; SOT223

Connections:
3.3V: 3.3V1.P$1, C10.1, IC5.3 (VO); also elsewhere on the board
5V: D2.A; also elsewhere on the board
GND: 3.3V1.P$2, C9.2, C10.2, IC5.2 (GND), IC5.4 (GND); also elsewhere on the board
unnamed: C9.1, D2.C, IC5.1 (VIN)

Notes on the sheet:
INPUT VOLTAGE-12V
OUTPUT VOLTAGE-3.3V CURRENT MAX- 500mA

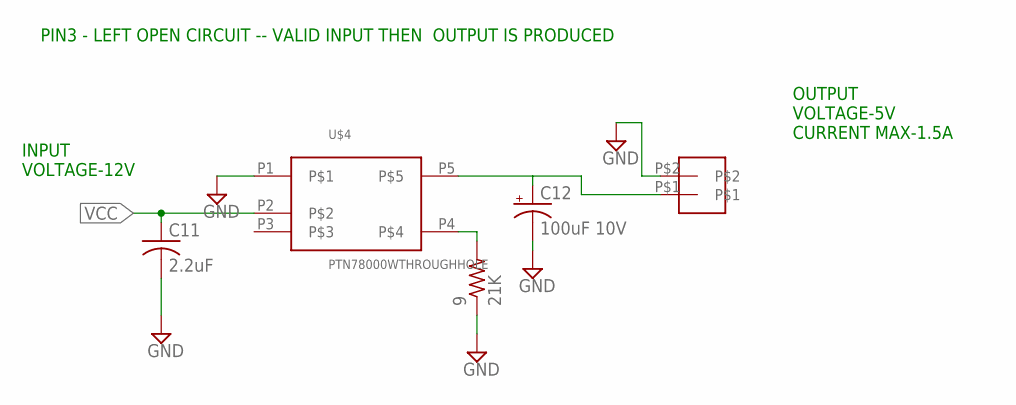
[picture p102: schematic humanoid-17.sch, sheet 3]

Parts:
5V1: 2PINRIGHT
9: 21K; R0805
C11: 2.2uF; C1206; MOUSER_PARTNO 810-C1608X7R1A225K
C12: 100uF 10V; PANASONIC_E; MOUSER_PARTNO 667-EEE-HA1A101P
U$4: PTN78000WTHROUGHHOLE; PTN78000W

Connections:
5V: 5V1.P$1, C12.+, U$4.P5; also elsewhere on the board
GND: 5V1.P$2, 9.1, C11.2, C12.-, U$4.P1; also elsewhere on the board
unnamed: 9.2, U$4.P4
VCC: C11.1, U$4.P2; also elsewhere on the board

Notes on the sheet:
INPUT VOLTAGE-12V
OUTPUT VOLTAGE-5V CURRENT MAX-1.5A
PIN3 - LEFT OPEN CIRCUIT -- VALID INPUT THEN OUTPUT IS PRODUCED

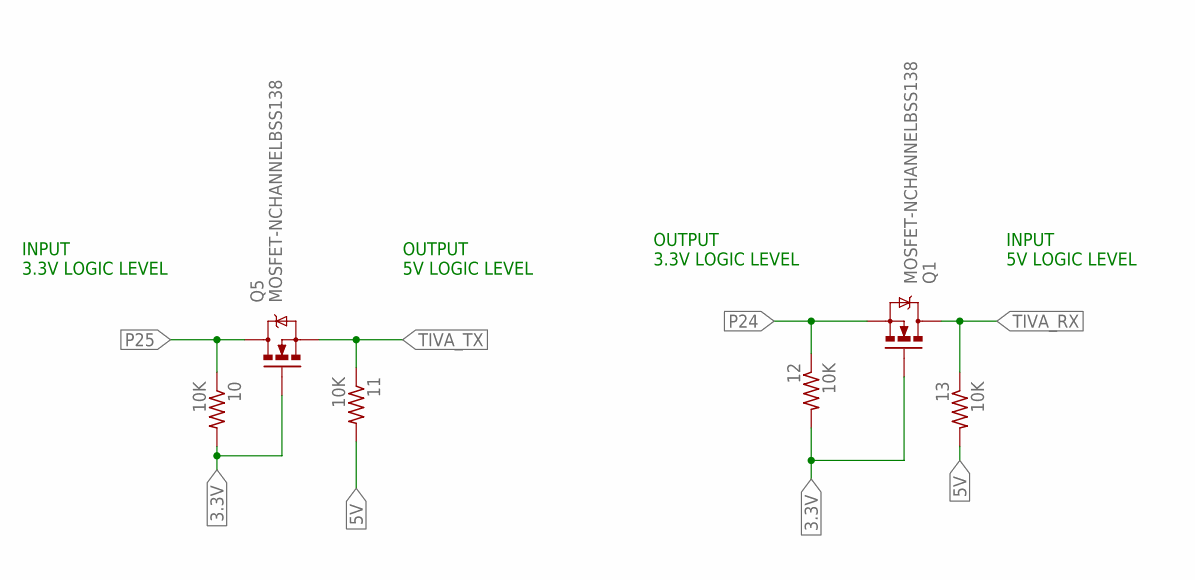
[picture p103: schematic humanoid-17.sch, sheet 4]

Parts:
10, 11, 12, 13: 10K; R0805
Q1, Q5: MOSFET-NCHANNELBSS138; SOT23

Connections:
3.3V: 10.2, 12.2, Q1.1 (G), Q5.1 (G); also elsewhere on the board
5V: 11.2, 13.2; also elsewhere on the board
P24: 12.1, Q1.2 (S); also elsewhere on the board
P25: 10.1, Q5.3 (D); also elsewhere on the board
TIVA_RX: 13.1, Q1.3 (D); also elsewhere on the board
TIVA_TX: 11.1, Q5.2 (S); also elsewhere on the board

Notes on the sheet:
INPUT 3.3V LOGIC LEVEL
OUTPUT 5V LOGIC LEVEL
OUTPUT 3.3V LOGIC LEVEL
INPUT 5V LOGIC LEVEL
