IvLabs/HuroCup/Circuit_Cad_Version-1.0/humanoid-3.2/humanoid-17.brd

## EAGLE design Circuit_Cad_Version-1.0/humanoid-3.2/humanoid-17.brd (continued)

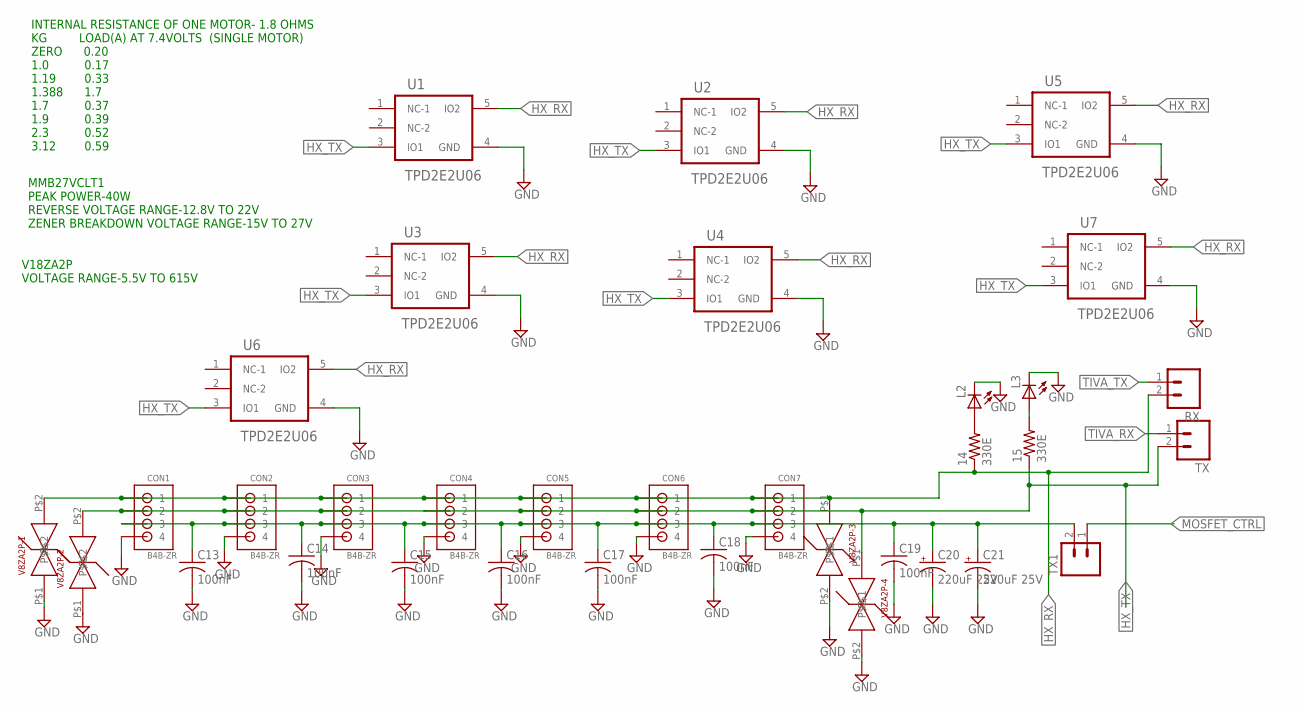
[picture p104: schematic humanoid-17.sch, sheet 5]

Parts:
14, 15: 330E; R0805
C13, C14, C15, C16, C17, C18, C19: 100nF; C1206; PARTNO C1206C104K5RACTU
C20, C21: 220uF 25V; PANASONIC_G; MOUSER_PARTNO 667-EEE-1EA221P
CON1, CON2, CON3, CON4, CON5, CON6, CON7: B4B-ZR; MPN B4B-ZR(LF)(SN)
L2, L3: LEDCHIPLED_1206; CHIPLED_1206
RX: M02PTH; 1X02
TX, TX1: M02PTH; 1X02
U1, U2, U3, U4, U5, U6, U7: TPD2E2U06; SOT50P160X60-5N
V8ZA2P-1, V8ZA2P-2, V8ZA2P-3, V8ZA2P-4: V18ZA2P

Connections:
GND: C13.2, C14.2, C15.2, C16.2, C17.2, C18.2, C19.2, C20.-, C21.-, CON1.4, CON2.4, CON3.4, CON4.4, CON5.4, CON6.4, CON7.4, L2.C, L3.C, U1.4 (GND), U2.4 (GND), U3.4 (GND), U4.4 (GND), U5.4 (GND), U6.4 (GND), U7.4 (GND), V8ZA2P-1.P$1, V8ZA2P-2.P$1, V8ZA2P-3.P$2, V8ZA2P-4.P$2; also elsewhere on the board
HX_RX: 14.1, CON1.1, CON2.1, CON3.1, CON4.1, CON5.1, CON6.1, CON7.1, RX.2, U1.5 (IO2), U2.5 (IO2), U3.5 (IO2), U4.5 (IO2), U5.5 (IO2), U6.5 (IO2), U7.5 (IO2), V8ZA2P-1.P$2, V8ZA2P-3.P$1; also elsewhere on the board
HX_TX: 15.1, CON1.2, CON2.2, CON3.2, CON4.2, CON5.2, CON6.2, CON7.2, TX.2, U1.3 (IO1), U2.3 (IO1), U3.3 (IO1), U4.3 (IO1), U5.3 (IO1), U6.3 (IO1), U7.3 (IO1), V8ZA2P-2.P$2, V8ZA2P-4.P$1; also elsewhere on the board
MOSFET_CTRL: TX1.1; also elsewhere on the board
MOSFET_CTRL1: C13.1, C14.1, C15.1, C16.1, C17.1, C18.1, C19.1, C20.+, C21.+, CON1.3, CON2.3, CON3.3, CON4.3, CON5.3, CON6.3, CON7.3, TX1.2
unnamed: 14.2, L2.A
unnamed: 15.2, L3.A
TIVA_RX: TX.1; also elsewhere on the board
TIVA_TX: RX.1; also elsewhere on the board

Notes on the sheet:
MMB27VCLT1 PEAK POWER-40W REVERSE VOLTAGE RANGE-12.8V TO 22V ZENER BREAKDOWN VOLTAGE RANGE-15V TO 27V
V18ZA2P VOLTAGE RANGE-5.5V TO 615V
INTERNAL RESISTANCE OF ONE MOTOR- 1.8 OHMS KG LOAD(A) AT 7.4VOLTS (SINGLE MOTOR) ZERO 0.20 1.0 0.17 1.19 0.33 1.388 1.7 1.7 0.37 1.9 0.39 2.3 0.52 3.12 0.59

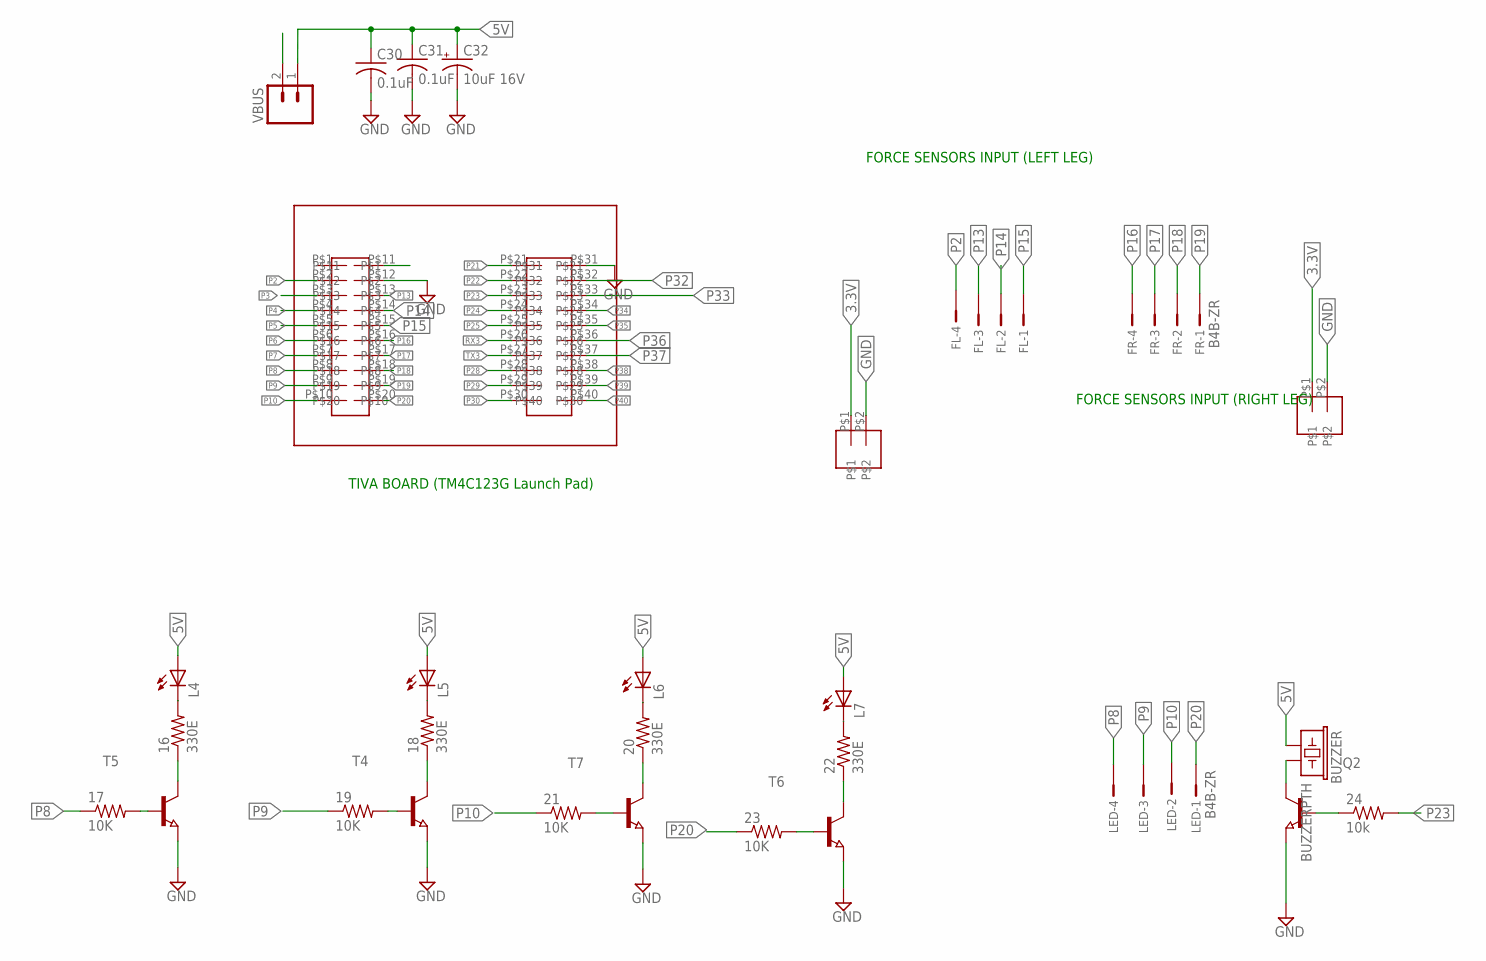
[picture p105: schematic humanoid-17.sch, sheet 6]

Parts:
3.3VL, 3.3VR: 2PINRIGHT
16, 18, 20, 22: 330E; R0805
17, 19, 21, 23: 10K; R0805
24: 10k; R0805
BUZZER: BUZZERPTH; BUZZER-12MM
C30, C31: 0.1uF; C1206
C32: 10uF 16V; PANASONIC_B
FL: B4B-ZR
FR: B4B-ZR
L4, L5, L6, L7: LEDCHIPLED_1206; CHIPLED_1206
LED: B4B-ZR
Q2: NPN-TRANSISTOR_SOT23; SOT23
T4, T5, T6, T7: NPN-TRANSISTOR_SOT23; SOT23
U$1: TIVA
VBUS: M02PTH; 1X02

Connections:
3.3V: 3.3VL.P$1, 3.3VR.P$1; also elsewhere on the board
5V: BUZZER.+ (1), C30.1, C31.1, C32.+, L4.A, L5.A, L6.A, L7.A, VBUS.1; also elsewhere on the board
5VJ: U$1.P$11, VBUS.2
GND: 3.3VL.P$2, 3.3VR.P$2, C30.2, C31.2, C32.-, Q2.2 (E), T4.2 (E), T5.2 (E), T6.2 (E), T7.2 (E), U$1.P$12, U$1.P$31; also elsewhere on the board
unnamed: BUZZER.- (2), Q2.3 (C)
unnamed: 24.1, Q2.1 (B)
unnamed: 19.2, T4.1 (B)
unnamed: 18.2, L5.C
unnamed: 18.1, T4.3 (C)
unnamed: 17.2, T5.1 (B)
unnamed: 16.2, L4.C
unnamed: 16.1, T5.3 (C)
unnamed: 23.2, T6.1 (B)
unnamed: 22.2, L7.C
unnamed: 22.1, T6.3 (C)
unnamed: 21.2, T7.1 (B)
unnamed: 20.2, L6.C
unnamed: 20.1, T7.3 (C)
P2: FL.4, U$1.P$2
P3: U$1.P$3; also elsewhere on the board
P4: U$1.P$4; also elsewhere on the board
P5: U$1.P$5; also elsewhere on the board
P6: U$1.P$6; also elsewhere on the board
P7: U$1.P$7; also elsewhere on the board
P8: 17.1, LED.4, U$1.P$8
P9: 19.1, LED.3, U$1.P$9
P10: 21.1, LED.2, U$1.P$10
P13: FL.3, U$1.P$13
P14: FL.2, U$1.P$14
P15: FL.1, U$1.P$15
P16: FR.4, U$1.P$16
P17: FR.3, U$1.P$17
P18: FR.2, U$1.P$18
P19: FR.1, U$1.P$19
P20: 23.1, LED.1, U$1.P$20
P21: U$1.P$21; also elsewhere on the board
P22: U$1.P$22; also elsewhere on the board
P23: 24.2, U$1.P$23; also elsewhere on the board
P24: U$1.P$24; also elsewhere on the board
P25: U$1.P$25; also elsewhere on the board
P28: U$1.P$28; also elsewhere on the board
P29: U$1.P$29; also elsewhere on the board
P30: U$1.P$30; also elsewhere on the board
P32: U$1.P$32; also elsewhere on the board
P33: U$1.P$33; also elsewhere on the board
P34: U$1.P$34; also elsewhere on the board
P35: U$1.P$35; also elsewhere on the board
P36: U$1.P$36; also elsewhere on the board
P37: U$1.P$37; also elsewhere on the board
P38: U$1.P$38; also elsewhere on the board
P39: U$1.P$39; also elsewhere on the board
P40: U$1.P$40; also elsewhere on the board
RX3: U$1.P$26; also elsewhere on the board
TX3: U$1.P$27; also elsewhere on the board

Notes on the sheet:
TIVA BOARD (TM4C123G Launch Pad)
FORCE SENSORS INPUT (LEFT LEG)
FORCE SENSORS INPUT (RIGHT LEG)

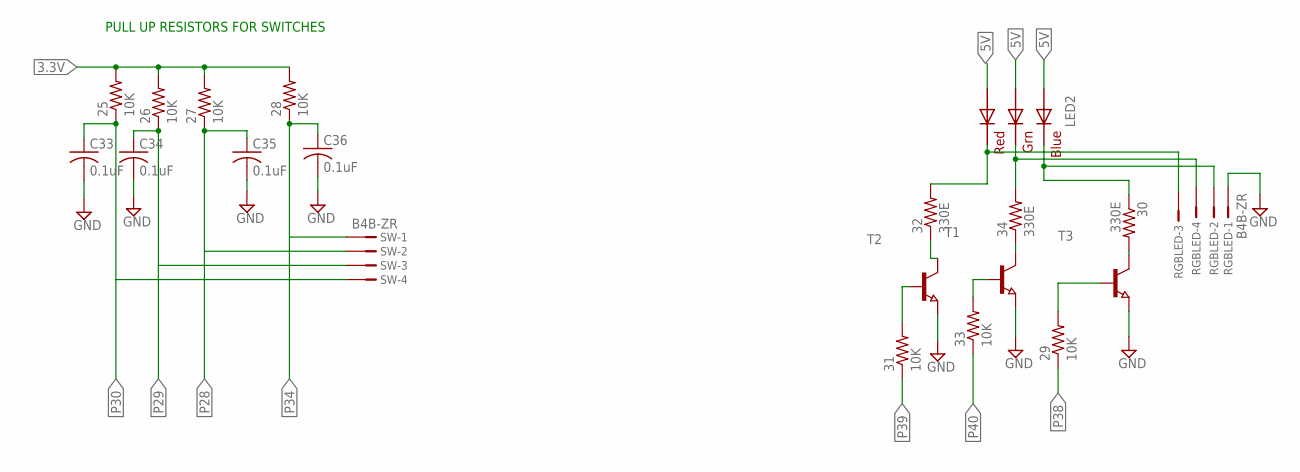
[picture p106: schematic humanoid-17.sch, sheet 7]

Parts:
25, 26, 27, 28, 29, 31, 33: 10K; R0805
30, 32, 34: 330E; R0805
C33, C34, C35, C36: 0.1uF; C1206; MOUSER_PARTNO 80-C0805C104M5R
LED2: RGBLED5050
RGBLED: B4B-ZR
SW: B4B-ZR
T1, T2, T3: NPN-TRANSISTOR_SOT23; SOT23

Connections:
3.3V: 25.2, 26.2, 27.2, 28.2; also elsewhere on the board
5V: LED2.1 (GREEN_A), LED2.2 (RED_A), LED2.3 (BLUE_A); also elsewhere on the board
GND: C33.2, C34.2, C35.2, C36.2, RGBLED.1, T1.2 (E), T2.2 (E), T3.2 (E); also elsewhere on the board
unnamed: 30.1, LED2.4 (BLUE_C), RGBLED.2
unnamed: 32.2, LED2.5 (RED_C), RGBLED.3
unnamed: 34.2, LED2.6 (GREEN_C), RGBLED.4
unnamed: 30.2, T3.3 (C)
unnamed: 32.1, T2.3 (C)
unnamed: 34.1, T1.3 (C)
unnamed: 29.2, T3.1 (B)
unnamed: 31.2, T2.1 (B)
unnamed: 33.2, T1.1 (B)
P28: 27.1, C35.1, SW.2; also elsewhere on the board
P29: 26.1, C34.1, SW.3; also elsewhere on the board
P30: 25.1, C33.1, SW.4; also elsewhere on the board
P34: 28.1, C36.1, SW.1; also elsewhere on the board
P38: 29.1; also elsewhere on the board
P39: 31.1; also elsewhere on the board
P40: 33.1; also elsewhere on the board

Notes on the sheet:
PULL UP RESISTORS FOR SWITCHES

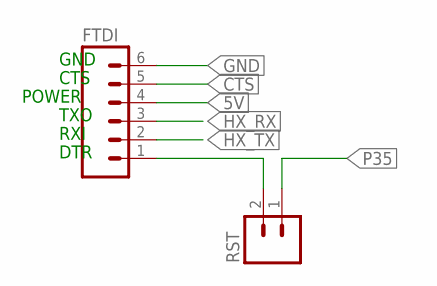
[picture p107: schematic humanoid-17.sch, sheet 8]

Parts:
FTDI: M06LOCK; 1X06_LOCK
RST: M02PTH; 1X02

Connections:
5V: FTDI.4; also elsewhere on the board
CTS: FTDI.5
GND: FTDI.6; also elsewhere on the board
HX_RX: FTDI.3; also elsewhere on the board
HX_TX: FTDI.2; also elsewhere on the board
unnamed: FTDI.1, RST.2
P35: RST.1; also elsewhere on the board

Notes on the sheet:
GND
CTS
POWER
TXO
RXI
DTR

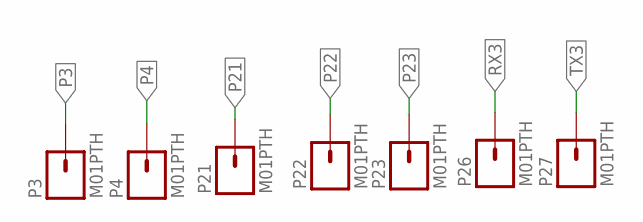
[picture p108: schematic humanoid-17.sch, sheet 9]

Parts:
P3, P4, P21, P22, P23, P26, P27: M01PTH; 1X01

Connections:
P3: P3.1; also elsewhere on the board
P4: P4.1; also elsewhere on the board
P21: P21.1; also elsewhere on the board
P22: P22.1; also elsewhere on the board
P23: P23.1; also elsewhere on the board
RX3: P26.1; also elsewhere on the board
TX3: P27.1; also elsewhere on the board

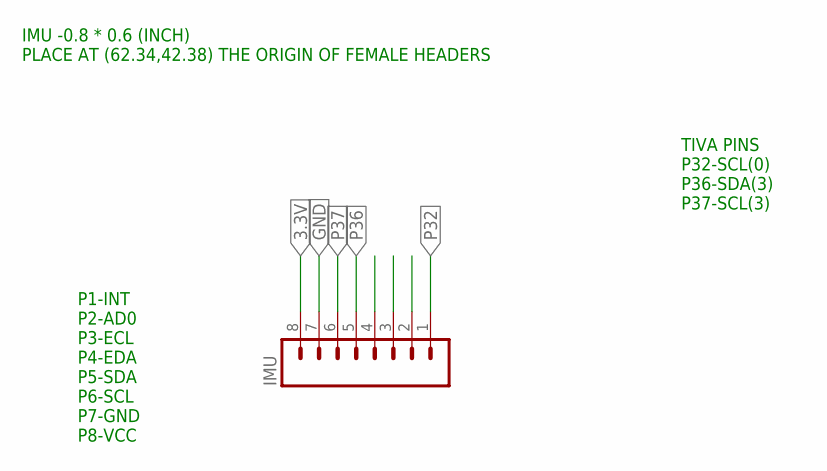
[picture p109: schematic humanoid-17.sch, sheet 10]

Parts:
IMU: M081X08; 1X08

Connections:
3.3V: IMU.8; also elsewhere on the board
GND: IMU.7; also elsewhere on the board
P32: IMU.1; also elsewhere on the board
P36: IMU.5; also elsewhere on the board
P37: IMU.6; also elsewhere on the board

Notes on the sheet:
P1-INT P2-AD0 P3-ECL P4-EDA P5-SDA P6-SCL P7-GND P8-VCC
TIVA PINS P32-SCL(0) P36-SDA(3) P37-SCL(3)
IMU -0.8 * 0.6 (INCH) PLACE AT (62.34,42.38) THE ORIGIN OF FEMALE HEADERS

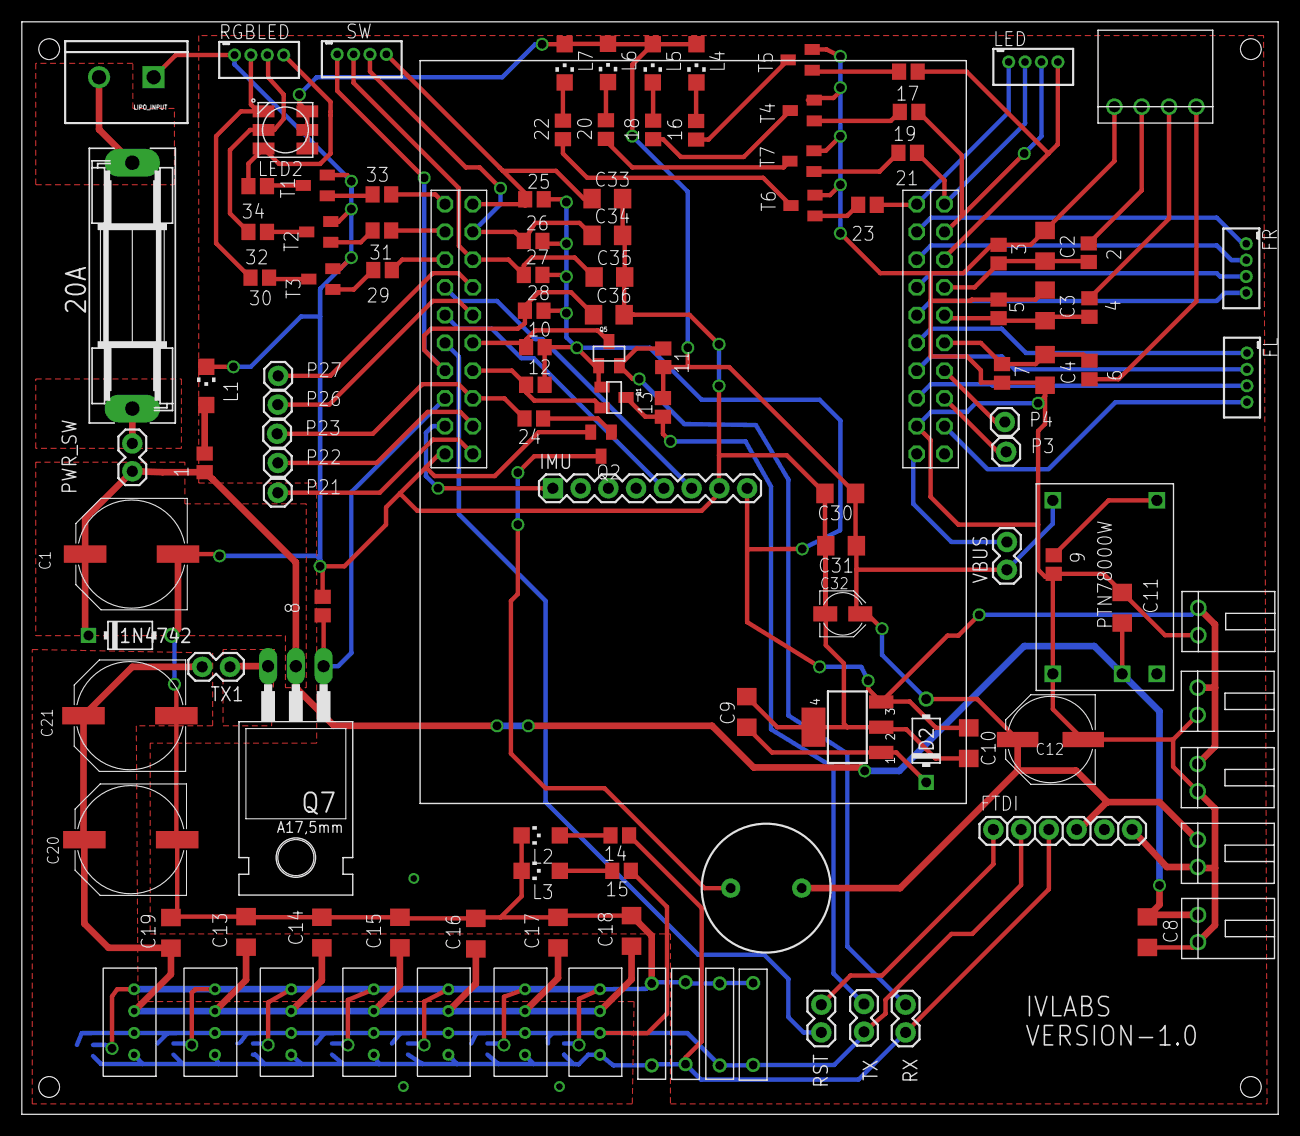
[picture p110: board humanoid-17.brd from above]

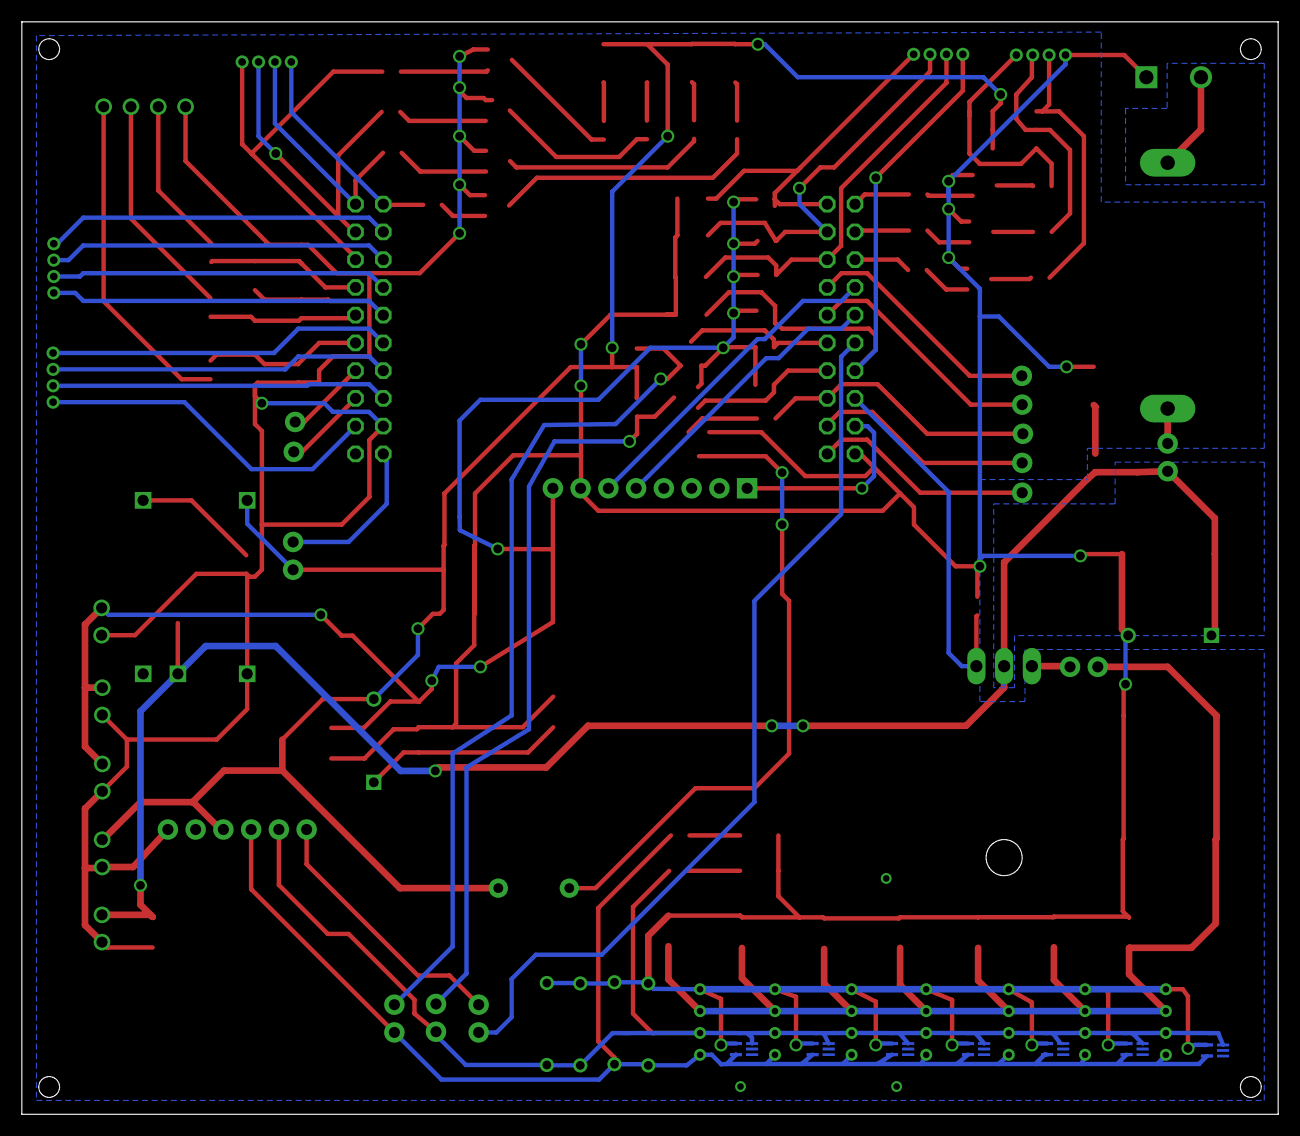
[picture p111: board humanoid-17.brd from below]

Board: 2 copper layers, 115.0 x 100.0 mm, 130 parts (7 on the bottom side), 81 nets.
